rixnobis/ps1-av-capture/hat/renders/crop-buck-ldo.png

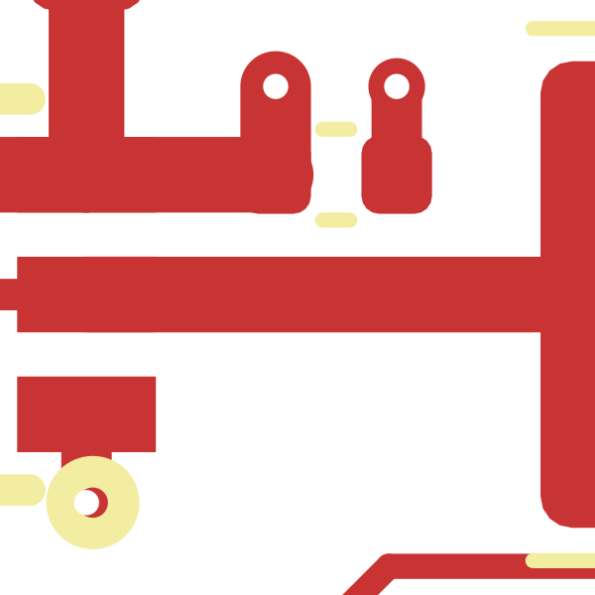
hat/renders/crop-buck-ldo.png
