rixnobis/ps1-av-capture/hat/renders/crop-j3-pcm-usb.png

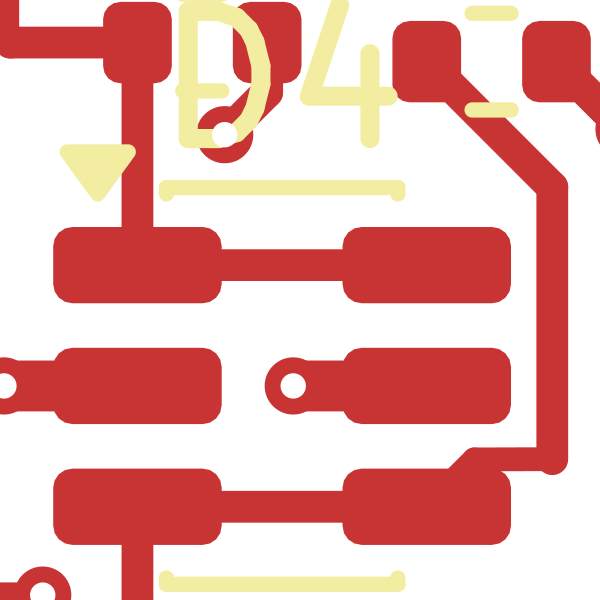
hat/renders/crop-j3-pcm-usb.png
