rixnobis/ps1-av-capture/hat/renders/crop-j4-ctrl.png

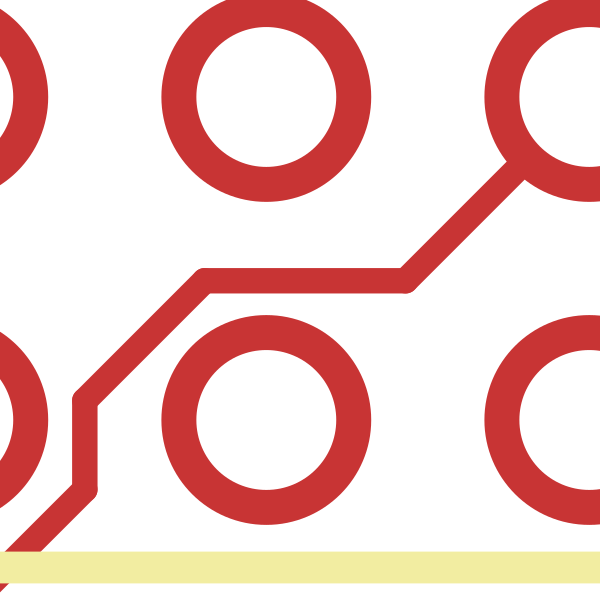
hat/renders/crop-j4-ctrl.png
