rixnobis/ps1-av-capture/hat/renders/crop-j5-data.png

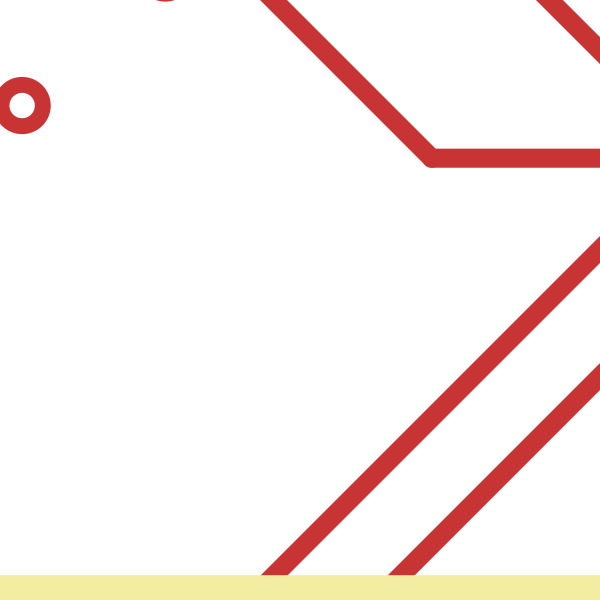
hat/renders/crop-j5-data.png
