rixnobis/ps1-av-capture/hat/renders/crop-tvp-22r.png

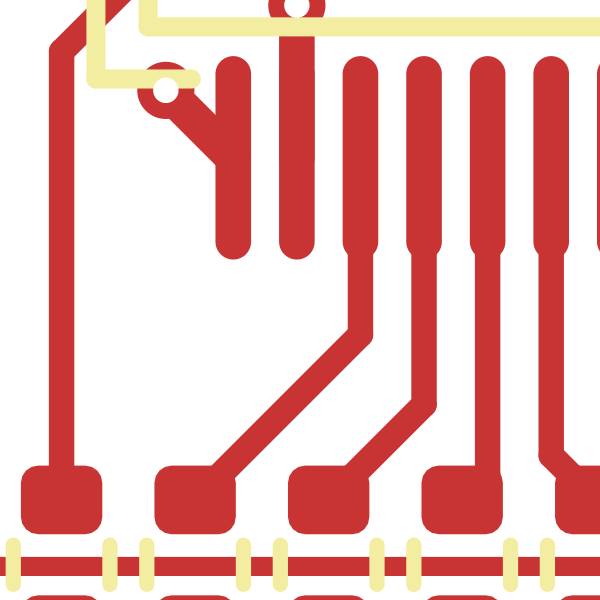
hat/renders/crop-tvp-22r.png
