rixnobis/ps1-av-capture/hat/renders/placement.png

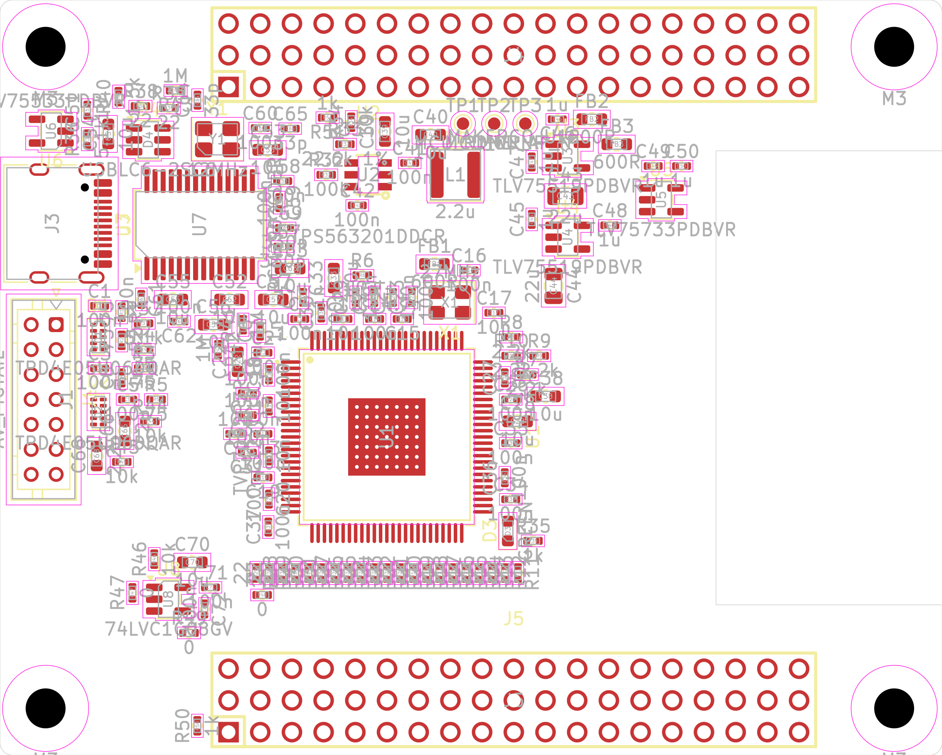
hat/renders/placement.png
