rixnobis/ps1-av-capture/hat/renders/route-bottom.png

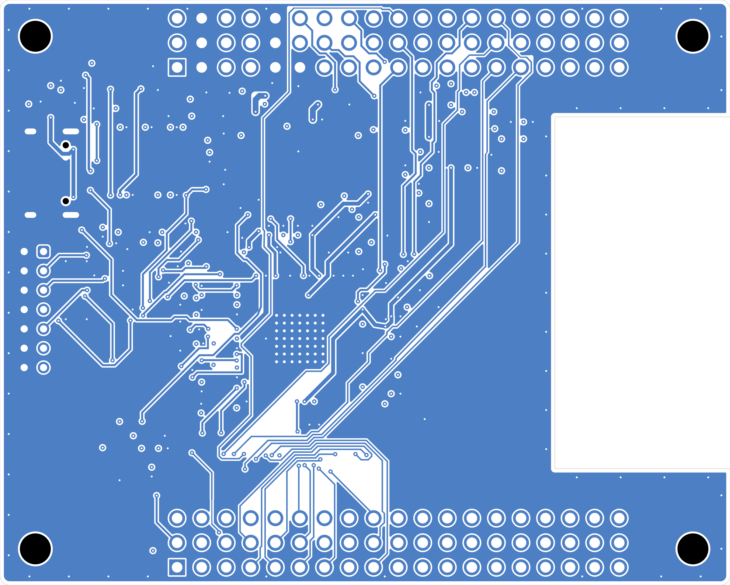
hat/renders/route-bottom.png
