rixnobis/ps1-av-capture/hat/renders/route-in2.png

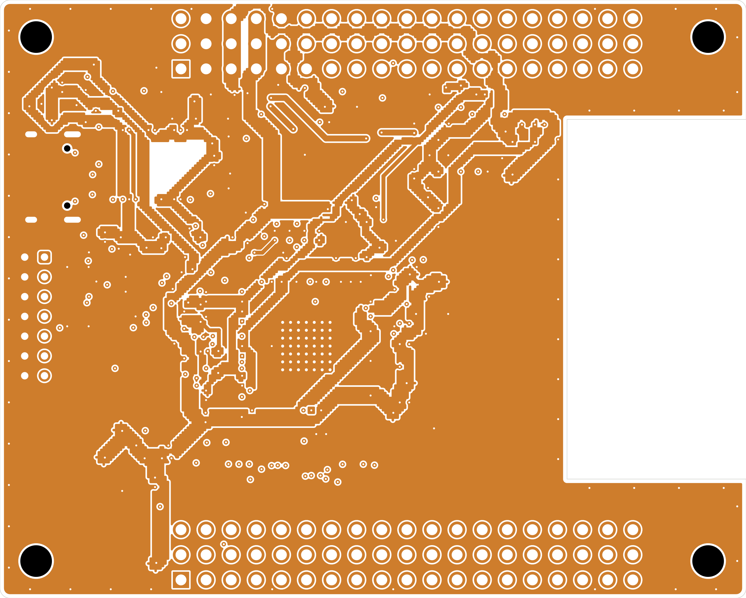
hat/renders/route-in2.png
