rixnobis/ps1-av-capture/hat/renders/route-top.png

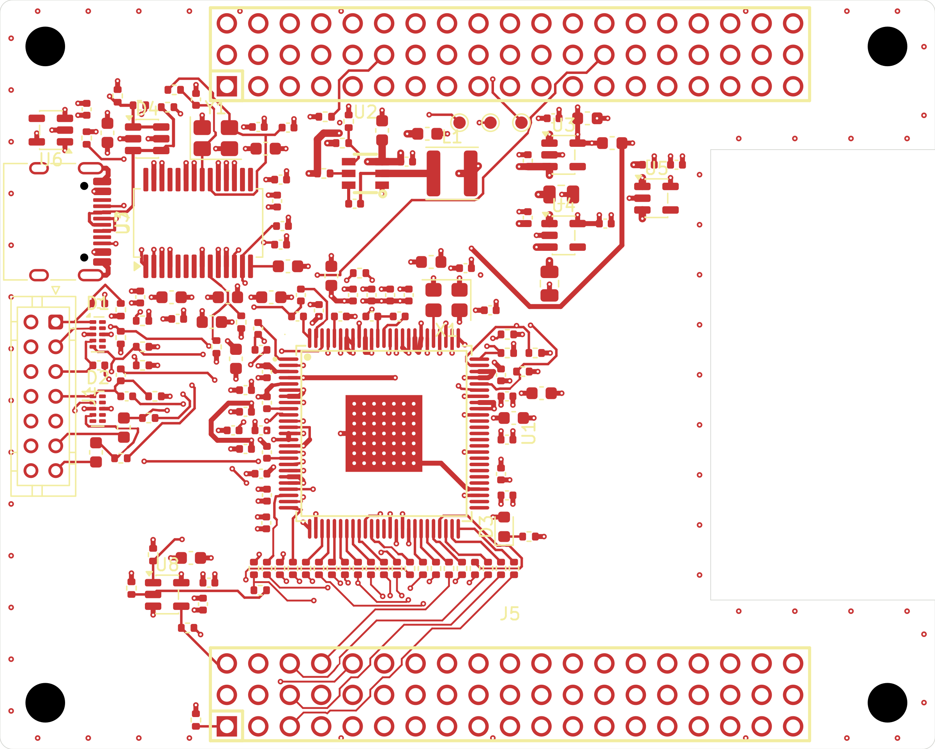
hat/renders/route-top.png
