rixnobis/ps1-av-capture/hat/renders/tidy-a-tvp-north.png

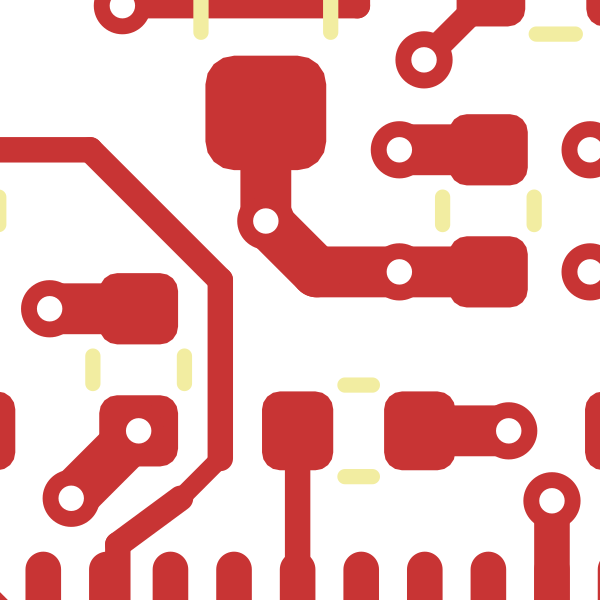
hat/renders/tidy-a-tvp-north.png
