rixnobis/ps1-av-capture/hat/renders/tidy-b-input-west.png

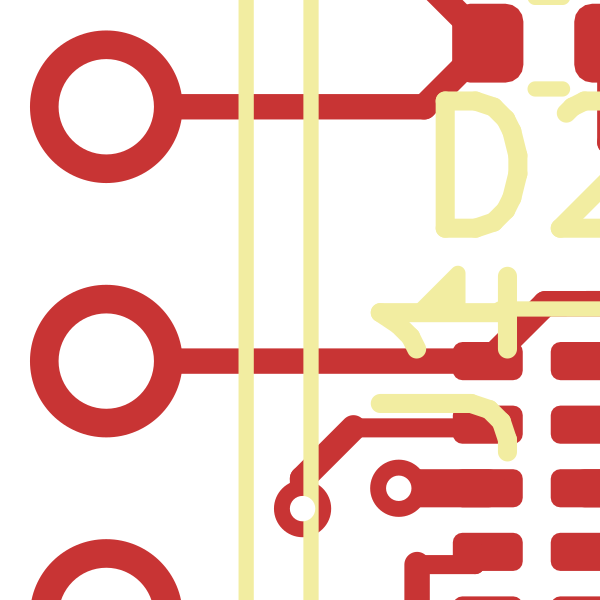
hat/renders/tidy-b-input-west.png
