rixnobis/ps1-av-capture/hat/renders/tidy-c-east.png

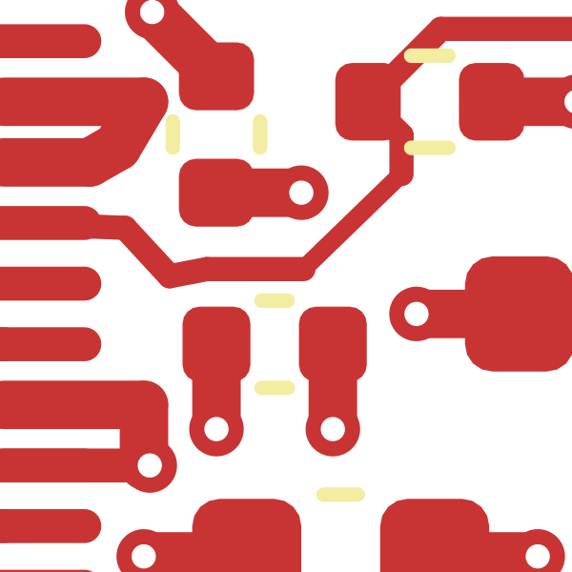
hat/renders/tidy-c-east.png
