rixnobis/ps1-av-capture/renders/placement.png

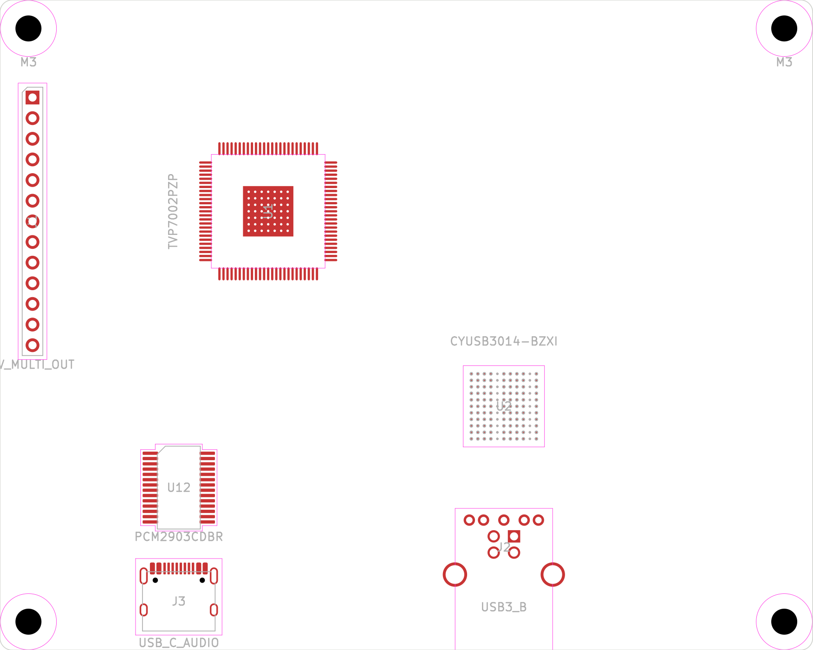
renders/placement.png
