rixnobis/ps1-av-capture/tools/pins/fx3.csv

ball | name
A1 | U3VSSQ
A2 | U3RXVDDQ
A3 | SSRXM
A4 | SSRXP
A5 | SSTXP
A6 | SSTXM
A7 | AVDD
A8 | VSS
A9 | DP
A10 | DM
A11 | NC
B1 | VIO4
B2 | FSLC[0]
B3 | R_USB3
B4 | FSLC[1]
B5 | U3TXVDDQ
B6 | CVDDQ
B7 | AVSS
B8 | VSS
B9 | VSS
B10 | VDD
B11 | TRST#
C1 | GPIO[54]
C2 | GPIO[55]
C3 | VDD
C4 | GPIO[57]
C5 | RESET#
C6 | XTALIN
C7 | XTALOUT
C8 | R_USB2
C9 | OTG_ID
C10 | TDO
C11 | VIO5
D1 | GPIO[50]
D2 | GPIO[51]
D3 | GPIO[52]
D4 | GPIO[53]
D5 | GPIO[56]
D6 | CLKIN_32
D7 | CLKIN
D8 | VSS
D9 | I2C_GPIO[58]
D10 | I2C_GPIO[59]
D11 | NC
E1 | GPIO[47]
E2 | VSS
E3 | VIO3
E4 | GPIO[49]
E5 | GPIO[48]
E6 | FSLC[2]
E7 | TDI
E8 | TMS
E9 | VDD
E10 | VBATT
E11 | VBUS
F1 | VIO2
F2 | GPIO[45]
F3 | GPIO[44]
F4 | GPIO[41]
F5 | GPIO[46]
F6 | TCK
F7 | GPIO[2]
F8 | GPIO[5]
F9 | GPIO[1]
F10 | GPIO[0]
F11 | VDD
G1 | VSS
G2 | GPIO[42]
G3 | GPIO[43]
G4 | GPIO[30]
G5 | GPIO[25]
G6 | GPIO[22]
G7 | GPIO[21]
G8 | GPIO[15]
G9 | GPIO[4]
G10 | GPIO[3]
G11 | VSS
H1 | VDD
H2 | GPIO[39]
H3 | GPIO[40]
H4 | GPIO[31]
H5 | GPIO[29]
H6 | GPIO[26]
H7 | GPIO[20]
H8 | GPIO[24]
H9 | GPIO[7]
H10 | GPIO[6]
H11 | VIO1
J1 | GPIO[38]
J2 | GPIO[36]
J3 | GPIO[37]
J4 | GPIO[34]
J5 | GPIO[28]
J6 | GPIO[16]
J7 | GPIO[19]
J8 | GPIO[14]
J9 | GPIO[9]
J10 | GPIO[8]
J11 | VDD
K1 | GPIO[35]
K2 | GPIO[33]
K3 | VSS
K4 | VSS
K5 | GPIO[27]
K6 | GPIO[23]
K7 | GPIO[18]
K8 | GPIO[17]
K9 | GPIO[13]
K10 | GPIO[12]
K11 | GPIO[10]
L1 | VSS
L2 | VSS
L3 | VSS
L4 | GPIO[32]
L5 | VDD
L6 | VSS
L7 | VDD
L8 | INT#
L9 | VIO1
L10 | GPIO[11]
L11 | VSS
