rixnobis/ps1-av-capture/schematic.pdf

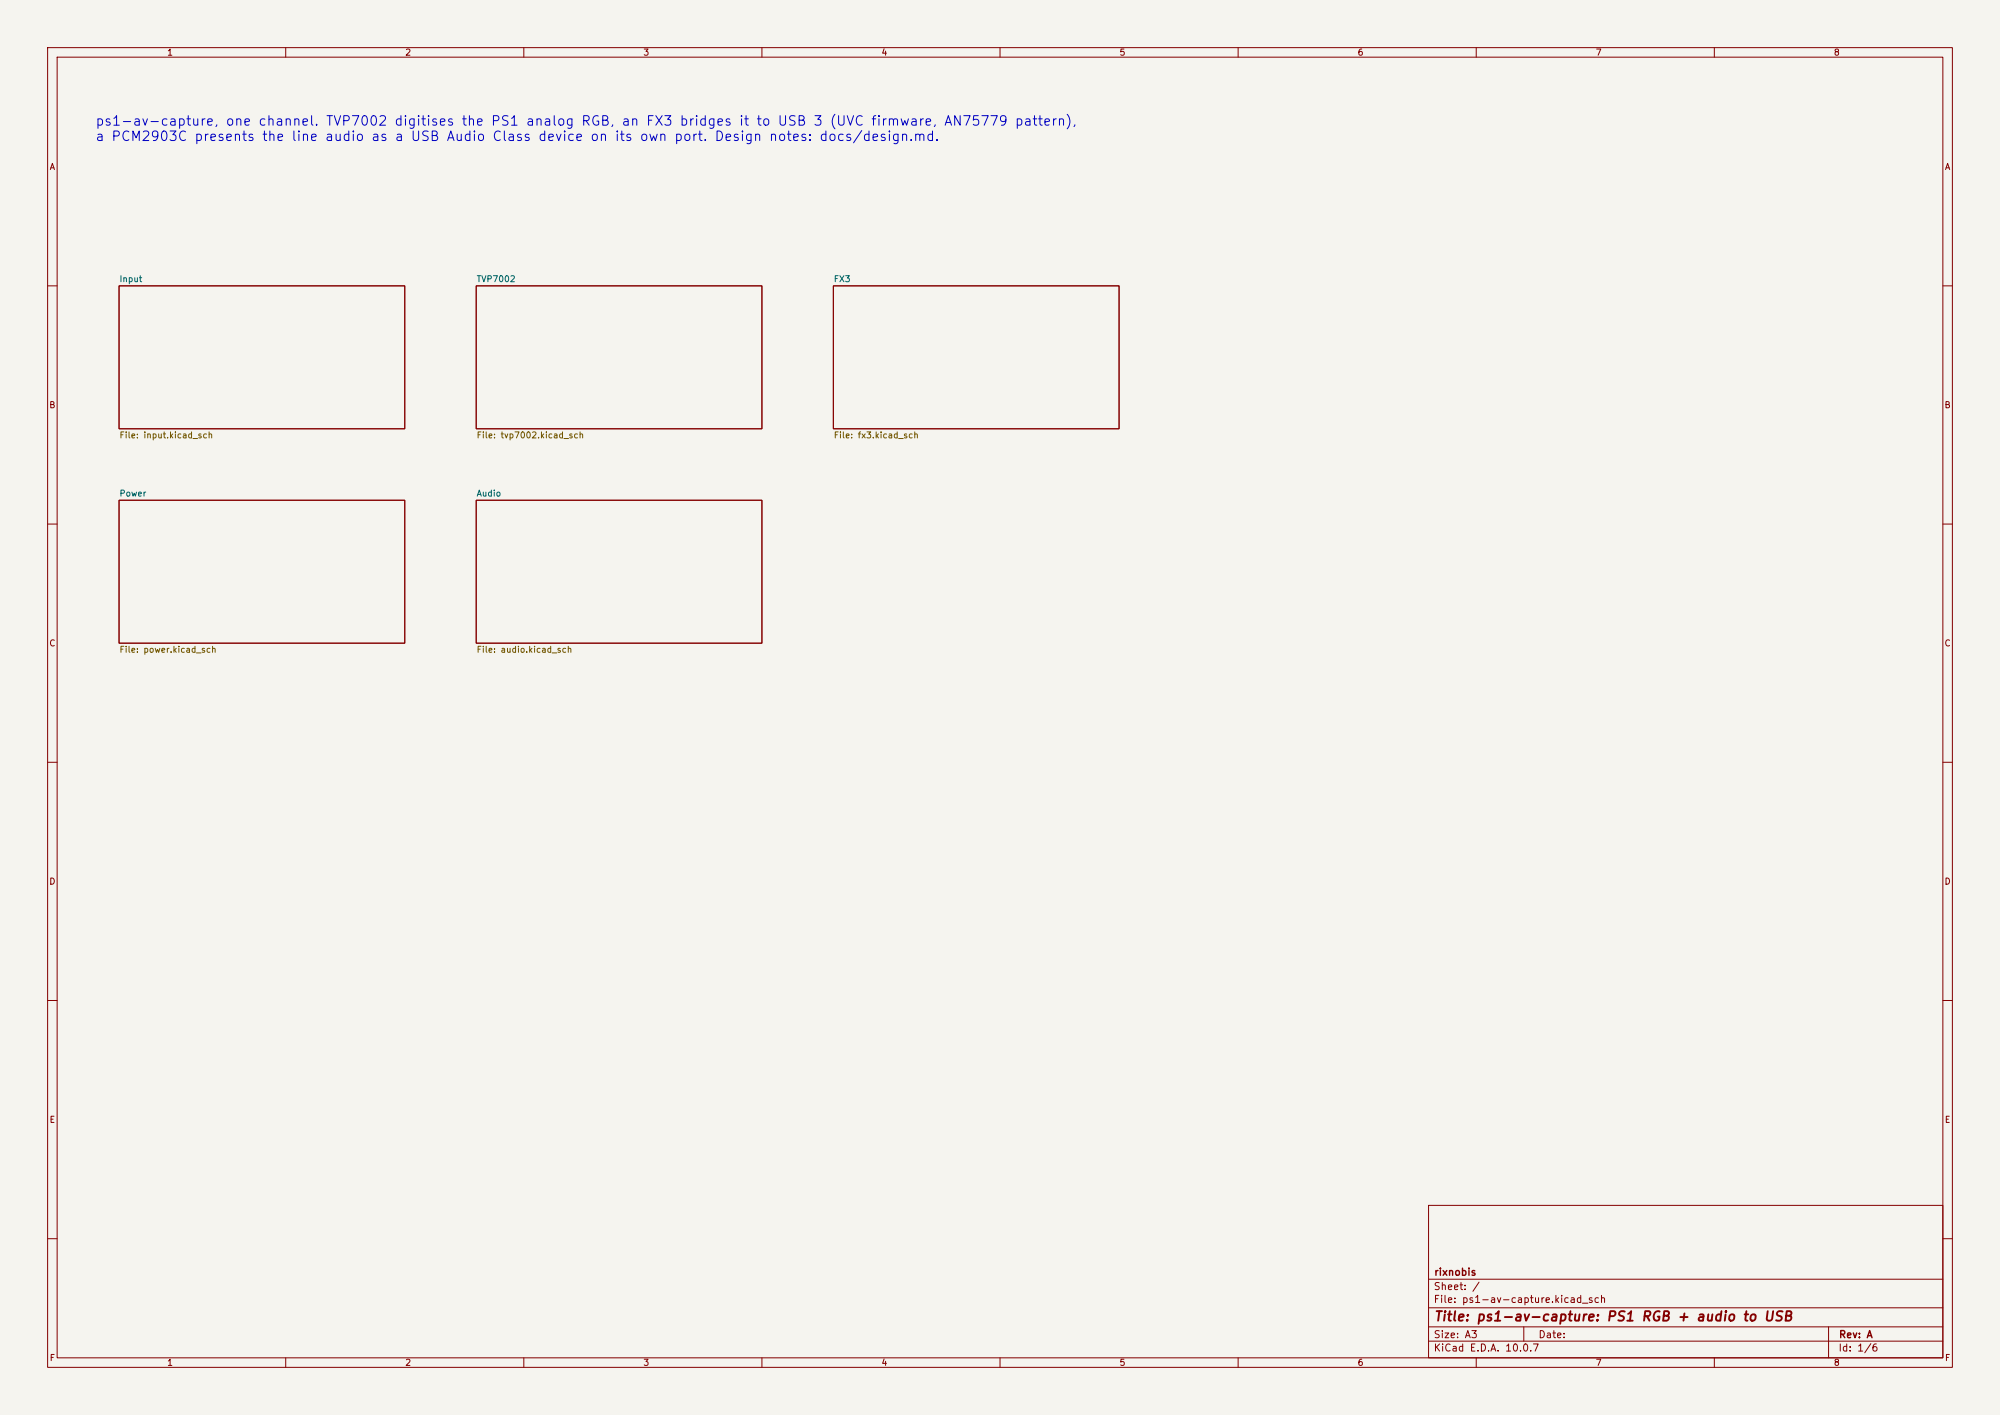
[picture p14: page 1]

File: audio.kicad_sch ps1-av-capture, one channel. TVP7002 digitises the PS1 analog RGB, an FX3 bridges it to USB 3 (UVC firmware, AN75779 pattern), a PCM2903C presents the line audio as a USB Audio Class device on its own port. Design notes: docs/design.md.

File: fx3.kicad_sch Power File: power.kicad_sch

rixnobis
Sheet: /
File: ps1-av-capture.kicad_sch
Title: ps1-av-capture: PS1 RGB + audio to USB

Size: A3 | Rev: A | F Date:
KiCad E.D.A. 10.0.7 | Id: 1/6

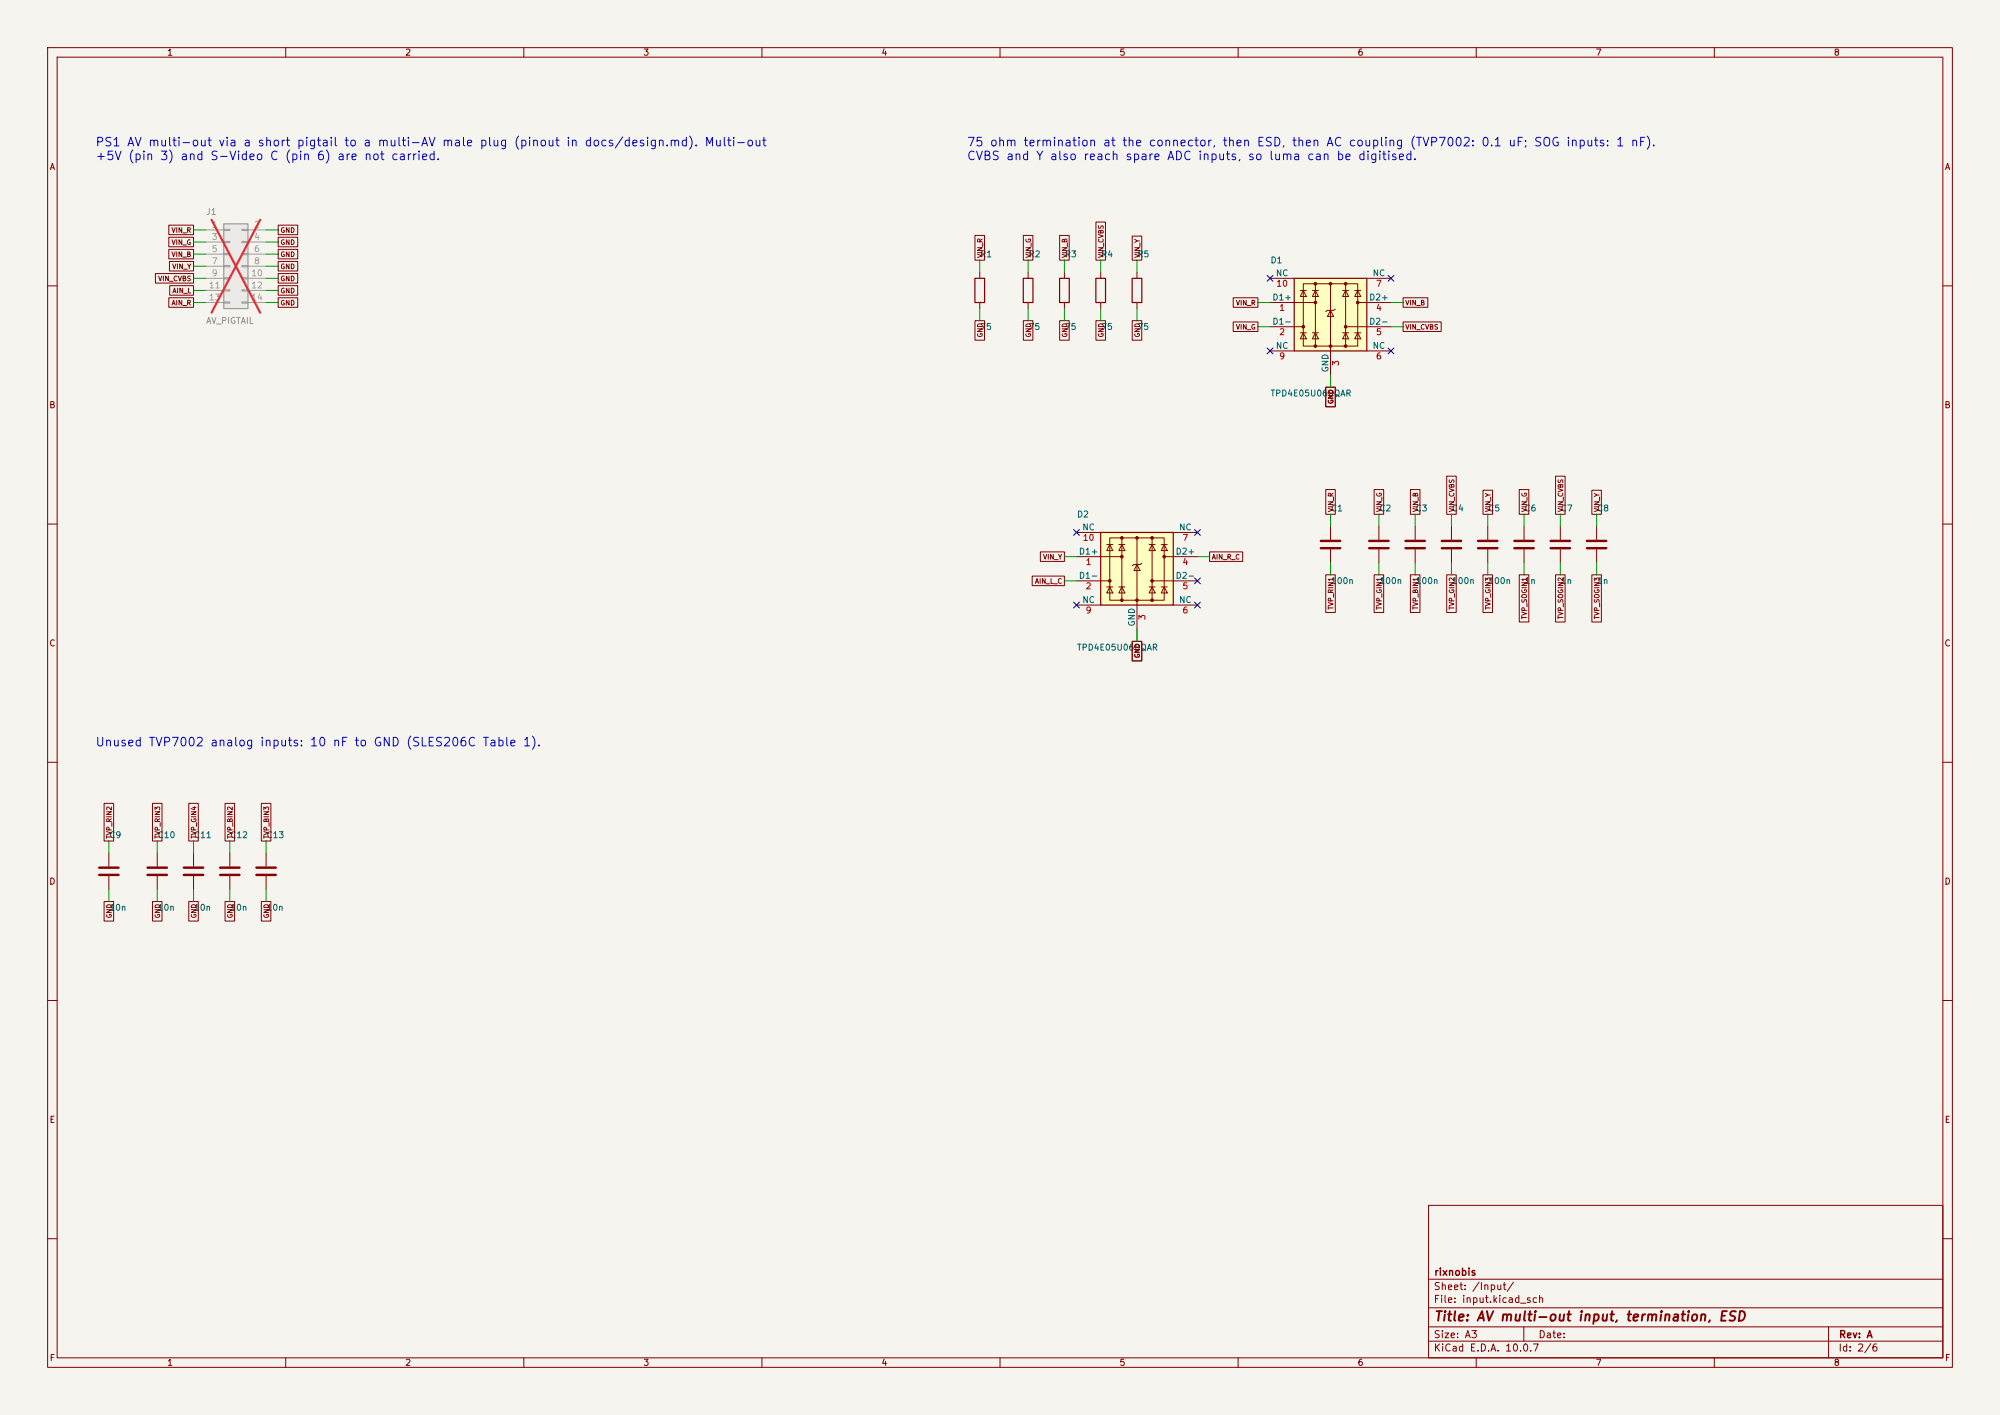
[picture p15: page 2]

PS1 AV multi-out via a short pigtail to a multi-AV male plug (pinout in docs/design.md). Multi-out
+5V (pin 3) and S-Video C (pin 6) are not carried.

75 ohm termination at the connector, then ESD, then AC coupling (TVP7002: 0.1 uF; SOG inputs: 1 nF).
CVBS and Y also reach spare ADC inputs, so luma can be digitised.

Unused TVP7002 analog inputs: 10 nF to GND (SLES206C Table 1).

rixnobis
Sheet: /Input/
File: input.kicad_sch
Title: AV multi-out input, termination, ESD

1 | 2 | 3 | 4 | 5 | 6 | 7 | 8 | 9 | 10 | 11

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
### FGH Date:

Size: A2 | Rev: A

## Title: TVP7002 RGB digitiser

### File: tvp7002.kicad_sch

### Sheet: /TVP7002/

rixnobis

R34

22R13

22

C15

4.7n

C26

100n C27

100n

C14

100n

C24

100n R9

22 | C25

1u R10

22 | R35

22 R11

22 R12

22R33

22 | R14
22 | R15

22 R32

22 R31

22 | C31
100n | C32
100n | C33

10u R16

22 R17

22

SOGIN_1 1 | GIN_1 2 | RIN_3 9 | RIN_2 10 | RIN_1 11 | BIN_3 16 | BIN_2 17 | BIN_1 18
FIDOUT | 22
VSOUT | 23 HSOUT | 24
SOGOUT | 25 PWDN | 70 RESETB | 71
TMS | 72
I2CA | 73
SCL | 74
SDA | 75 CLAMP 76 | COAST 77

VSYNC_A 78
VSYNC_B 79
EXT_CLK 80 | HSYNC_A 81 | HSYNC_B 82

FILT1 87
FILT2 88 | PLL_F 89 | GIN_4 96
SOGIN_3 97 | GIN_3 98
SOGIN_2 99 | GIN_2 100 U1A

TVP7002PZP

C19

100n

AGND 3

AVDD 4
AGND 5

AVDD 6
AVDD 7
AGND | 8
A33GND | 12 A33VDD 13
A33VDD 14 | A33GND | 15
AVDD 19 | AGND | 20 NSUB | 21 IOVDD 26
IOGND | 27 DVDD 39 | GND | 40 IOVDD 41
IOGND | 42 IOVDD 53
IOGND | 54
IOGND | 60 IOVDD 66
IOGND | 67 GND | 68 DVDD 69 | PLL_AGND | 83 PLL_AVDD 84 | PLL_AVDD 85 | PLL_AGND | 86 PLL_AGND | 90 NSUB | 91
A33GND | 92

A33VDD 93
A33VDD 94

A33GND 95

# EP 101 U1C

TVP7002PZP

C18

100n

FB3

600R

C20

100n C38

10u C37

100n | C21
100n | C22

10u

DATACLK | 28 B_9 | 29 B_8 | 30 B_7 | 31 B_6 | 32 B_5 | 33 B_4 | 34 B_3 | 35 B_2 | 36 B_1 | 37 B_0 | 38 G_9 43 | G_8 44 | G_7 45 | G_6 46 | G_5 47 | G_4 48 | G_3 | 49 G_2 | 50 G_1 | 51 G_0 | 52 R_9 55 | R_8 56 | R_7 57 | R_6 58 | R_5 59 | R_4 61 | R_3 62 | R_2 63 | R_1 64 | R_0 65U1B

TVP7002PZP

FB2

600R

R6

1.5k

EN 1 GND

2 OUT 3 Vdd 4

X1
27MHz | R29
22 | C28

10u R28

22

FB1

600R

R8

2.2k R7
2.2k C23

100n C16

100n | C17
10n | C30

100n R24

22 R23

22 R37

22 | C36

100n C35

100n R25

22 R22

22 R21

22 R36

22 | R20
22 | R26
22 | R27

22 R18

22 | C29
100n | C34

100n R19

22 R30

22

GND | VD_SOG | VD_R3 | TVP_PLLVDD

GND

GND | VD_R4
GND | TVP_AVDD TVP_R2 | TVP_AVDD

GND

GND | +1V9A

GND

GND | TVP_AVDD GND | TVP_R6
OSC_VDD | TVP_SOGOUT | TVP_G9
TVP_EXTCLK | GND
GND | GND
GND | GND | GND TVP_AVDD | TVP_AVDD
GND | +1V9A TVP_R3

GND

GND | TVP_R4

GND

GND

GND | VD_R2
GND | GND
GND | +3V3

GND

GND | +3V3 | TVP_AVDD
GND | TVP_B7 VD_B2 | VD_G7 TVP_R9 VD_B3 | TVP_G5 TVP_DATACLK VD_B4 | VD_B5 | TVP_G6 VD_VS TVP_B5 | TVP_B6 | VD_FID TVP_R8 | TVP_B8 VD_B8 | VD_G5 VD_R7 | VD_B9 | VD_G4 TVP_G3 VD_G2 | VD_G3 VD_R9 | TVP_B9 | TVP_G2 VD_R8 | VD_B7 | TVP_R5 OSC_VDD | GND | TVP_G4 | VD_G8 | VD_G9 | VD_R6 +3V3 | OSC_VDD | OSC_VDD | VD_HS VD_PCLK GND OSC_VDD | TVP_G8 TVP_FIDOUT VD_B6 TVP_R7 | TVP_VSOUT | TVP_G7 VD_G6 | VD_R5 TVP_B2 | TVP_B3 | TVP_B4 | TVP_HSOUT
GND | GND TVP_FILT1 | TVP_FILT1R
TVP_B3 | TVP_FILT2 | GND
+3V3A | GND GND
TVP_DATACLK | GND TVP_PLLF | TVP_PLLF | GND +1V9D | GND +1V9D TVP_RESETn | GND TVP_PWDN
TVP_EXTCLK | GND

# TVP_SOGIN1 GND

TVP_GIN1

TVP_RIN3

TVP_RIN2

TVP_FIDOUT GND

TVP_VSOUT | +3V3A | GND | GND

TVP_B9

TVP_G3

TVP_G2 | TVP_FILT1R TVP_B4
TVP_G6 | GND

TVP_B5

TVP_G5 | +3V3A
TVP_G4 | +3V3 GND
TVP_RIN1 | +3V3A

TVP_B6

TVP_B7 | +3V3A

TVP_R9

TVP_B8

TVP_R8

TVP_R7

TVP_R6

TVP_R5

TVP_R4

TVP_R3

TVP_R2

TVP_B2

TVP_AVDD

TVP_PLLF

I2C_SCL | +3V3

TVP_GIN4

TVP_SOGIN3

TVP_GIN3

TVP_SOGIN2 | GND | GND | GND
TVP_GIN2 | GND

TVP_AVDD

TVP_AVDD

TVP_SOGOUT +3V3A +3V3A

TVP_AVDD +3V3 | GND
+1V9D +3V3 +3V3 | GND

+3V3 +1V9D

TVP_PLLVDD

TVP_PLLVDD +3V3A

TVP_G8 | +3V3
GND | +1V9D

GND

TVP_RESETn

TVP_BIN1

TVP_G9 | GND | +3V3A
TVP_BIN2 | TVP_PLLVDD
TVP_G7 | TVP_PLLVDD

TVP_PWDN

TVP_BIN3 | TVP_PLLVDD

I2C_SDA

TVP_HSOUT

TVP_FILT2 GND
TVP_FILT1 | Supply decoupling. SLES206C gives no values; this follows the OSSC: ferrites on AVDD and PLL_AVDD,

100n per pin, bulk per rail.

TVP7002. Sync comes from SOGIN (composite or luma; the PS1 has no sync pin), so the digital HSYNC/VSYNC inputs are grounded as unused. I2C address B8h (I2CA low).

Control. RESETB is held low by 2.2k until the FX3 firmware releases it, so the TVP7002 stays in

## reset while the FX3 boots from the shared I2C bus (SLES206C: no I2C activity before reset

completes). PWDN 2.2k to GND (Figure 8).

27 MHz reference on EXT_CLK for mode detection (SLES206C recommends 27 MHz; the internal reference is about 6.5 MHz and imprecise).

H-PLL loop filter (SLES206C Figure 4): 1.5k + 100n FILT1-PLL_F, 4.7n FILT2-PLL_F.

Output bus: 22R series at the source (FX3 AN70707 checklist item 9). Top 8 bits of each channel. 4:4:4 uses DQ[23:0]; 20-bit 4:2:2 uses DQ[15:0] (Y on G, CbCr on B).

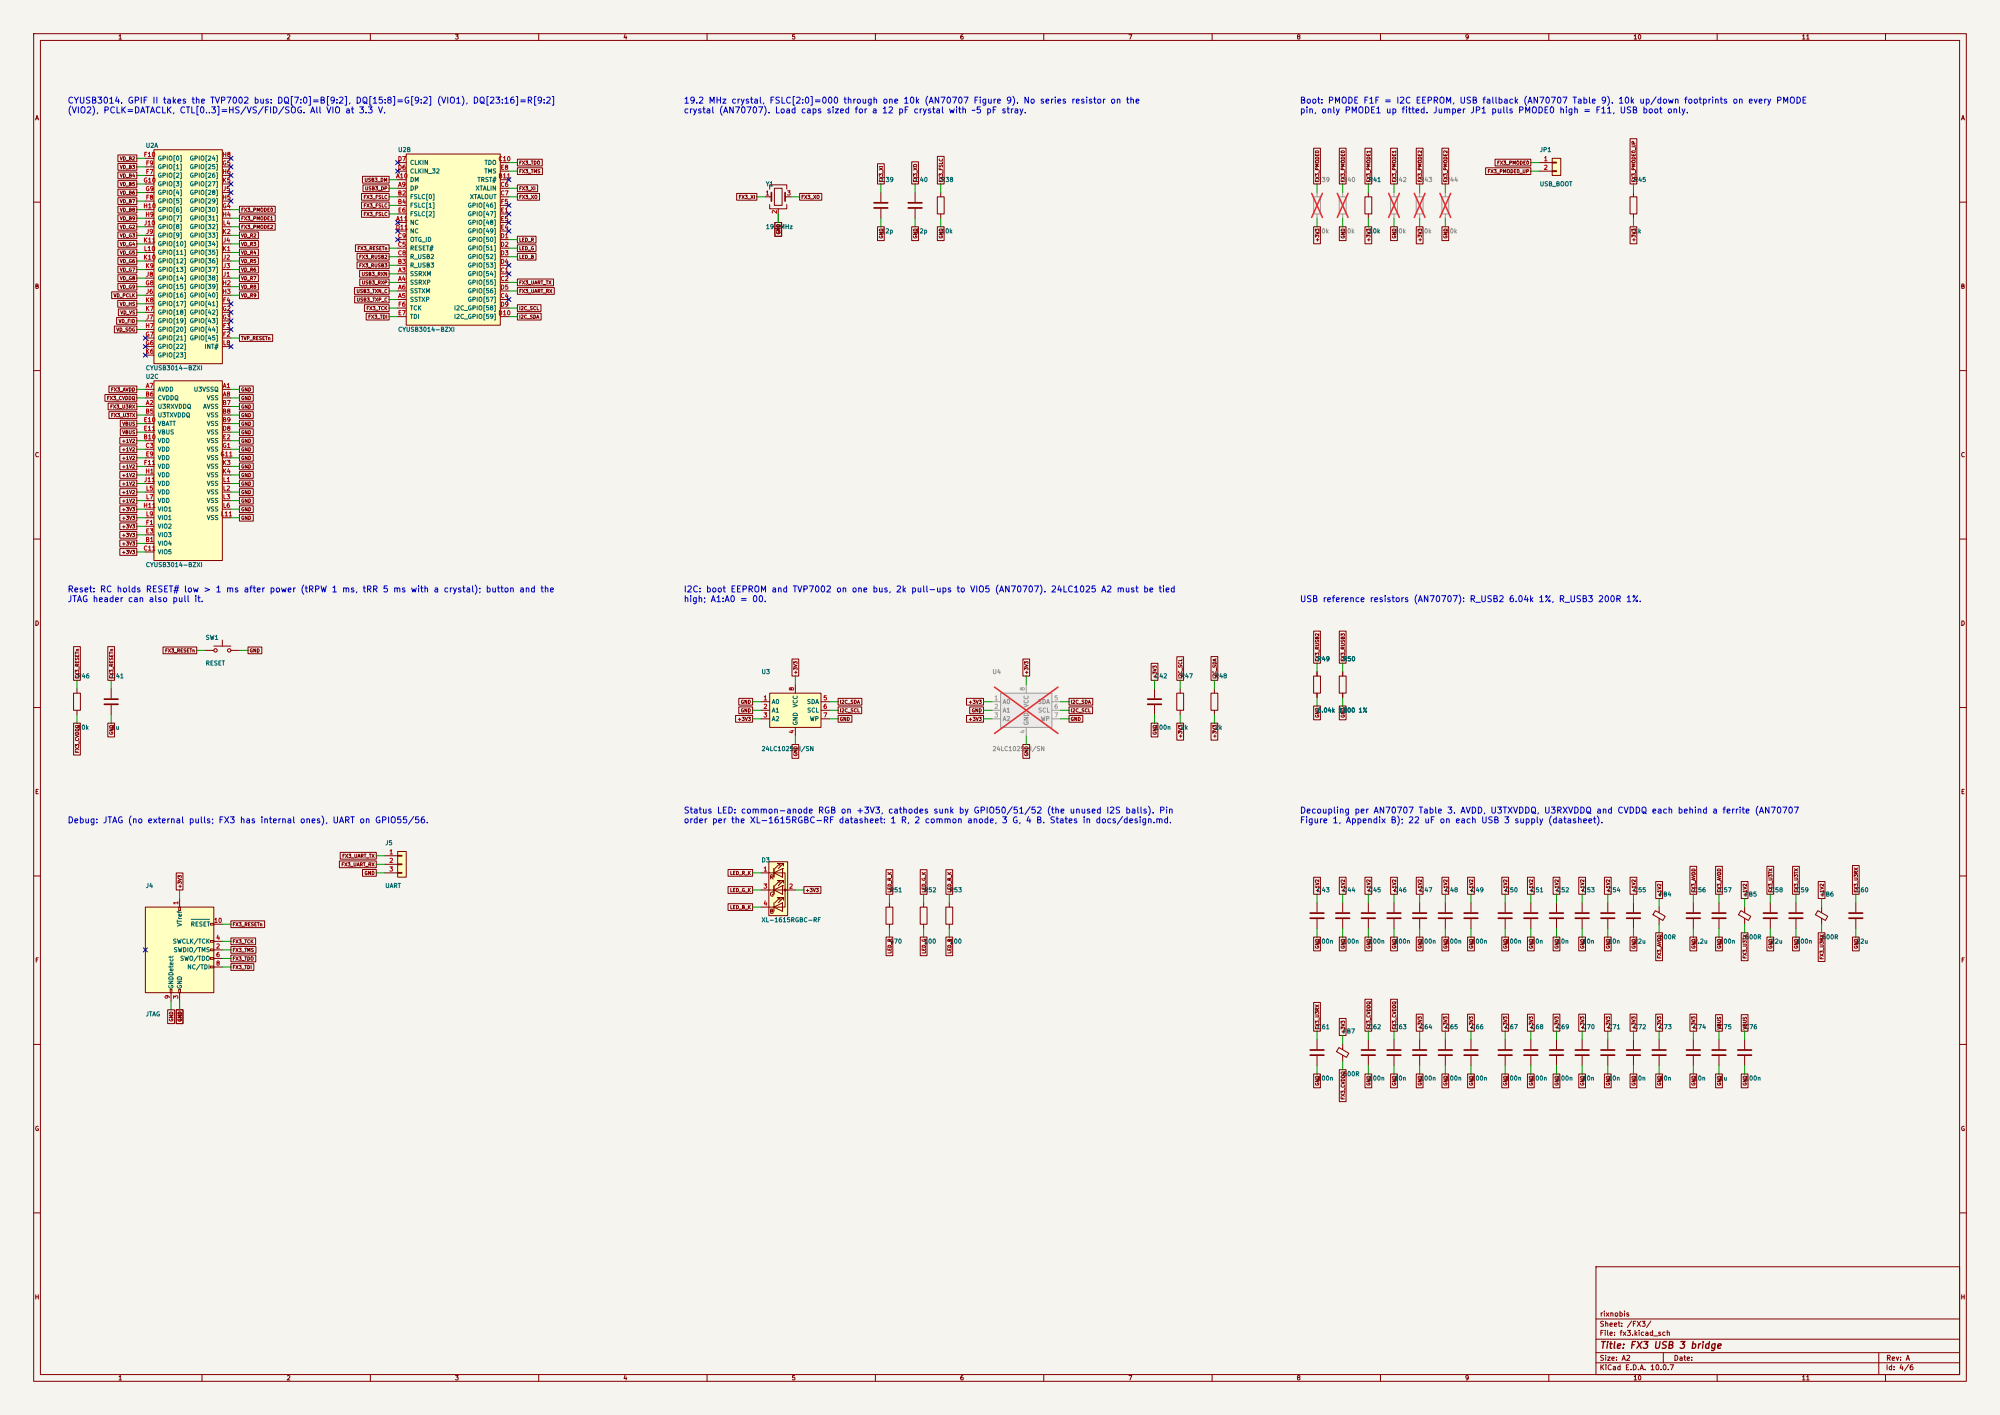
[picture p16: page 4]

CYUSB3014. GPIF II takes the TVP7002 bus: DQ[7:0]=B[9:2], DQ[15:8]=G[9:2] (VIO1), DQ[23:16]=R[9:2]
(VIO2), PCLK=DATACLK, CTL[0..3]=HS/VS/FID/SOG. All VIO at 3.3 V.
VD_B4 FX3_CVDDQ

19.2 MHz crystal, FSLC[2:0]=000 through one 10k (AN70707 Figure 9). No series resistor on the
crystal (AN70707). Load caps sized for a 12 pF crystal with ~5 pF stray.

Boot: PMODE F1F = I2C EEPROM, USB fallback (AN70707 Table 9). 10k up/down footprints on every PMODE
pin, only PMODE1 up fitted. Jumper JP1 pulls PMODE0 high = F11, USB boot only.
FX3_PMODE0_UP

Reset: RC holds RESET# low > 1 ms after power (tRPW 1 ms, tRR 5 ms with a crystal); button and the

I2C: boot EEPROM and TVP7002 on one bus, 2k pull-ups to VIO5 (AN70707). 24LC1025 A2 must be tied
high; A1:A0 = 00.

Status LED: common-anode RGB on +3V3, cathodes sunk by GPIO50/51/52 (the unused I2S balls). Pin

Figure 1, Appendix B); 22 uF on each USB 3 supply (datasheet).

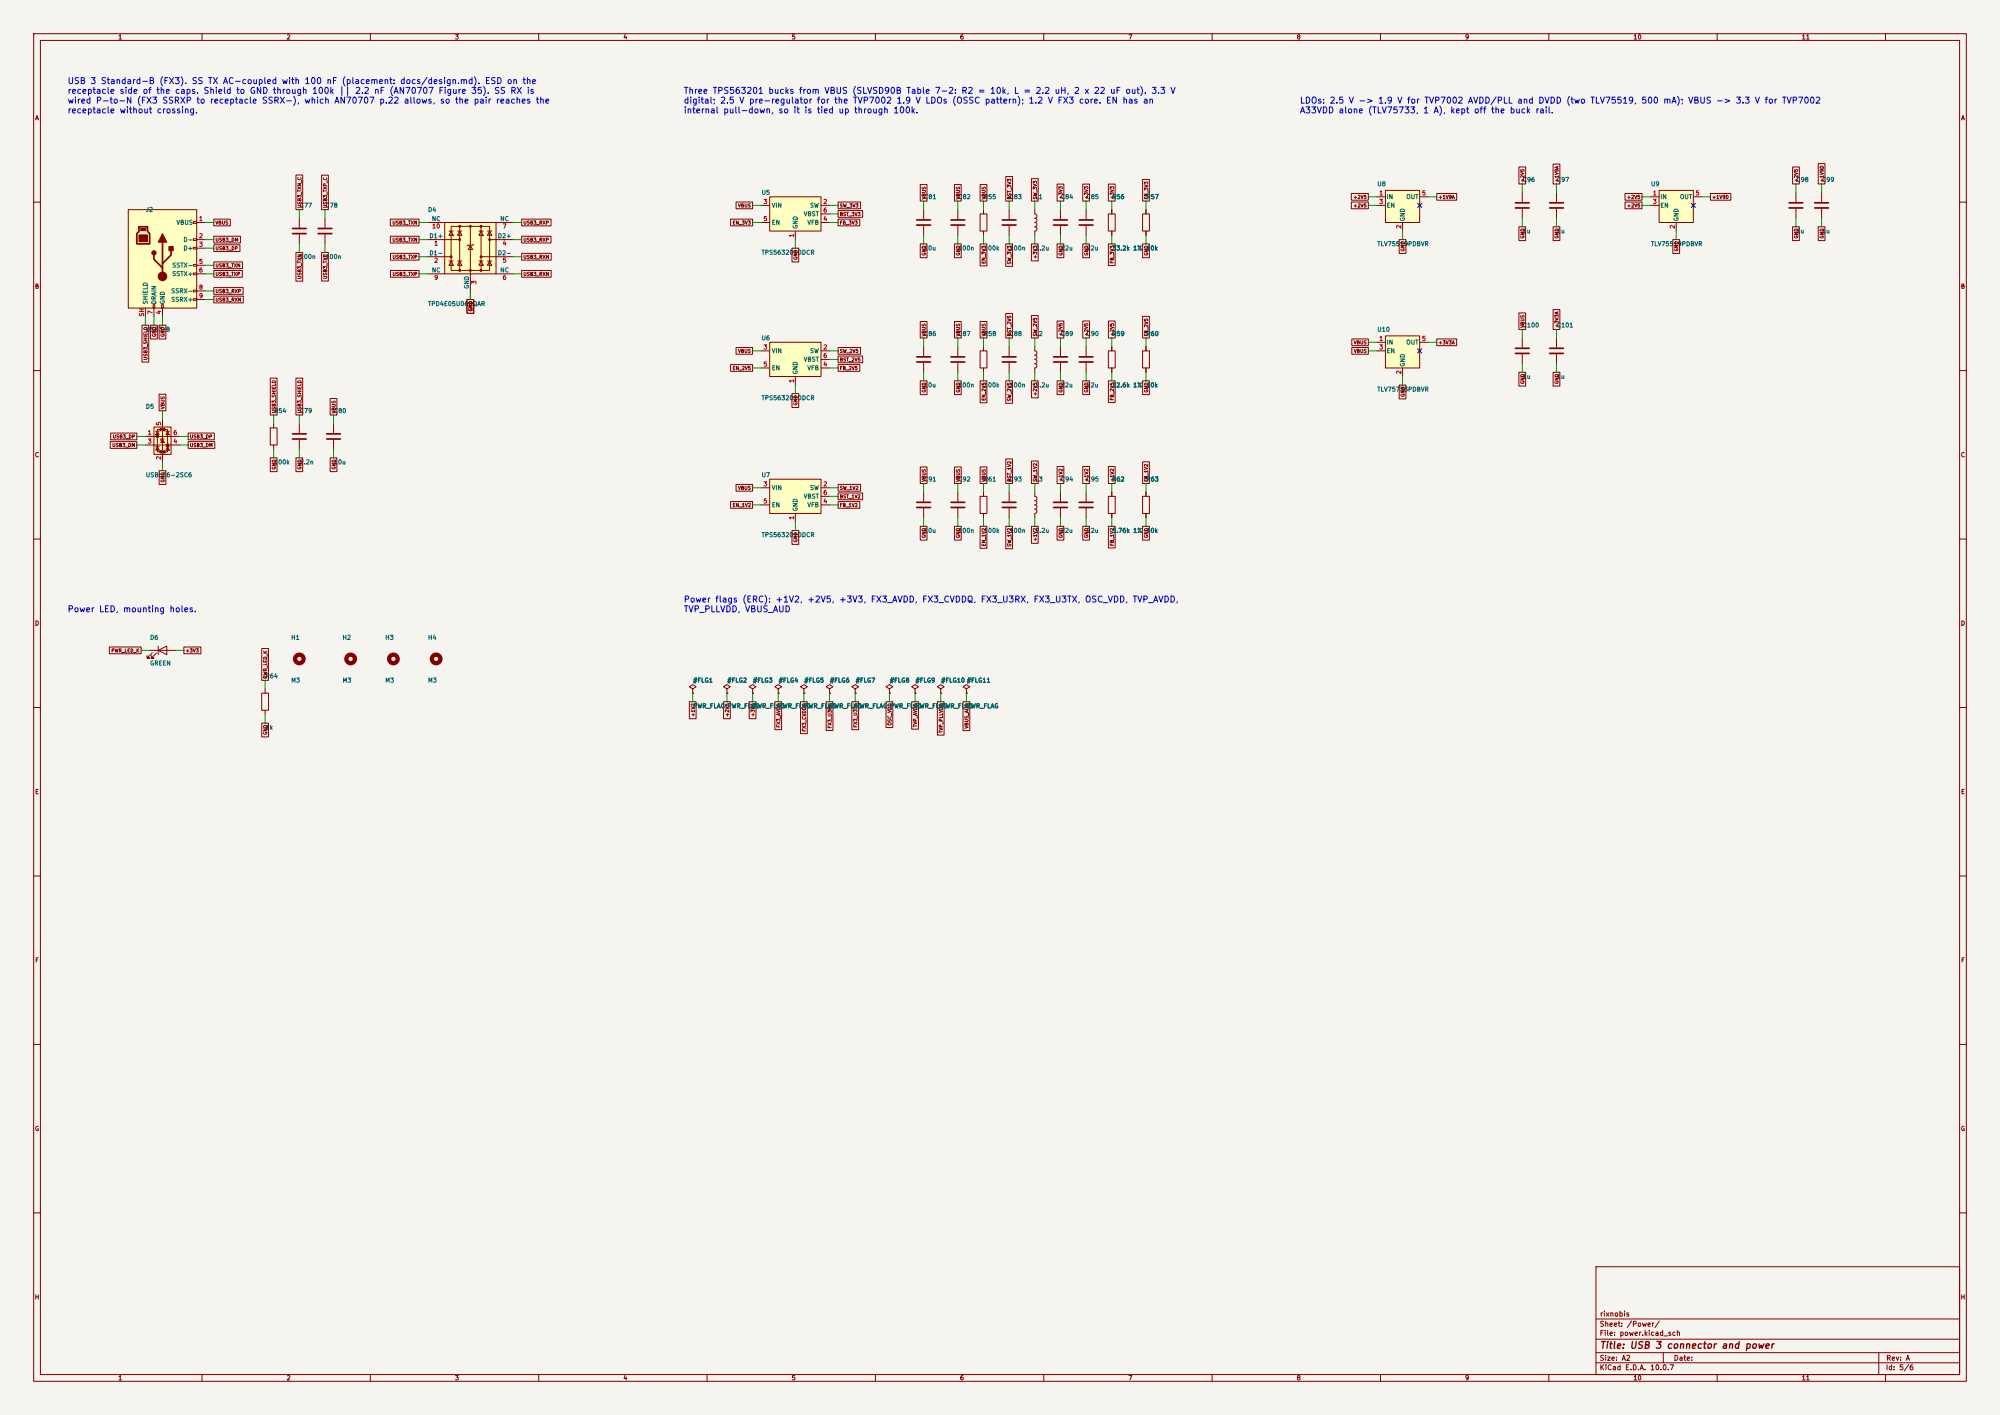
[picture p17: page 5]

USB 3 Standard-B (FX3). SS TX AC-coupled with 100 nF (placement: docs/design.md). ESD on the
receptacle side of the caps. Shield to GND through 100k || 2.2 nF (AN70707 Figure 35). SS RX is
wired P-to-N (FX3 SSRXP to receptacle SSRX-), which AN70707 p.22 allows, so the pair reaches the
receptacle without crossing.

Three TPS563201 bucks from VBUS (SLVSD90B Table 7-2: R2 = 10k, L = 2.2 uH, 2 x 22 uF out). 3.3 V
digital; 2.5 V pre-regulator for the TVP7002 1.9 V LDOs (OSSC pattern); 1.2 V FX3 core. EN has an
internal pull-down, so it is tied up through 100k.

LDOs: 2.5 V -> 1.9 V for TVP7002 AVDD/PLL and DVDD (two TLV75519, 500 mA); VBUS -> 3.3 V for TVP7002
A33VDD alone (TLV75733, 1 A), kept off the buck rail.

Power LED, mounting holes.

Sheet: /Power/
File: power.kicad_sch
Title: USB 3 connector and power

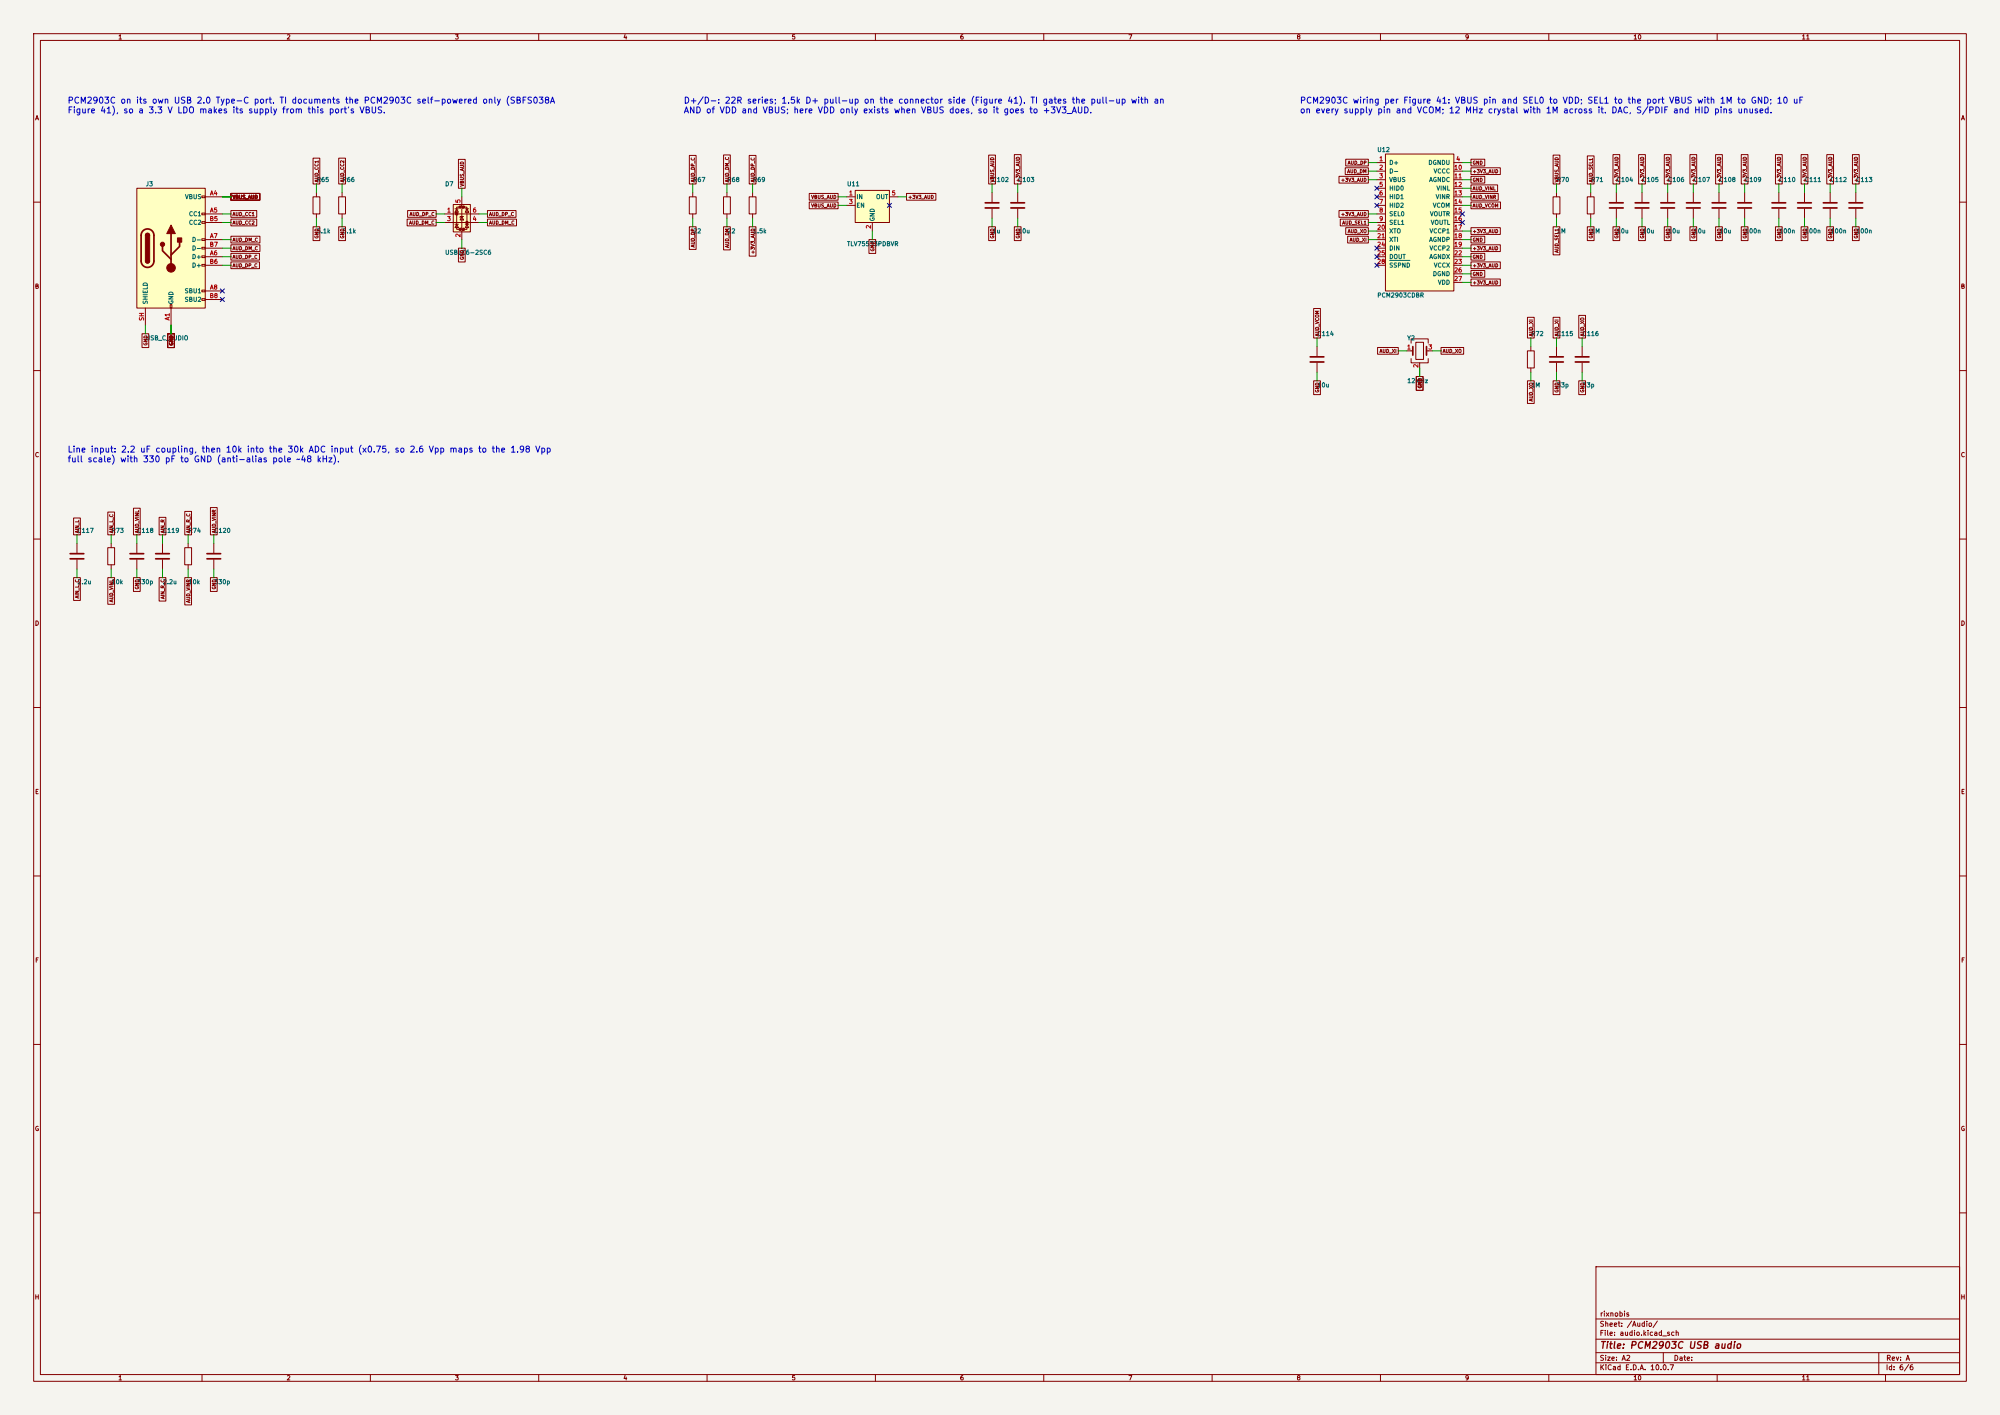
[picture p18: page 6]

PCM2903C on its own USB 2.0 Type-C port. TI documents the PCM2903C self-powered only (SBFS038A
Figure 41), so a 3.3 V LDO makes its supply from this port's VBUS.

D+/D-: 22R series; 1.5k D+ pull-up on the connector side (Figure 41). TI gates the pull-up with an
AND of VDD and VBUS; here VDD only exists when VBUS does, so it goes to +3V3_AUD.

PCM2903C wiring per Figure 41: VBUS pin and SEL0 to VDD; SEL1 to the port VBUS with 1M to GND; 10 uF on every supply pin and VCOM; 12 MHz crystal with 1M across it. DAC, S/PDIF and HID pins unused.
AUD_DP AUD_VCOM GND

AUD_DP_C Line input: 2.2 uF coupling, then 10k into the 30k ADC input (x0.75, so 2.6 Vpp maps to the 1.98 Vpp

full scale) with 330 pF to GND (anti-alias pole ~48 kHz).
