rixnobis/ps1-av-capture/hat/schematic.pdf

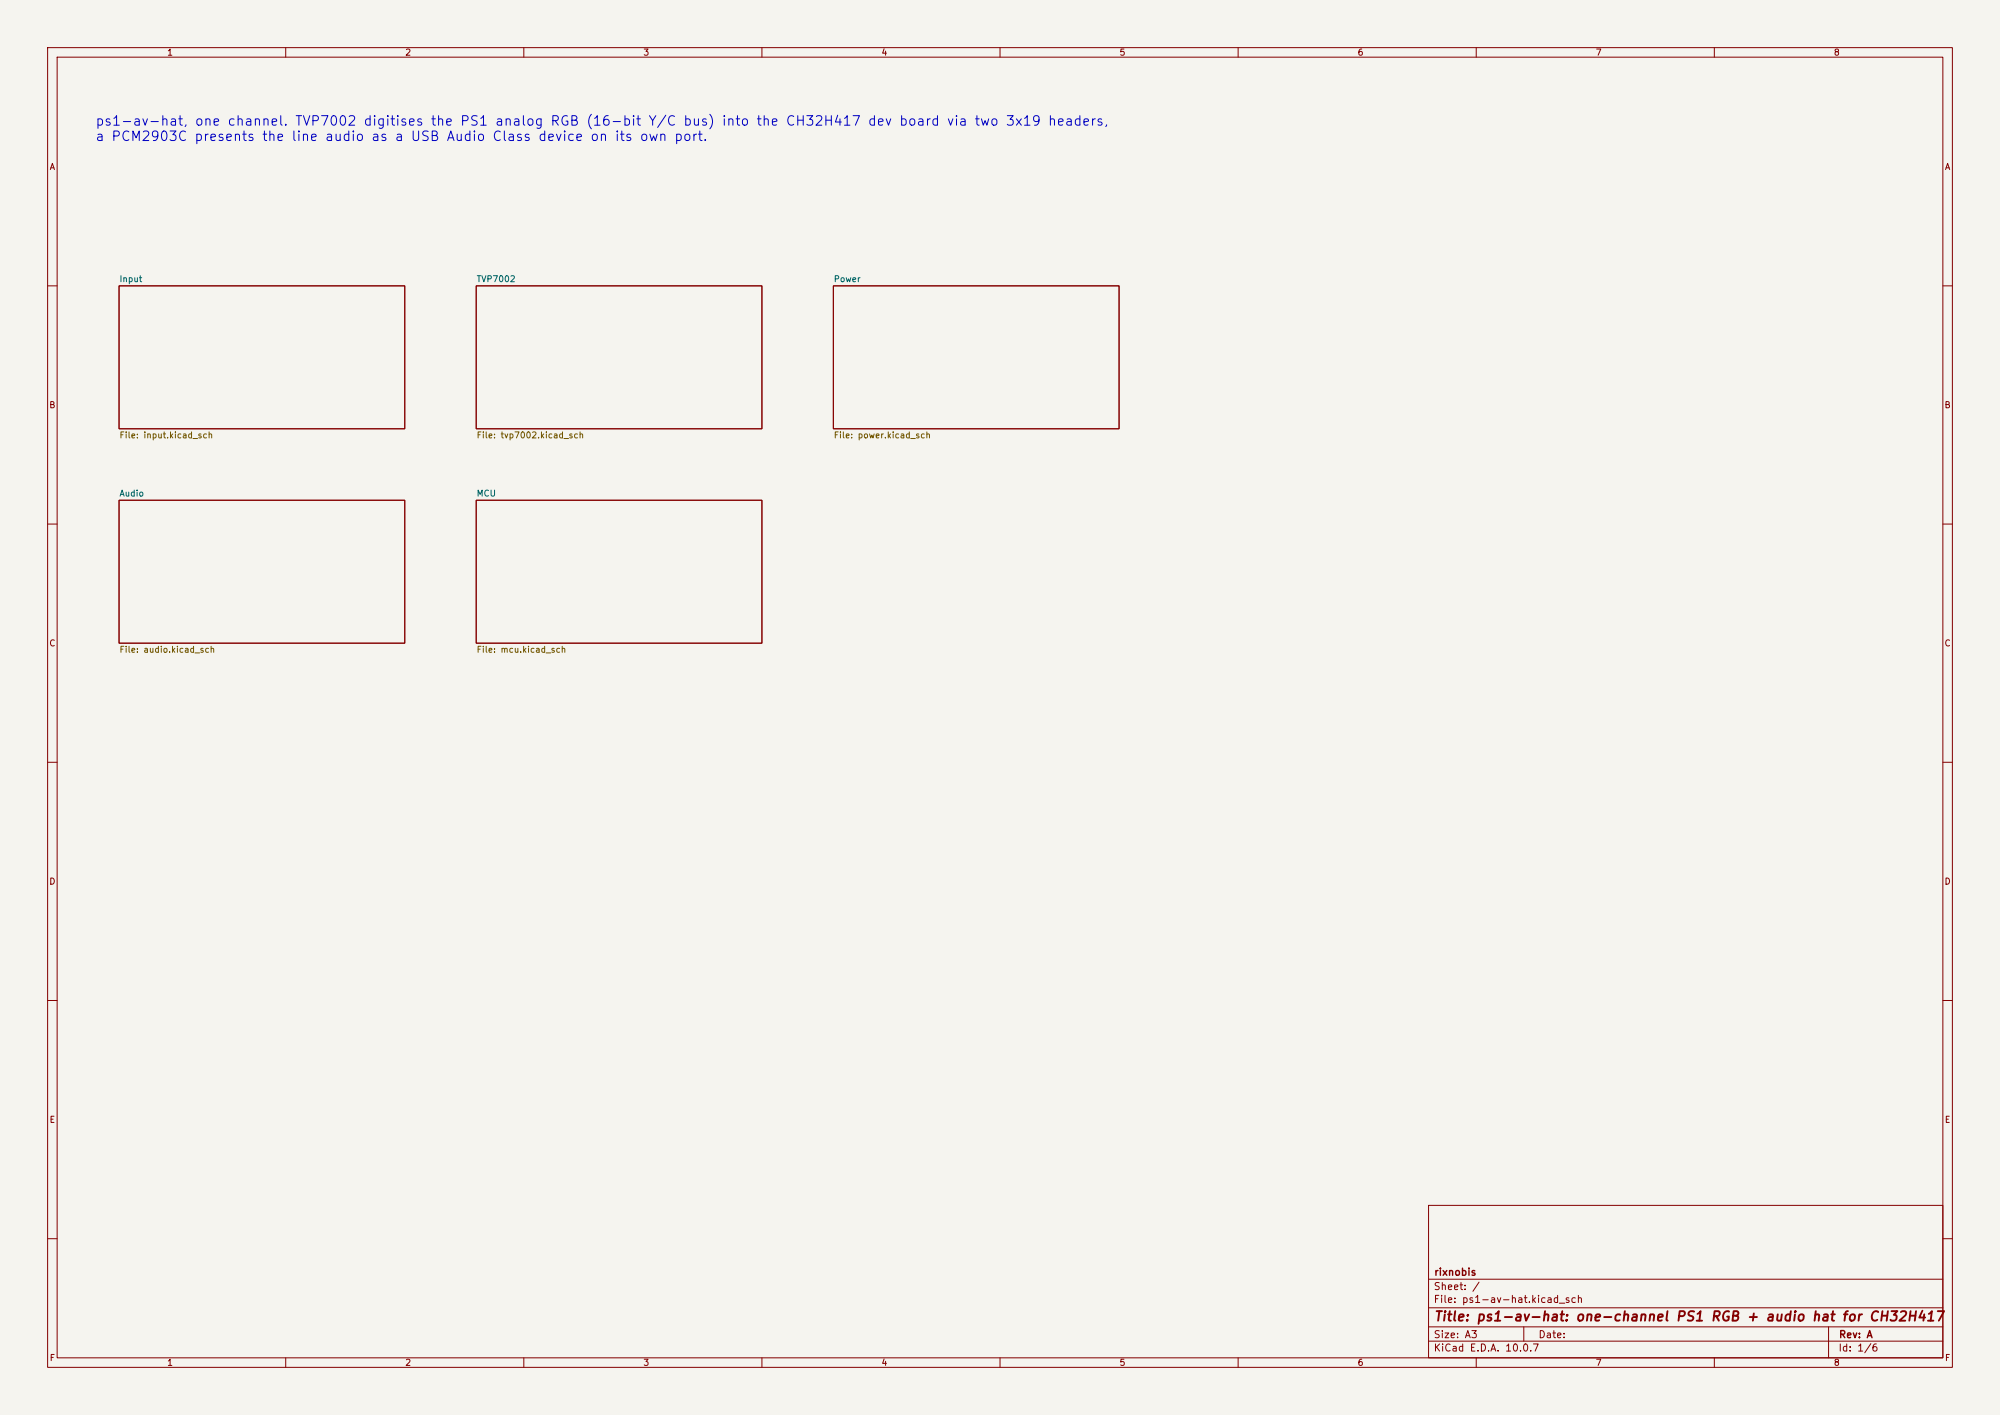
[picture p19: page 1]

File: mcu.kicad_sch ps1-av-hat, one channel. TVP7002 digitises the PS1 analog RGB (16-bit Y/C bus) into the CH32H417 dev board via two 3x19 headers, a PCM2903C presents the line audio as a USB Audio Class device on its own port.

rixnobis
Sheet: /
File: ps1-av-hat.kicad_sch
Title: ps1-av-hat: one-channel PS1 RGB + audio hat for CH32H417

Size: A3 | Rev: A | F Date:
KiCad E.D.A. 10.0.7 | Id: 1/6

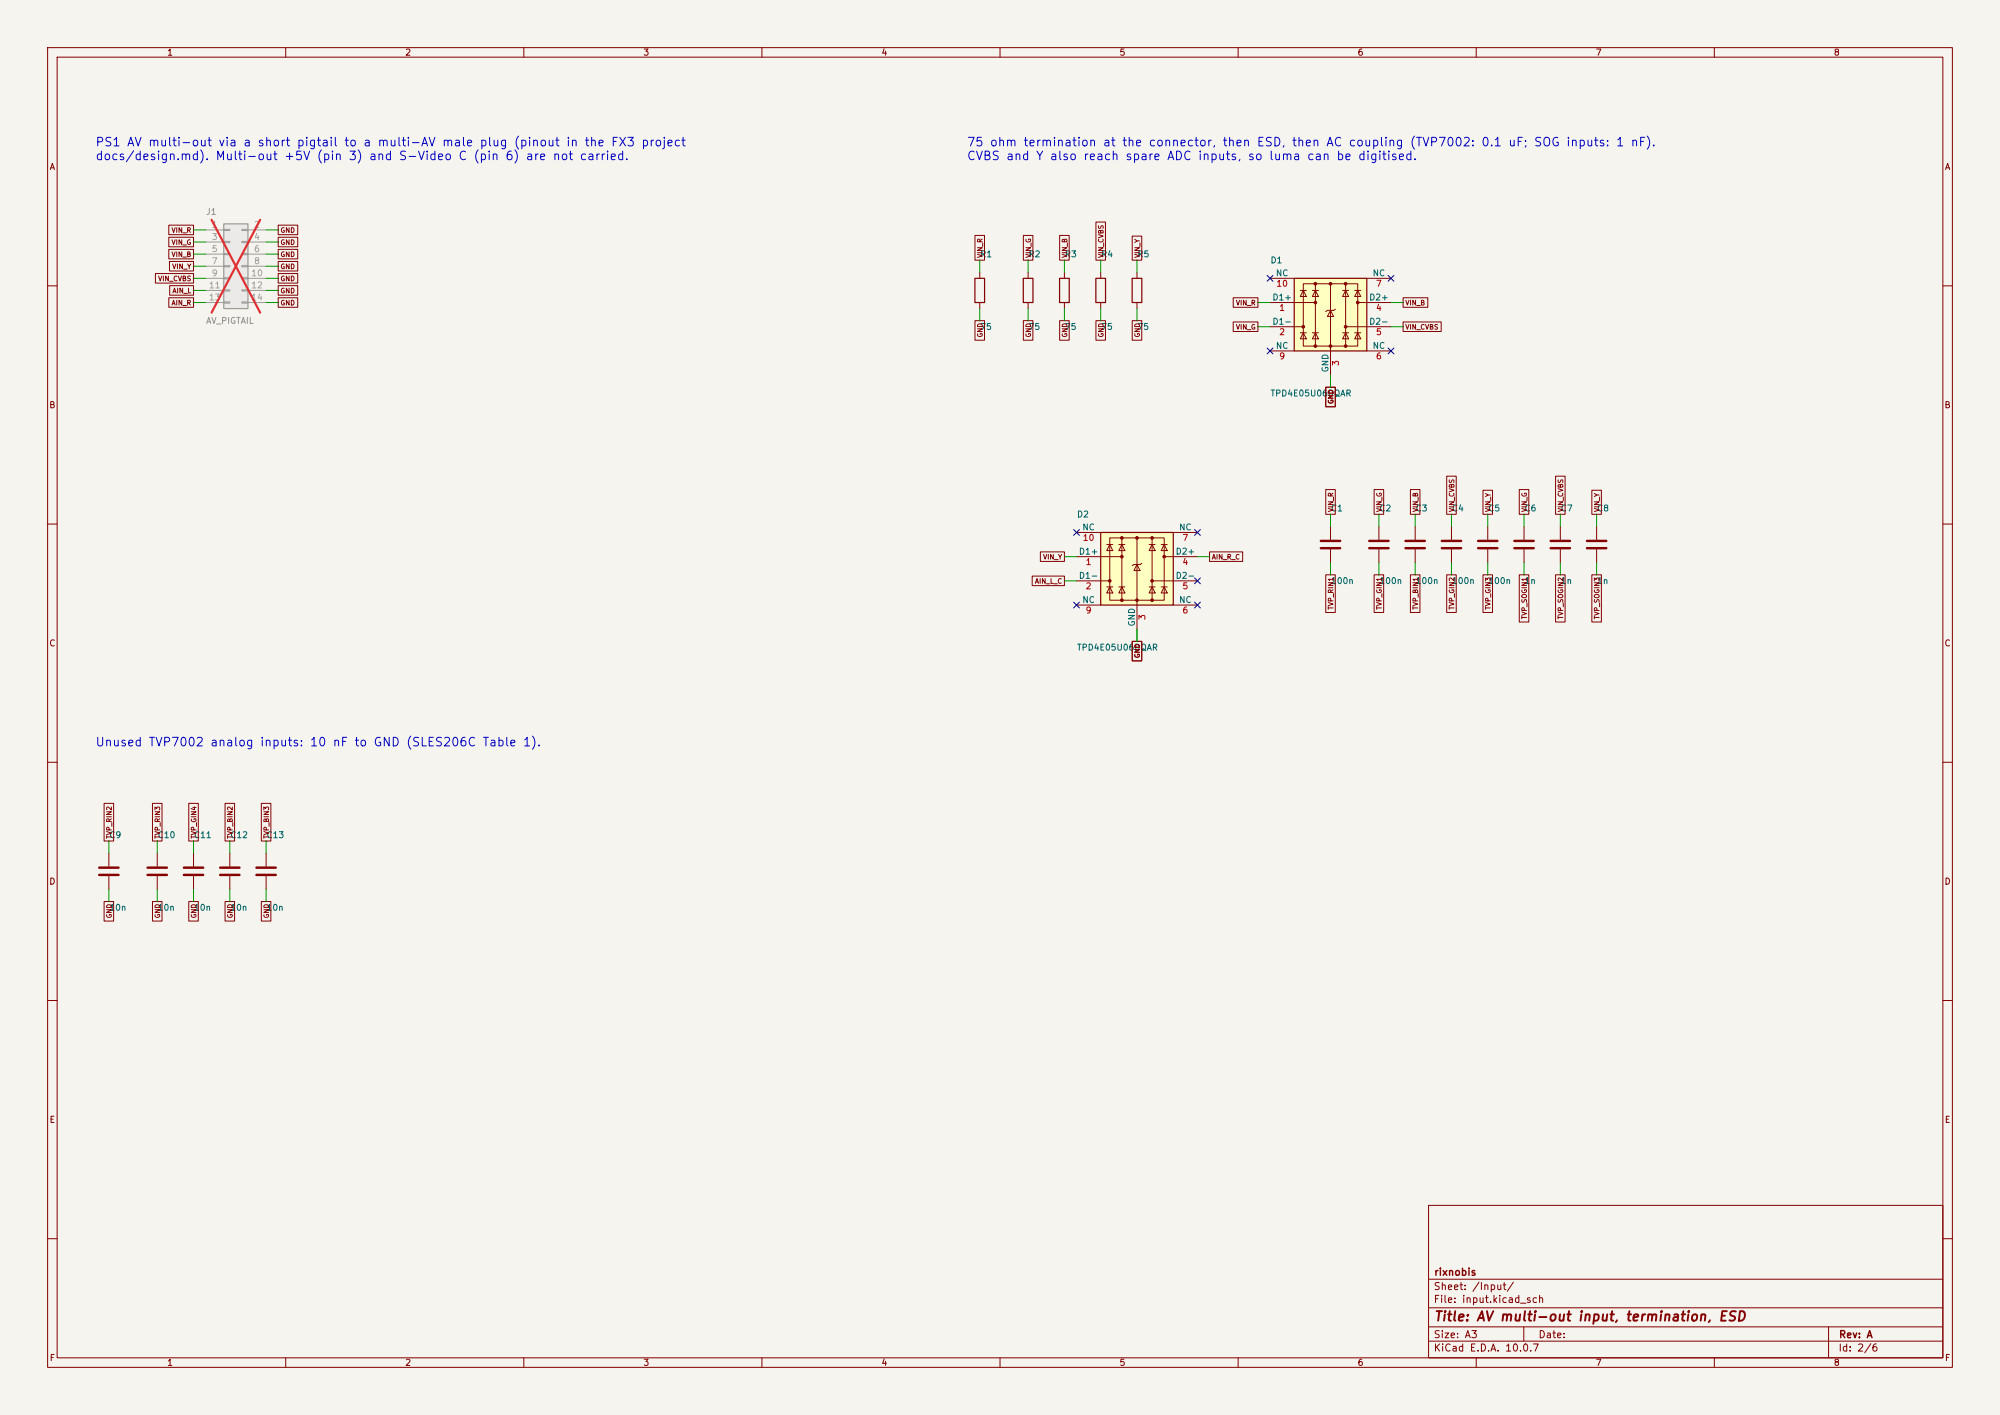
[picture p20: page 2]

PS1 AV multi-out via a short pigtail to a multi-AV male plug (pinout in the FX3 project
docs/design.md). Multi-out +5V (pin 3) and S-Video C (pin 6) are not carried.

75 ohm termination at the connector, then ESD, then AC coupling (TVP7002: 0.1 uF; SOG inputs: 1 nF).
CVBS and Y also reach spare ADC inputs, so luma can be digitised.

Unused TVP7002 analog inputs: 10 nF to GND (SLES206C Table 1).

rixnobis
Sheet: /Input/
File: input.kicad_sch
Title: AV multi-out input, termination, ESD

1 | 2 | 3 | 4 | 5 | 6 | 7 | 8 | 9 | 10 | 11

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
FGH Date:

Size: A2 | Rev: A

### Title: TVP7002 RGB digitiser

File: tvp7002.kicad_sch

Sheet: /TVP7002/

rixnobis

C35

100n C27

100n | C30
100n | R18
22 | R19
22 | R29

22 R11

22 R12

22 C36

100n C26

100n C23

100n | R13
22 | R14
22 R8
2.2k | FB1

600R

C16
100n R10

2.2k R9

2.2k | R17

22 R15

22 R16

22 C31

100n | R31

22 C32

100n

EN 1 GND

2 OUT 3 Vdd 4

X1

27MHz C22

10u | C33
10u | R30

22 C34

100n C28

10u | R27
22 | R28

22 C29

100n C18

100n

FB3

600R

R25

22 R26

22

FB2

600R

C24

100n | R24

22 R23

22 R22

22 R21

22 R20

22 C25

1u C38

10u

AGND 3

AVDD 4
AGND 5

AVDD 6
AVDD 7
AGND | 8
A33GND | 12 A33VDD 13
A33VDD 14 | A33GND | 15
AVDD 19 | AGND | 20 NSUB | 21 IOVDD 26
IOGND | 27 DVDD 39 | GND | 40 IOVDD 41
IOGND | 42 IOVDD 53
IOGND | 54
IOGND | 60 IOVDD 66
IOGND | 67 GND | 68 DVDD 69 | PLL_AGND | 83 PLL_AVDD 84 | PLL_AVDD 85 | PLL_AGND | 86 PLL_AGND | 90 NSUB | 91
A33GND | 92

A33VDD 93
A33VDD 94

A33GND 95

# EP 101 U1C

TVP7002PZP

C37

100n | C20

100n

DATACLK | 28 B_9 | 29 B_8 | 30 B_7 | 31 B_6 | 32 B_5 | 33 B_4 | 34 B_3 | 35 B_2 | 36 B_1 | 37 B_0 | 38 G_9 43 | G_8 44 | G_7 45 | G_6 46 | G_5 47 | G_4 48 | G_3 | 49 G_2 | 50 G_1 | 51 G_0 | 52 R_9 55 | R_8 56 | R_7 57 | R_6 58 | R_5 59 | R_4 61 | R_3 62 | R_2 63 | R_1 64 | R_0 65U1B

TVP7002PZP

SOGIN_1 1 | GIN_1 2 | RIN_3 9 | RIN_2 10 | RIN_1 11 | BIN_3 16 | BIN_2 17 | BIN_1 18
FIDOUT | 22
VSOUT | 23 HSOUT | 24
SOGOUT | 25 PWDN | 70 RESETB | 71
TMS | 72
I2CA | 73
SCL | 74
SDA | 75 CLAMP 76 | COAST 77

VSYNC_A 78
VSYNC_B 79
EXT_CLK 80 | HSYNC_A 81 | HSYNC_B 82

FILT1 87
FILT2 88 | PLL_F 89 | GIN_4 96
SOGIN_3 97 | GIN_3 98
SOGIN_2 99 | GIN_2 100 U1A

TVP7002PZP

C21

100n | C17

10n

C15

4.7n

R7

2.2k

C14

100n R6

1.5k

C19

100n

TVP_HSOUT

TVP_EXTCLK

# TVP_SOGOUT +3V3

TVP_PWDN

# TVP_AVDD GND

TVP_VSOUT

TVP_FIDOUT | OSC_VDD | OSC_VDD GND | GND
GND | OSC_VDD +3V3 | GND

GND +3V3A +3V3A

TVP_PLLVDD

TVP_PLLVDD +1V9D +3V3 +3V3 | GND +1V9D +3V3

TVP_AVDD +3V3A +3V3A

TVP_AVDD

TVP_AVDD

# TVP_SOGIN1 GND

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
# GND OSC_VDD

GND

GND

GND

GND

GND

GND

GND

GND | VD_Y2 TVP_G2 | TVP_G3 | TVP_G4 TVP_PLLF | TVP_PLLF TVP_FILT1 | TVP_FILT1R | TVP_FILT2 | TVP_G5 VD_Y0 | VD_Y1 | VD_Y3 | VD_Y4 | VD_Y5 | VD_Y6 | VD_Y7 | VD_C0 | VD_C3 | VD_C4 | VD_C5 | VD_C6 TVP_B6 | TVP_B7 | TVP_B8 | TVP_B9 VD_C7 TVP_G9 | VD_C1 | VD_C2 TVP_B2 | TVP_B3 | TVP_B4 | TVP_B5 | TVP_DATACLK

TVP_G5

TVP_B5

TVP_B6

TVP_B7

TVP_B8

TVP_B2

TVP_B3

TVP_DATACLK

TVP_G4

TVP_B4

TVP_G6

TVP_G7

TVP_G8

TVP_G9

TVP_RESETn

I2C_SDA

I2C_SCL | VD_HS TVP_G6 | TVP_G7 | TVP_G8 | TVP_HSOUT | TVP_VSOUT | TVP_FIDOUT | TVP_SOGOUT VD_VS
GND | VD_PCLK | VD_SOG VD_FID TVP_FILT1R

TVP_G2

TVP_G3

TVP_B9 GND +1V9D | +1V9D +3V3 | +1V9D GND +1V9A | GND | +3V3 +1V9A | GND TVP_AVDD +3V3 | +3V3 GND GND GND TVP_AVDD TVP_RESETn | TVP_PWDN | I2C_SCL | I2C_SDA | +3V3A GND | GND | GND | GND | GND | GND TVP_PLLVDD | TVP_PLLVDD | TVP_PLLVDD | +3V3A | +3V3 GND | GND +3V3A GND TVP_AVDD | GND +3V3A | GND +3V3A | GND

# TVP_SOGIN2 GND

GND

TVP_EXTCLK

GND

GND +3V3 | TVP_AVDD

TVP_GIN2

TVP_FILT1 TVP_AVDD GND

TVP_RIN2 GND

GND

TVP_GIN3

TVP_SOGIN3

TVP_GIN4

TVP_PLLF

TVP_FILT2 GND

TVP_RIN3

TVP_GIN1

TVP_BIN1

TVP_BIN2 TVP_PLLVDD GND

TVP_BIN3

TVP_RIN1 TVP_AVDD

OSC_VDD +3V3

GND Control. RESETB is held low by 2.2k until the CH32H417 releases it (TVP_RESETn is an MCU GPIO, PA4), so the TVP7002 stays in reset until firmware is up (SLES206C: no I2C activity before reset

completes). PWDN 2.2k to GND (Figure 8). I2C bus: 2.2k pull-ups to +3V3.

Supply decoupling. SLES206C gives no values; this follows the OSSC: ferrites on AVDD and PLL_AVDD, 100n per pin, bulk per rail.

Output bus: 22R series at the source, only the 16 bits used plus clock and syncs. G[9:2] -> VD_Y0..7 (luma), B[9:2] -> VD_C0..7 (chroma); R[9:2] are unconnected.

27 MHz reference on EXT_CLK for mode detection (SLES206C recommends 27 MHz; the internal reference is about 6.5 MHz and imprecise).

H-PLL loop filter (SLES206C Figure 4): 1.5k + 100n FILT1-PLL_F, 4.7n FILT2-PLL_F.

Sync comes from SOGIN (composite or luma; the PS1 has no sync pin), so the digital HSYNC/VSYNC inputs are grounded as unused. I2C address B8h (I2CA low).

TVP7002 on 3.3 V IOVDD. The H417 VIO18 rail MUST be 3.3 V (Maker go R39 fitted 0R, or firmware PWR_CTLR VIO18=3.3V) before RESETB is released: TVP IOVDD is 3.3 V and the VIO18 pins are not 5V/over-voltage tolerant.

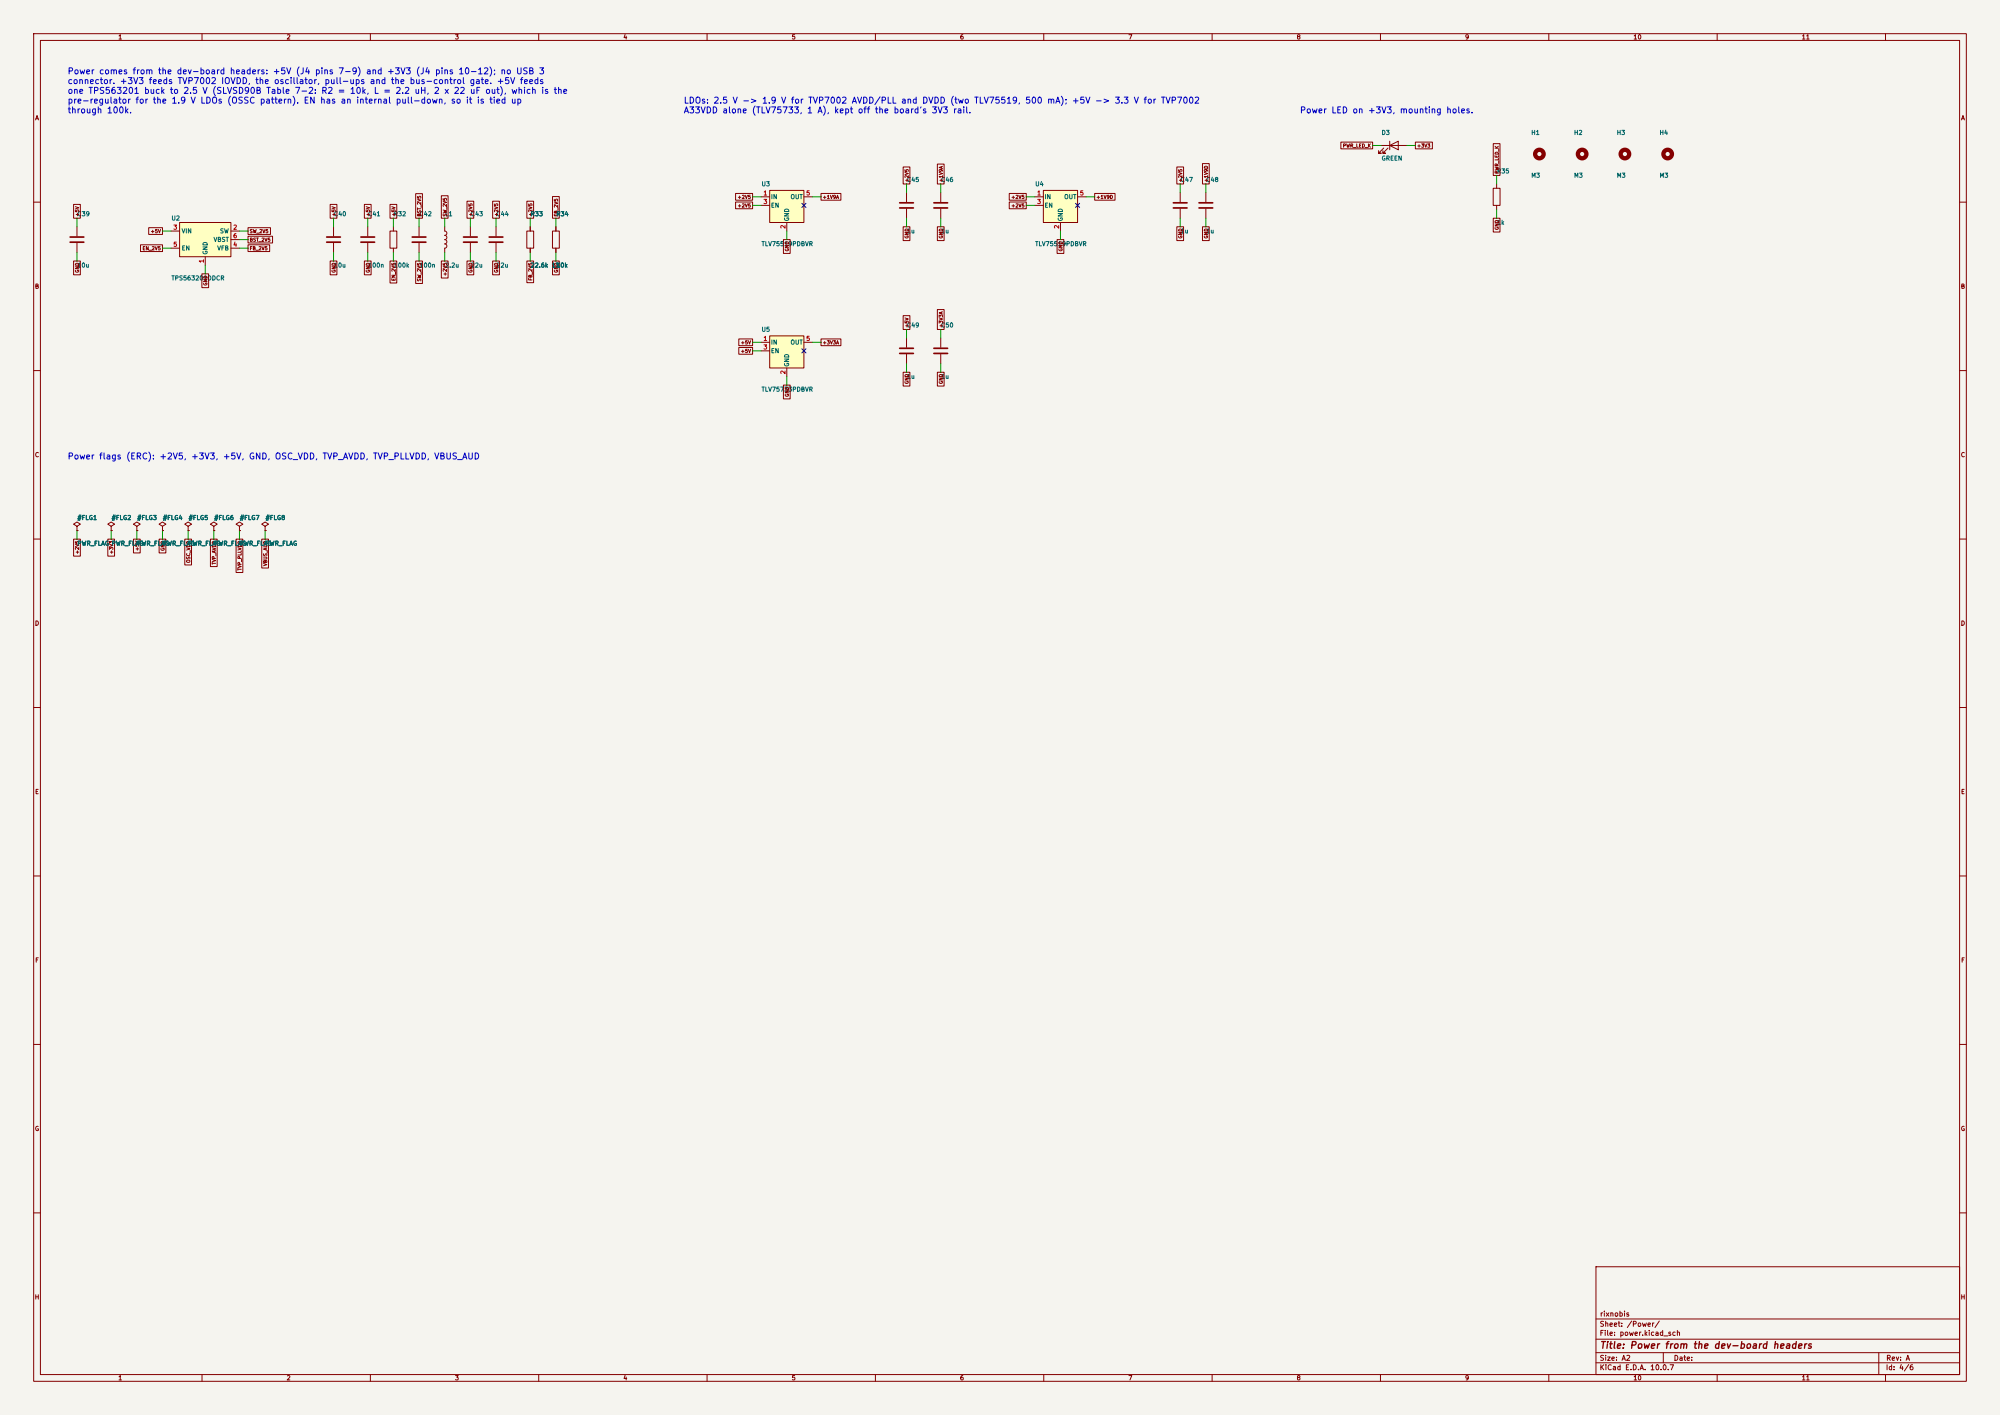
[picture p21: page 4]

Power comes from the dev-board headers: +5V (J4 pins 7-9) and +3V3 (J4 pins 10-12); no USB 3
connector. +3V3 feeds TVP7002 IOVDD, the oscillator, pull-ups and the bus-control gate. +5V feeds one TPS563201 buck to 2.5 V (SLVSD90B Table 7-2: R2 = 10k, L = 2.2 uH, 2 x 22 uF out), which is the

pre-regulator for the 1.9 V LDOs (OSSC pattern). EN has an internal pull-down, so it is tied up
through 100k.

LDOs: 2.5 V -> 1.9 V for TVP7002 AVDD/PLL and DVDD (two TLV75519, 500 mA); +5V -> 3.3 V for TVP7002
A33VDD alone (TLV75733, 1 A), kept off the board's 3V3 rail.

Power LED on +3V3, mounting holes.

Power flags (ERC): +2V5, +3V3, +5V, GND, OSC_VDD, TVP_AVDD, TVP_PLLVDD, VBUS_AUD

Sheet: /Power/
File: power.kicad_sch
Title: Power from the dev-board headers

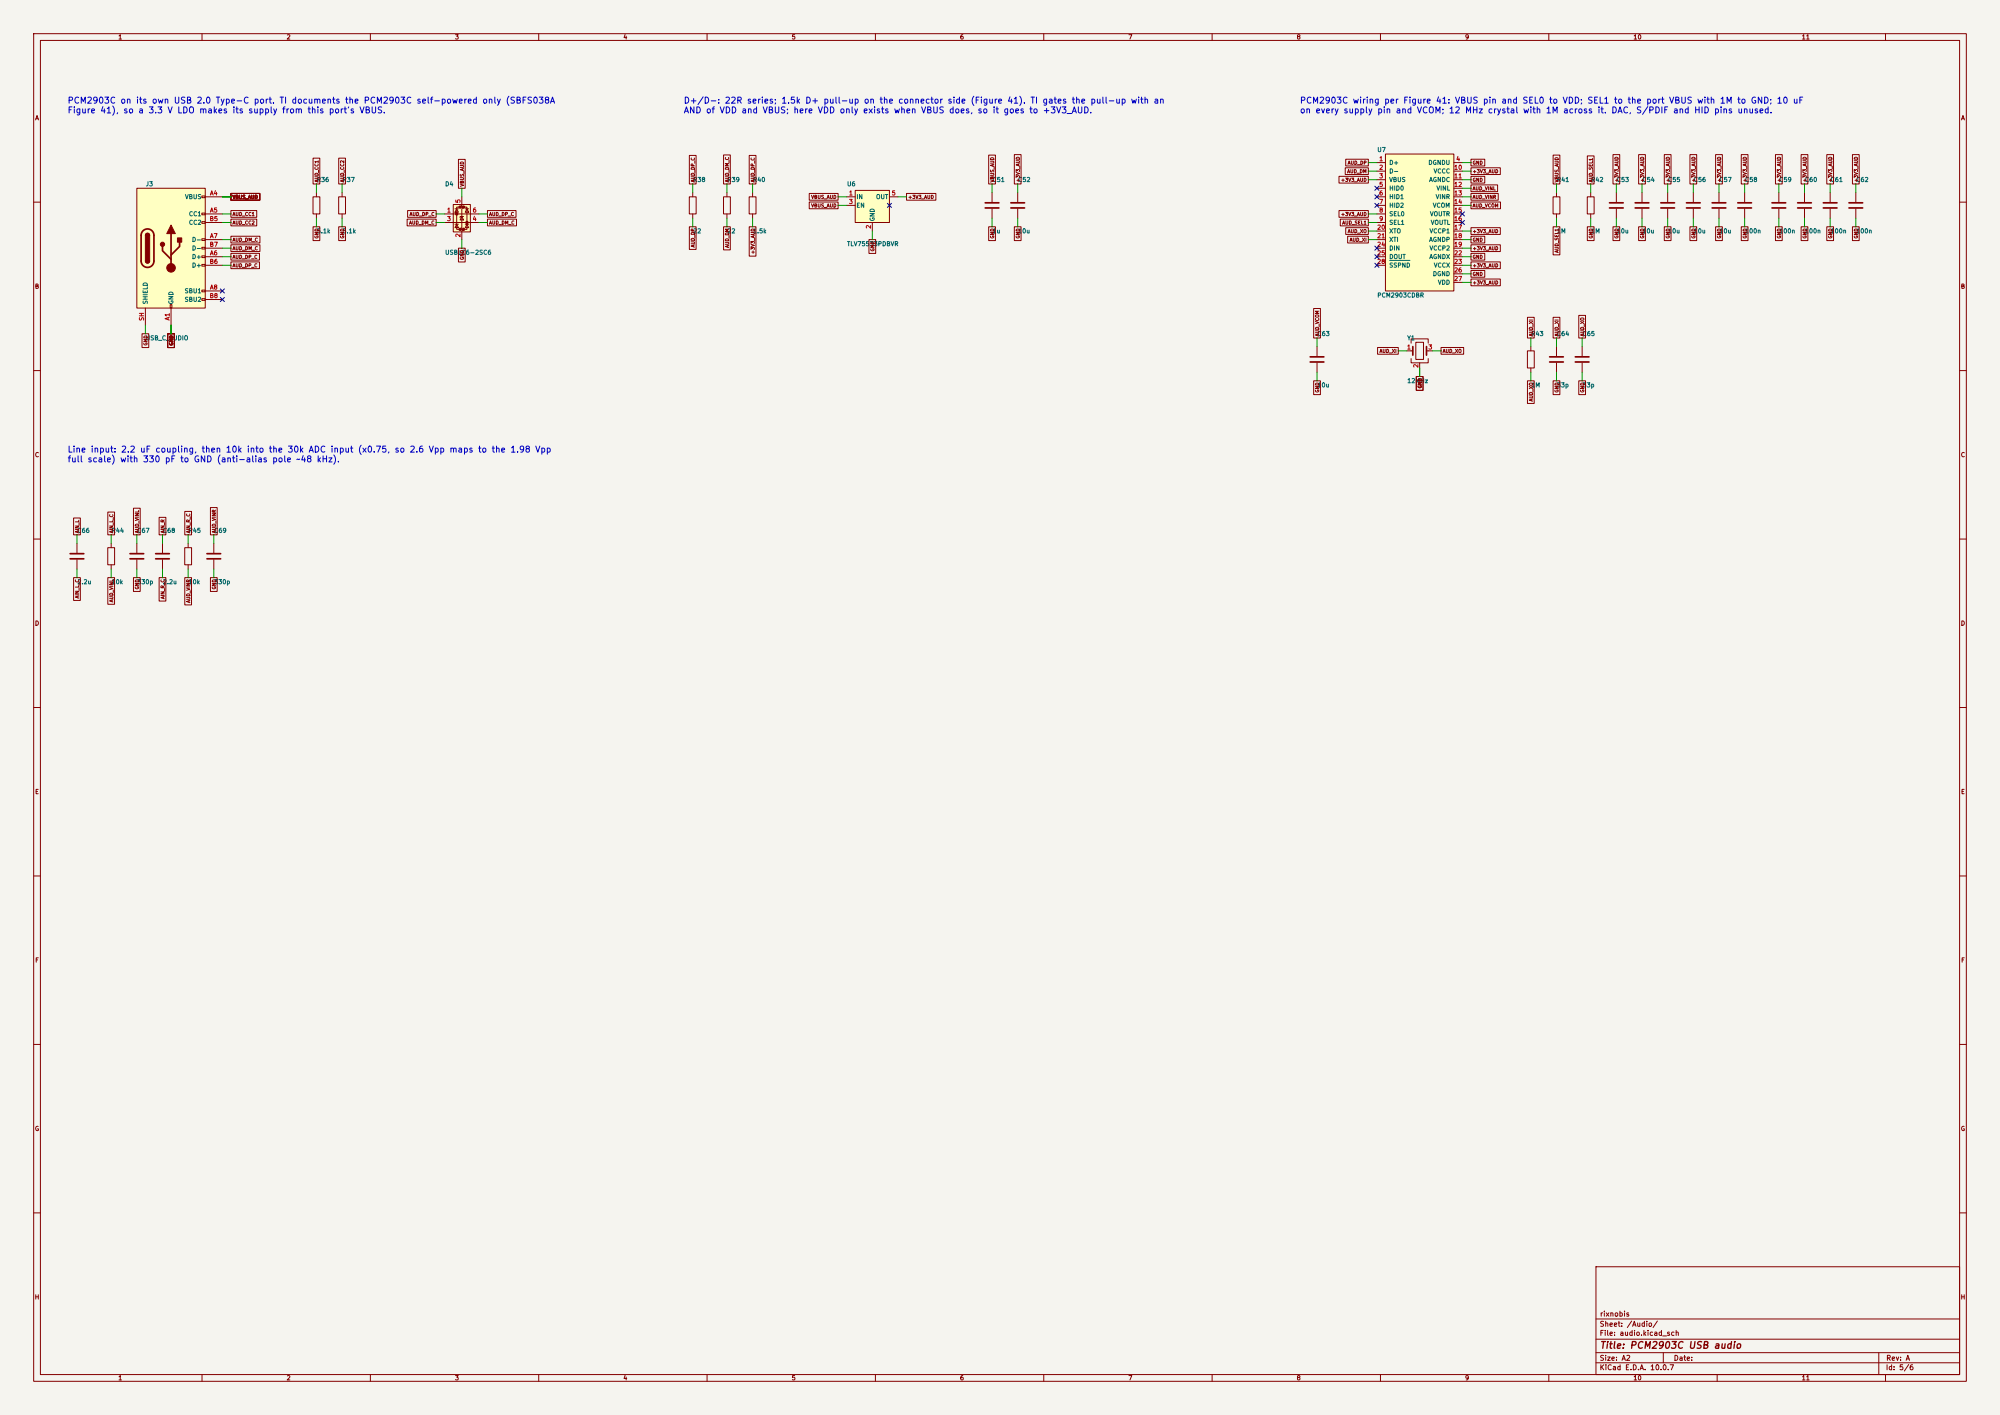
[picture p22: page 5]

PCM2903C on its own USB 2.0 Type-C port. TI documents the PCM2903C self-powered only (SBFS038A
Figure 41), so a 3.3 V LDO makes its supply from this port's VBUS.

D+/D-: 22R series; 1.5k D+ pull-up on the connector side (Figure 41). TI gates the pull-up with an
AND of VDD and VBUS; here VDD only exists when VBUS does, so it goes to +3V3_AUD.

PCM2903C wiring per Figure 41: VBUS pin and SEL0 to VDD; SEL1 to the port VBUS with 1M to GND; 10 uF on every supply pin and VCOM; 12 MHz crystal with 1M across it. DAC, S/PDIF and HID pins unused.
28U7PCM2903CDBR
VBUS

Line input: 2.2 uF coupling, then 10k into the 30k ADC input (x0.75, so 2.6 Vpp maps to the 1.98 Vpp
full scale) with 330 pF to GND (anti-alias pole ~48 kHz).

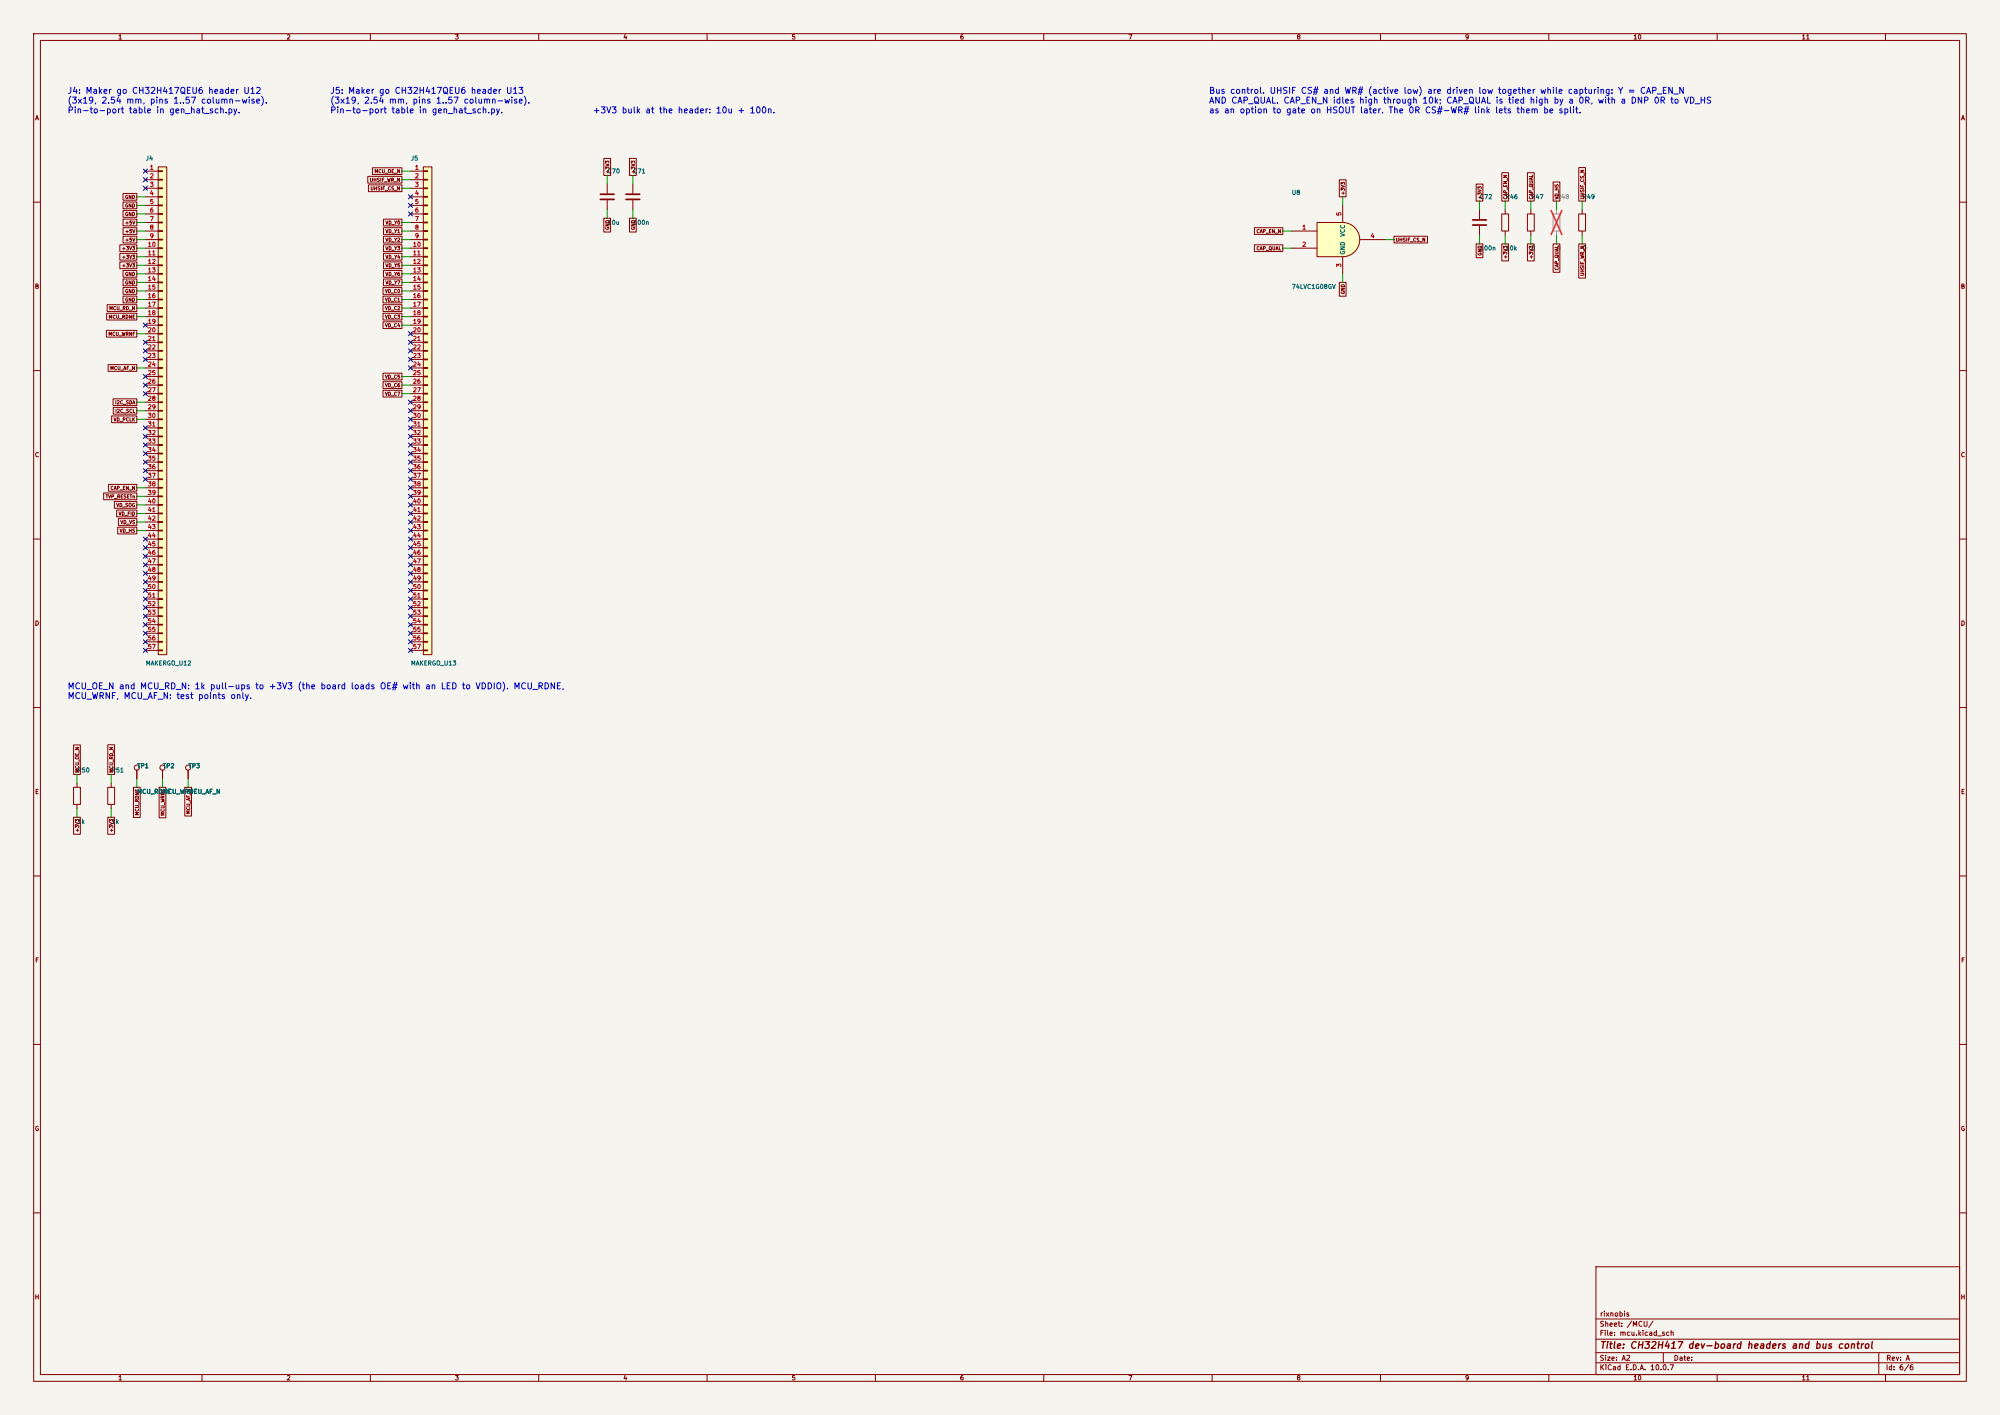
[picture p23: page 6]

Bus control. UHSIF CS# and WR# (active low) are driven low together while capturing: Y = CAP_EN_N
AND CAP_QUAL. CAP_EN_N idles high through 10k; CAP_QUAL is tied high by a 0R, with a DNP 0R to VD_HS
as an option to gate on HSOUT later. The 0R CS#-WR# link lets them be split.

MCU_OE_N and MCU_RD_N: 1k pull-ups to +3V3 (the board loads OE# with an LED to VDDIO). MCU_RDNE,
MCU_WRNF, MCU_AF_N: test points only.

Sheet: /MCU/
File: mcu.kicad_sch
Title: CH32H417 dev-board headers and bus control
