rixnobis/ps1-av-capture/hat/ps1-av-hat.kicad_pcb

## KiCad design hat/ps1-av-hat.kicad_pcb (2026-11-13)

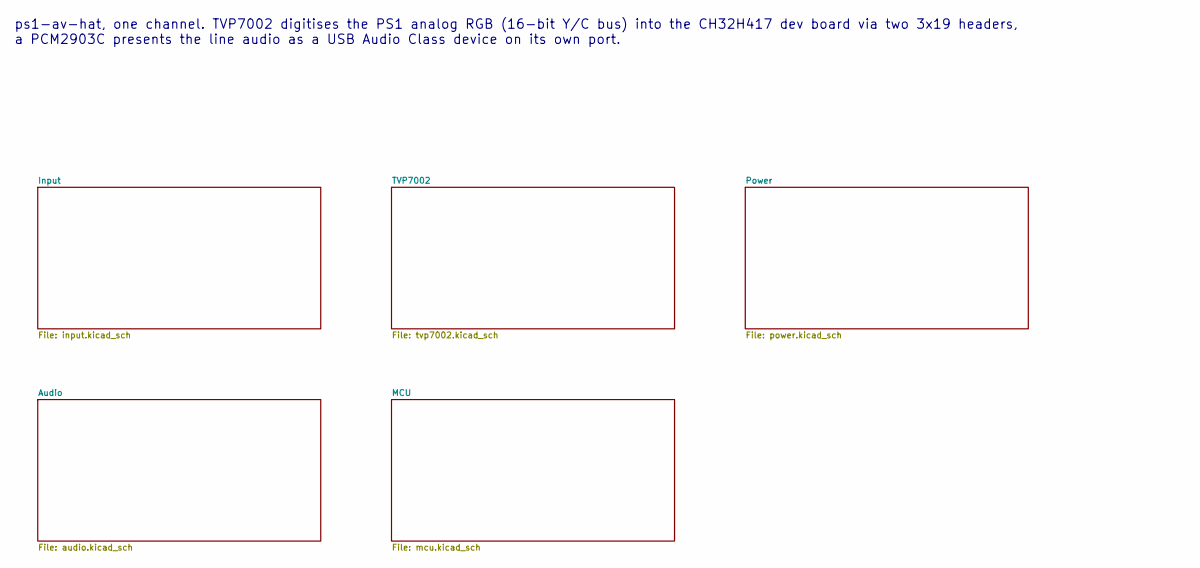
[picture p24: schematic ps1-av-hat.kicad_sch, ps1-av-hat: one-channel PS1 RGB + audio hat for CH32H417]

Notes on the sheet:
ps1-av-hat, one channel. TVP7002 digitises the PS1 analog RGB (16-bit Y/C bus) into the CH32H417 dev board via two 3x19 headers, a PCM2903C presents the line audio as a USB Audio Class device on its own port.

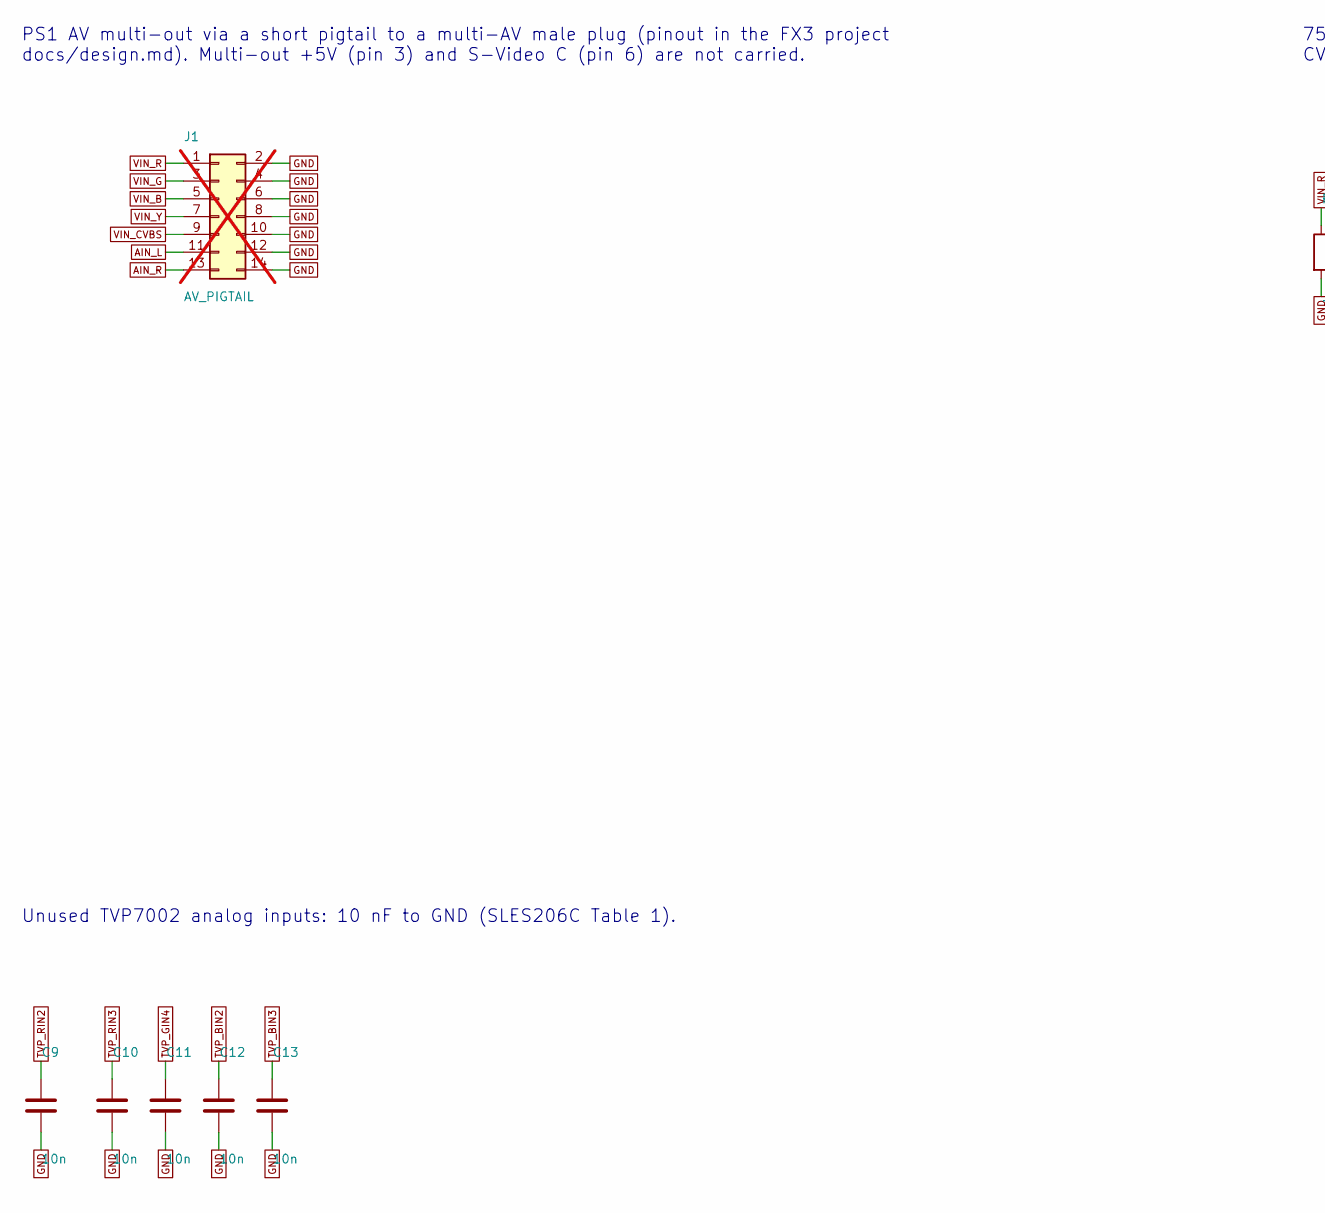
[picture p25: schematic input.kicad_sch, AV multi-out input, termination, ESD, part in row 1, column 1]

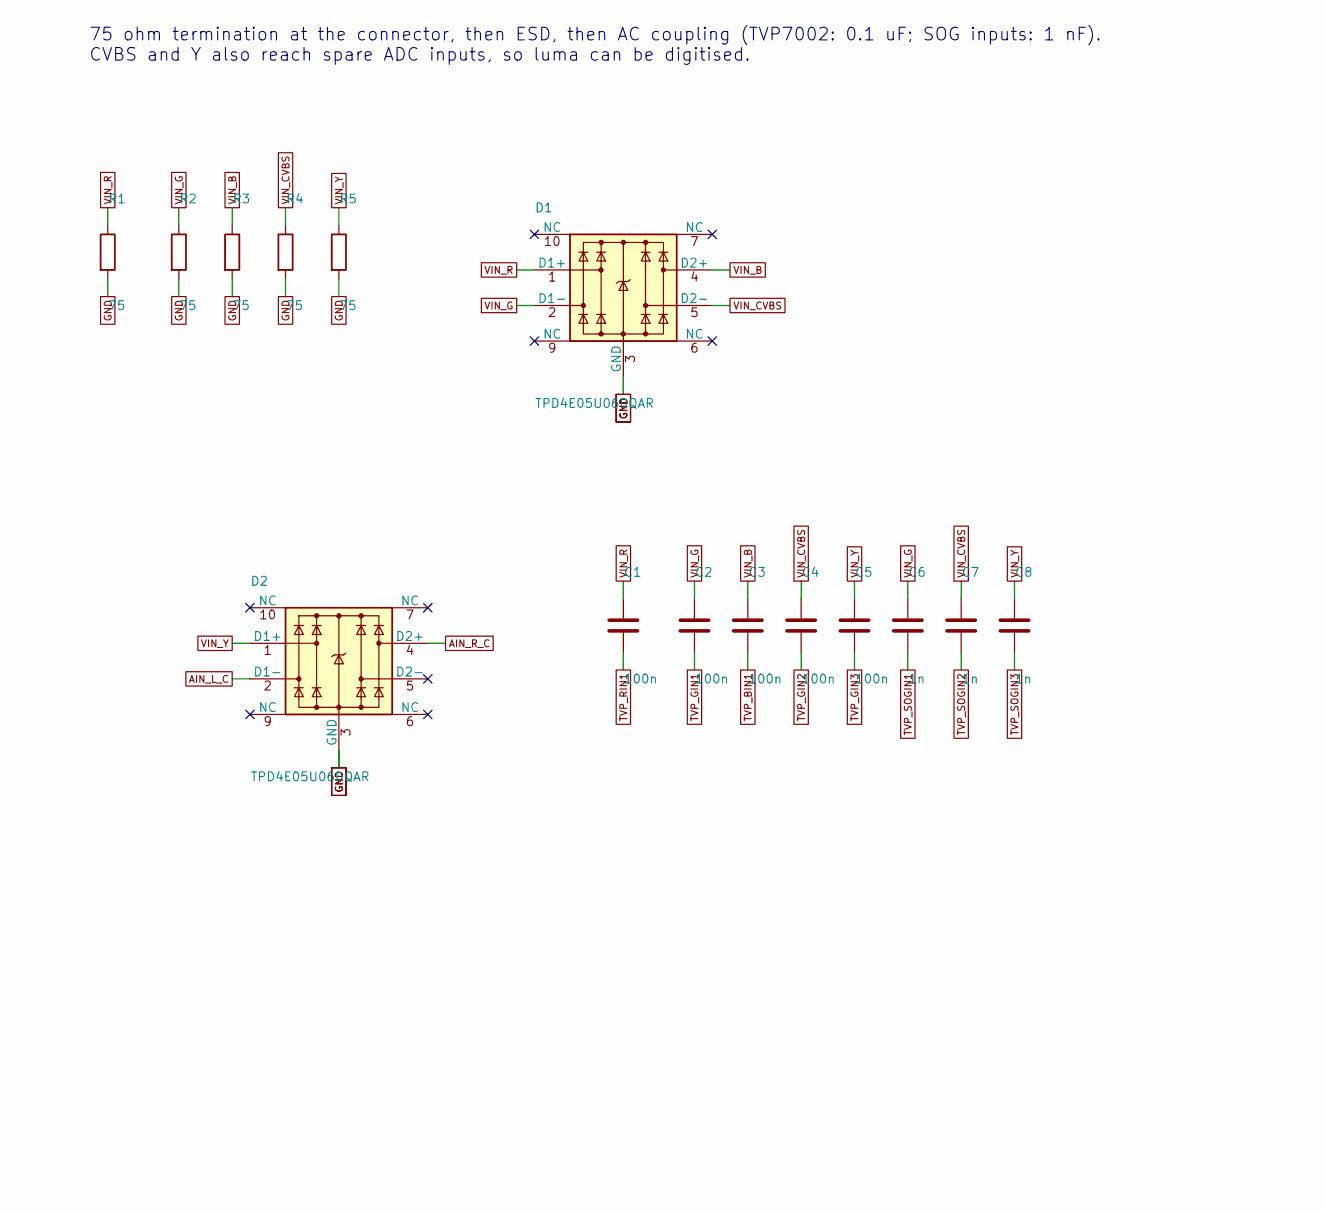
[picture p26: schematic input.kicad_sch, AV multi-out input, termination, ESD, part in row 1, column 2]

Parts:
C1, C2, C3, C4, C5: 100n; C_0402_1005Metric; LCSC C1525
C6, C7, C8: 1n; C_0402_1005Metric; LCSC C1523
C9, C10, C11, C12, C13: 10n; C_0402_1005Metric; LCSC C15195
D1, D2: TPD4E05U06DQAR; USON-10_2.5x1.0mm_P0.5mm; LCSC C138714
J1: AV_PIGTAIL; JST_PHD_B14B-PHDSS_2x07_P2.00mm_Vertical; LCSC C471471; not fitted
R1, R2, R3, R4, R5: 75; R_0402_1005Metric; LCSC C25133

Connections:
AIN_L: J1.11; also elsewhere on the board
AIN_L_C: D2.2 (D1-); also elsewhere on the board
AIN_R: J1.13; also elsewhere on the board
AIN_R_C: D2.4 (D2+); also elsewhere on the board
GND: C9.2, C10.2, C11.2, C12.2, C13.2, D1.3 (GND), D1.8 (GND), D2.3 (GND), D2.8 (GND), J1.2, J1.4, J1.6, J1.8, J1.10, J1.12, J1.14, R1.2, R2.2, R3.2, R4.2, R5.2; also elsewhere on the board
TVP_BIN1: C3.2; also elsewhere on the board
TVP_BIN2: C12.1; also elsewhere on the board
TVP_BIN3: C13.1; also elsewhere on the board
TVP_GIN1: C2.2; also elsewhere on the board
TVP_GIN2: C4.2; also elsewhere on the board
TVP_GIN3: C5.2; also elsewhere on the board
TVP_GIN4: C11.1; also elsewhere on the board
TVP_RIN1: C1.2; also elsewhere on the board
TVP_RIN2: C9.1; also elsewhere on the board
TVP_RIN3: C10.1; also elsewhere on the board
TVP_SOGIN1: C6.2; also elsewhere on the board
TVP_SOGIN2: C7.2; also elsewhere on the board
TVP_SOGIN3: C8.2; also elsewhere on the board
VIN_B: C3.1, D1.4 (D2+), J1.5, R3.1
VIN_CVBS: C4.1, C7.1, D1.5 (D2-), J1.9, R4.1
VIN_G: C2.1, C6.1, D1.2 (D1-), J1.3, R2.1
VIN_R: C1.1, D1.1 (D1+), J1.1, R1.1
VIN_Y: C5.1, C8.1, D2.1 (D1+), J1.7, R5.1

Notes on the sheet:
PS1 AV multi-out via a short pigtail to a multi-AV male plug (pinout in the FX3 project docs/design.md). Multi-out +5V (pin 3) and S-Video C (pin 6) are not carried.
75 ohm termination at the connector, then ESD, then AC coupling (TVP7002: 0.1 uF; SOG inputs: 1 nF). CVBS and Y also reach spare ADC inputs, so luma can be digitised.
Unused TVP7002 analog inputs: 10 nF to GND (SLES206C Table 1).

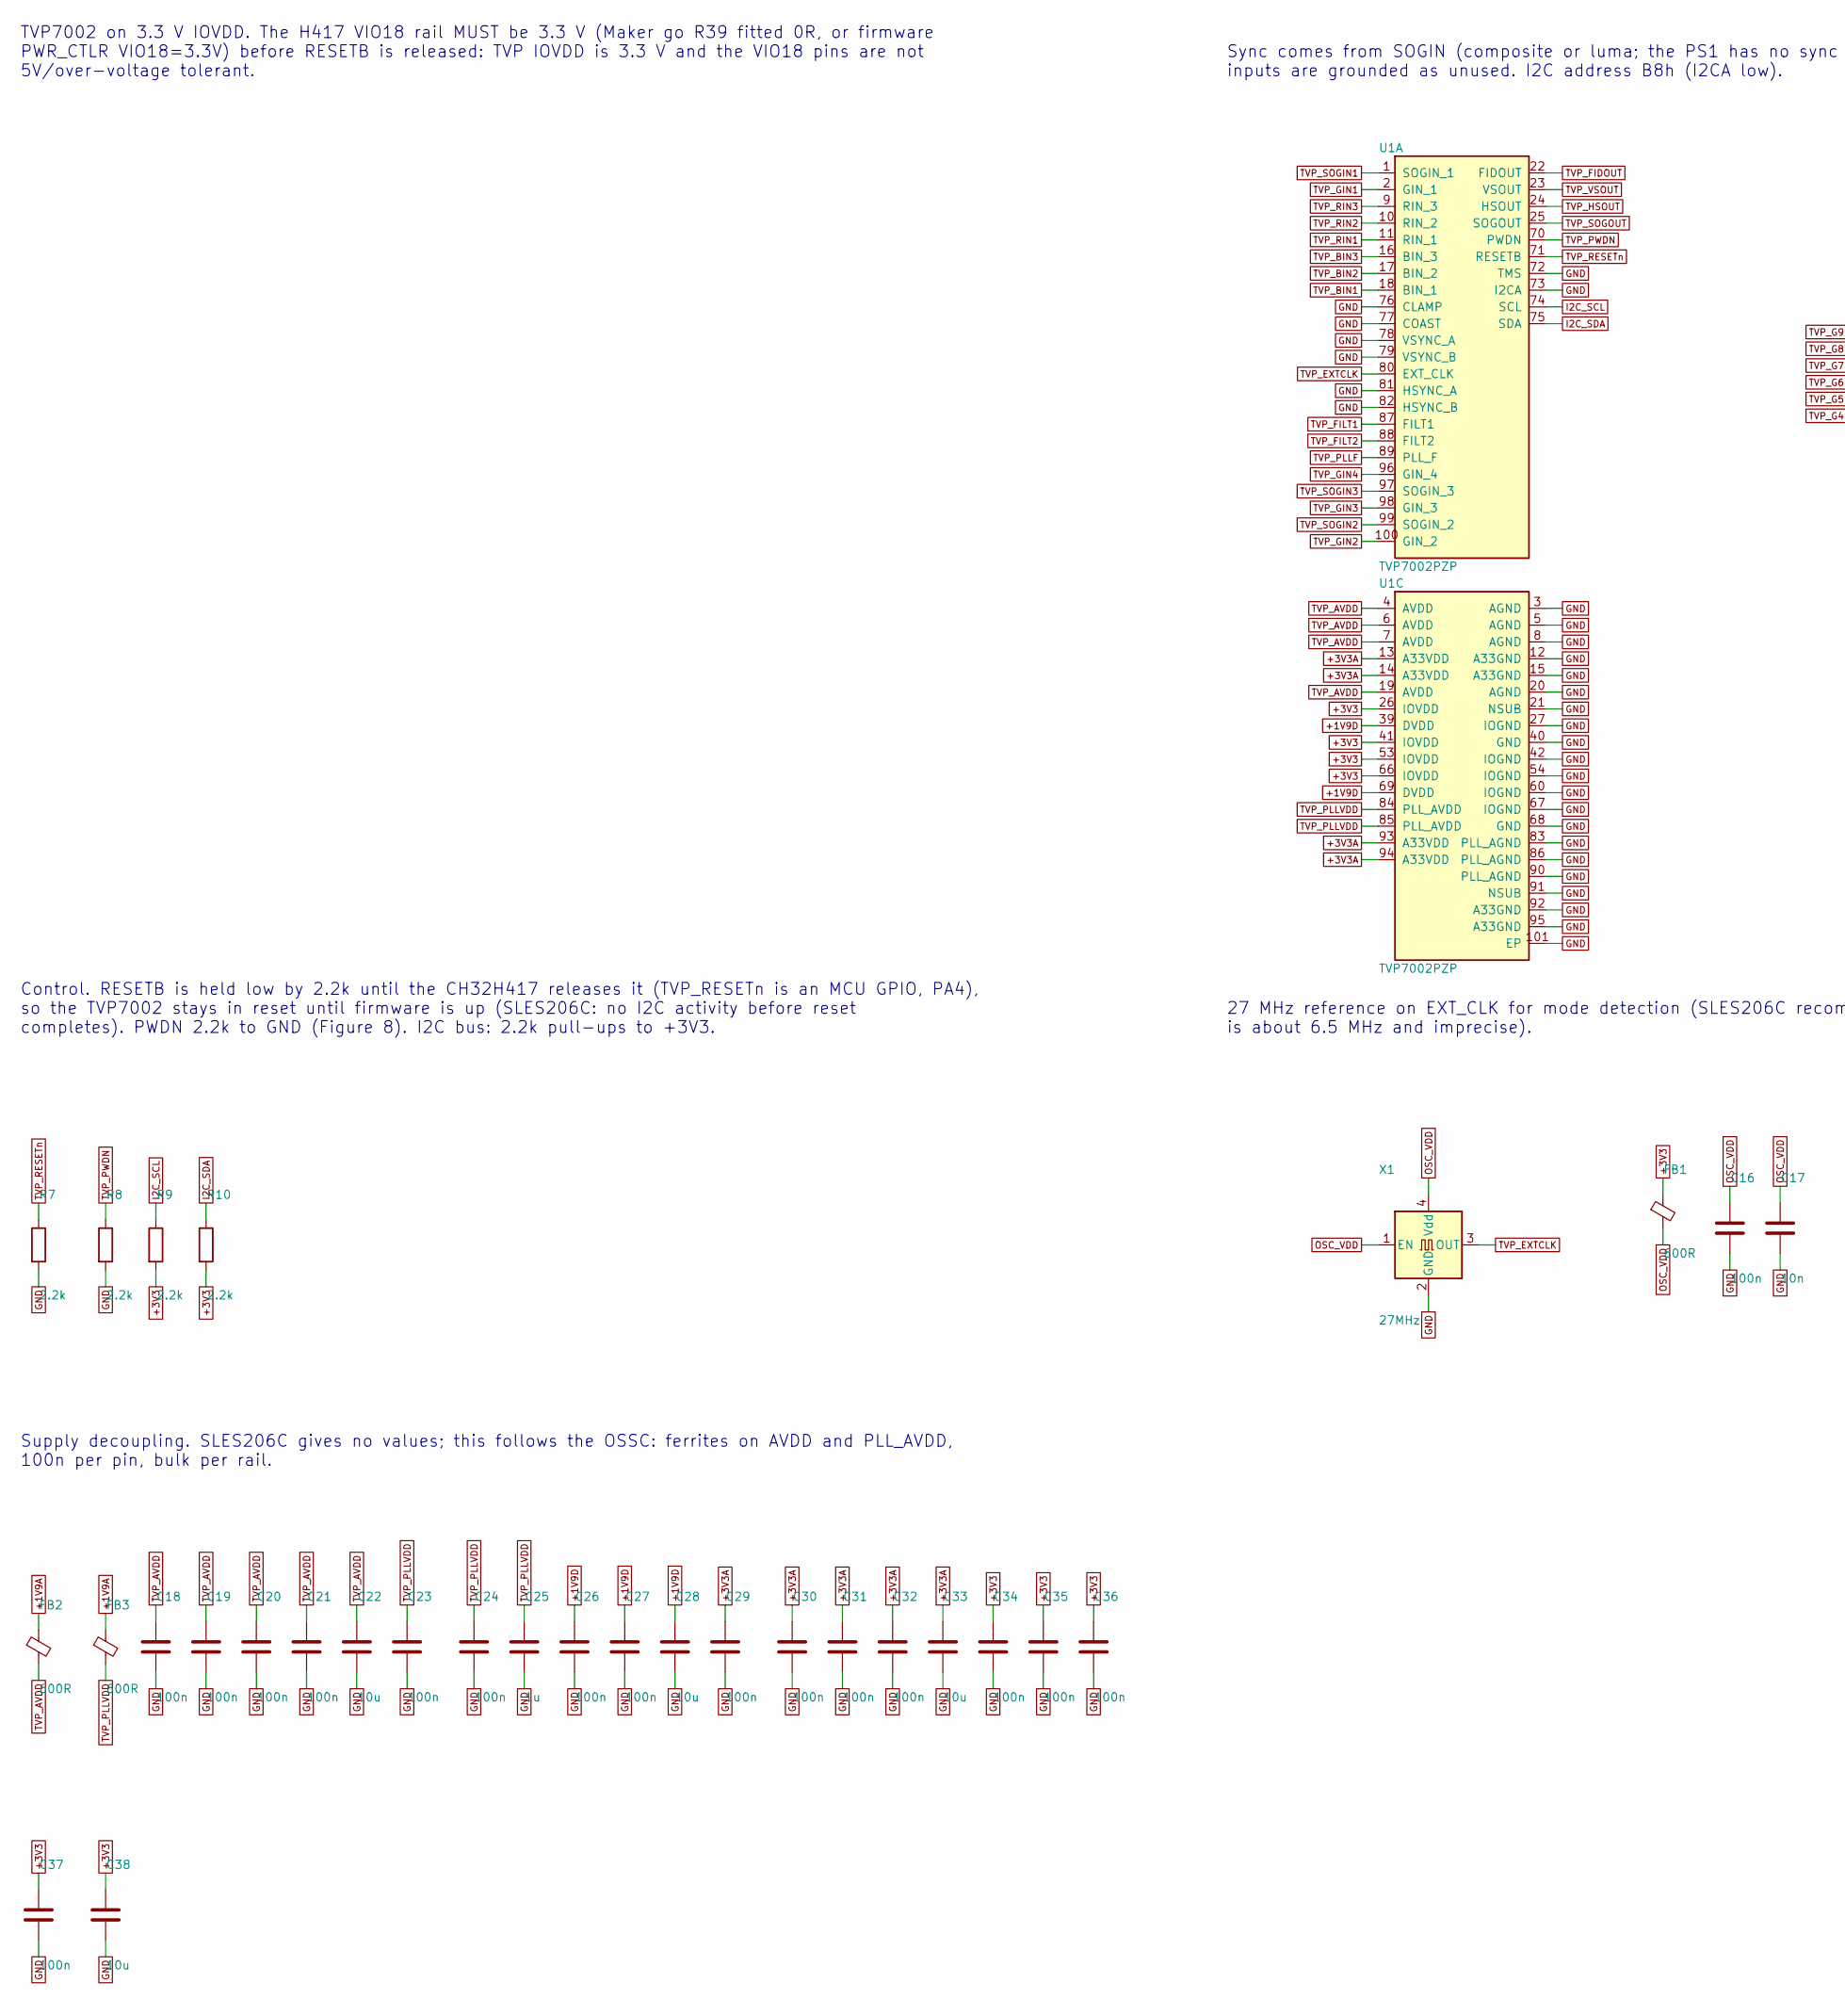
[picture p27: schematic tvp7002.kicad_sch, TVP7002 RGB digitiser, part in row 1, column 1]

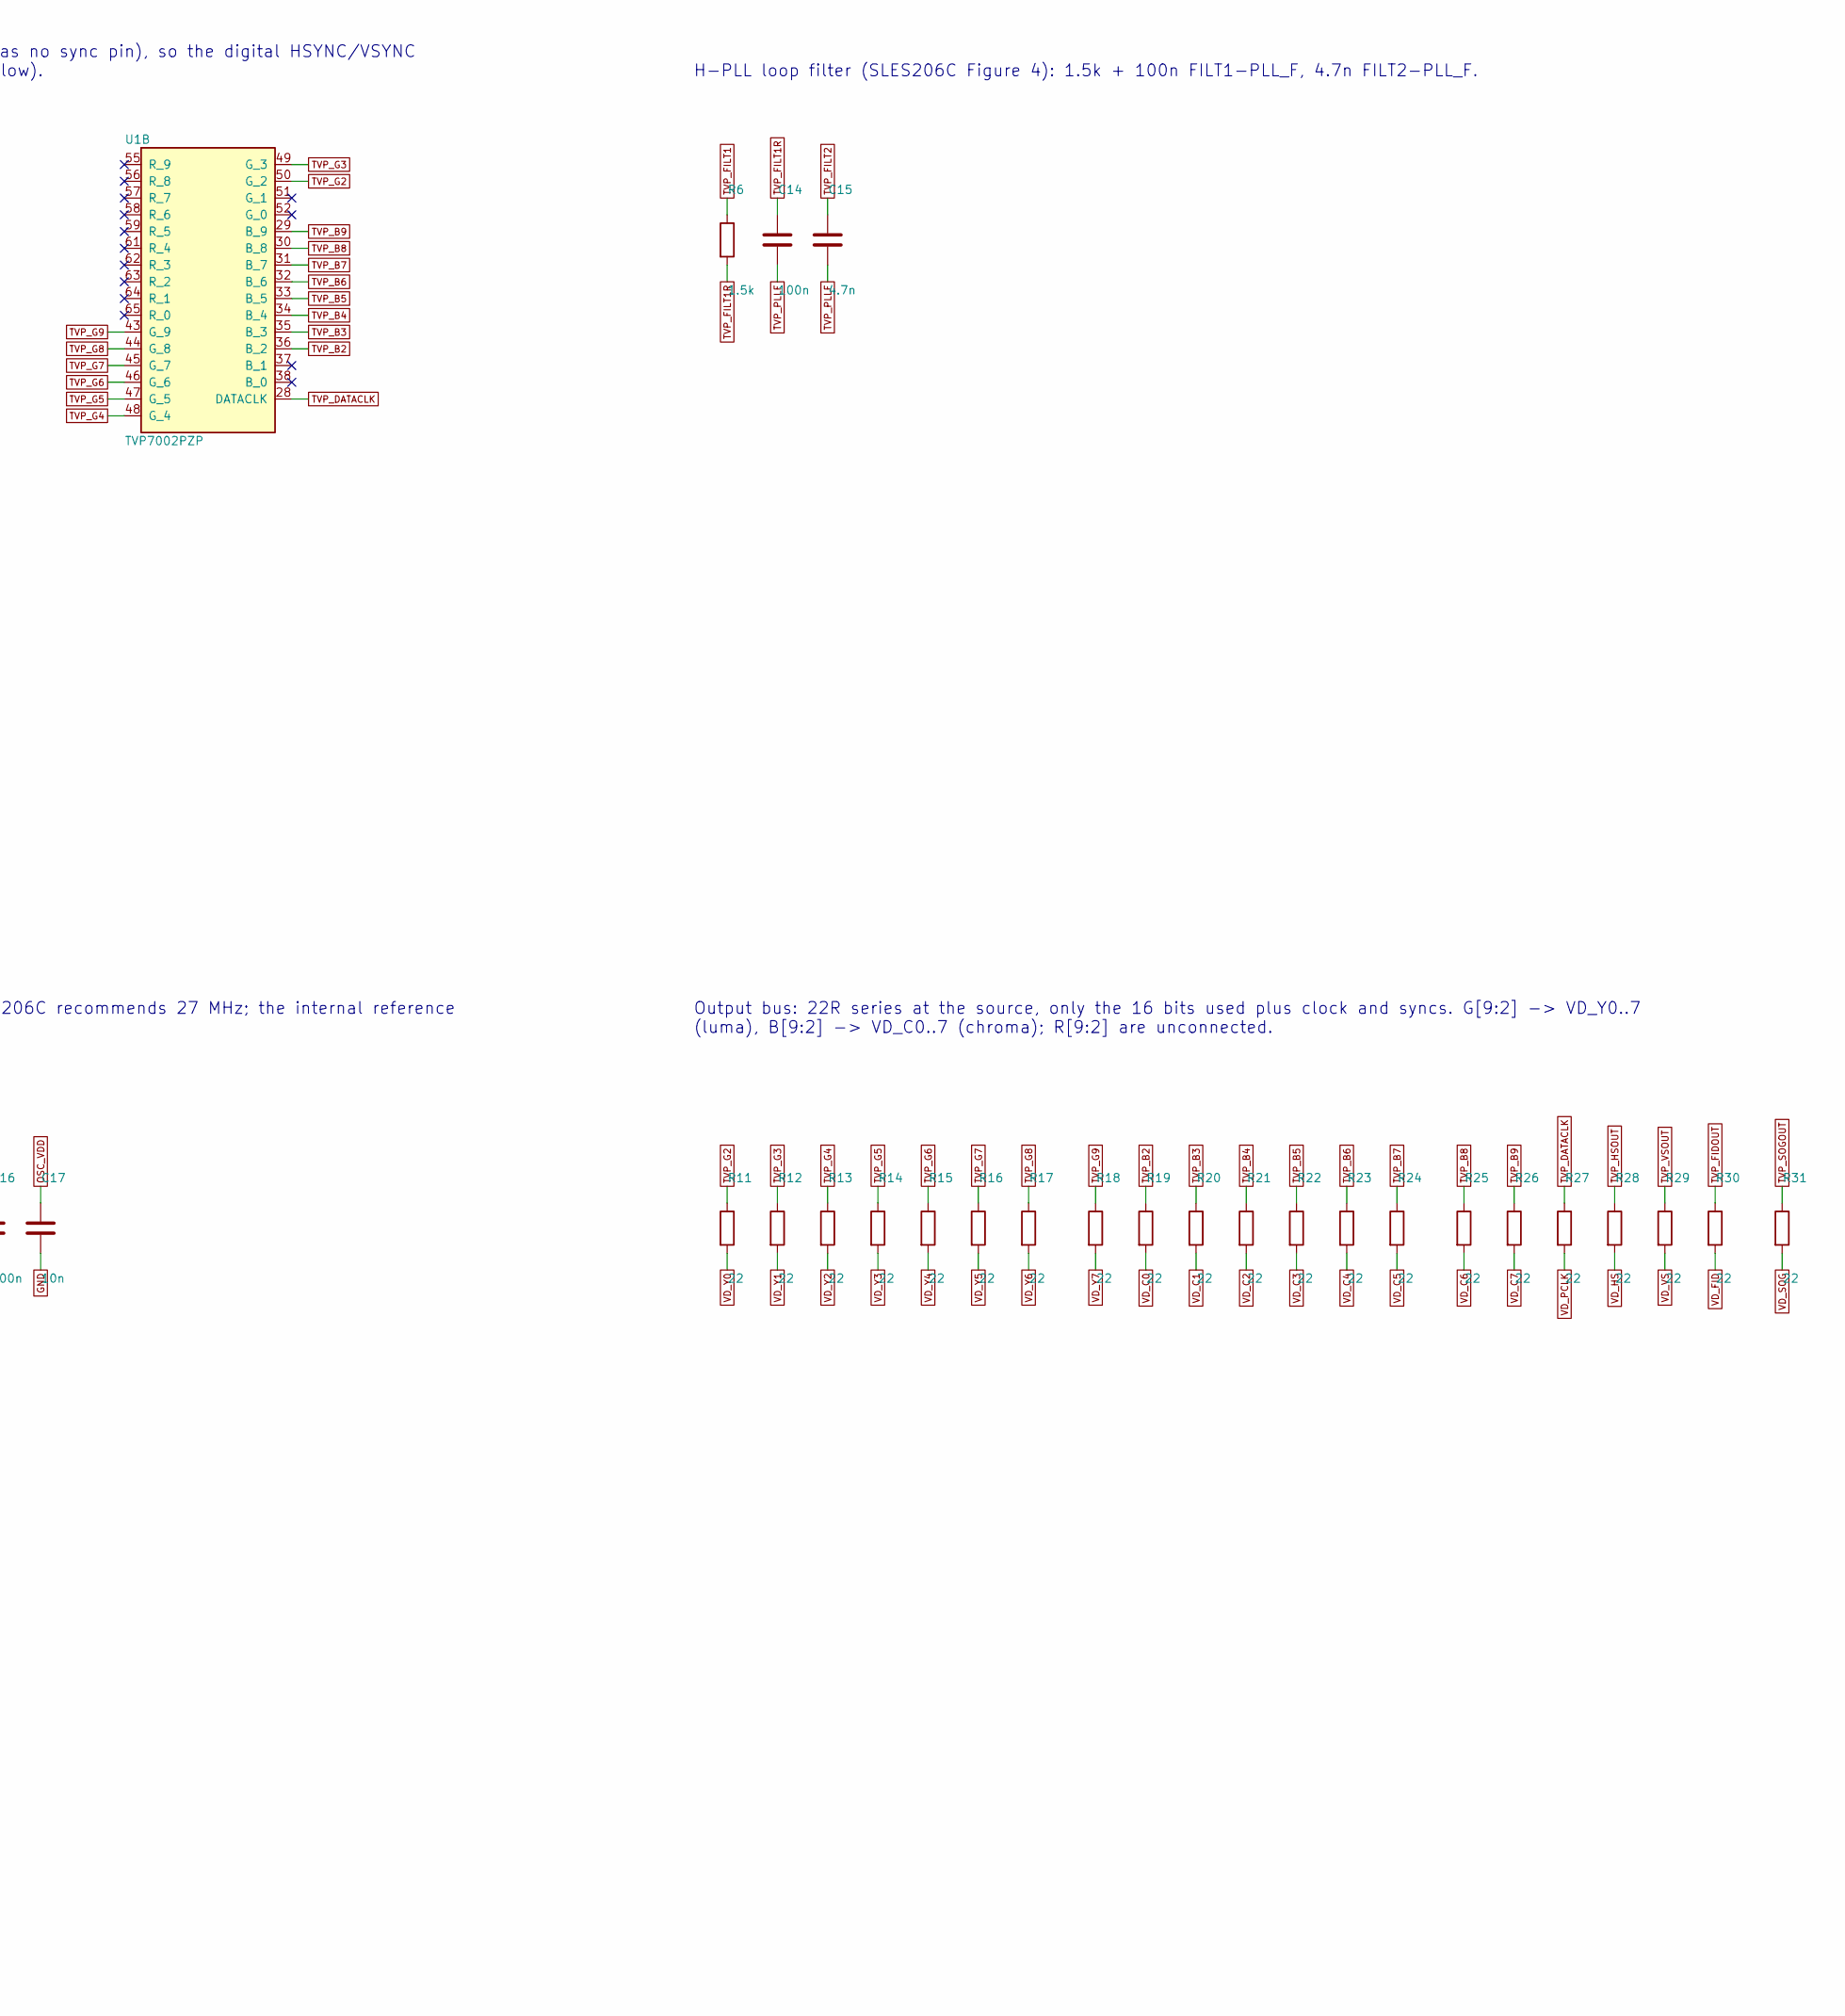
[picture p28: schematic tvp7002.kicad_sch, TVP7002 RGB digitiser, part in row 1, column 2]

Parts:
C14, C16, C18, C19, C20, C21, C23, C24, C26, C27, C29, C30, C31, C32, C34, C35, C36, C37: 100n; C_0402_1005Metric; LCSC C1525
C15: 4.7n; C_0402_1005Metric; LCSC C1538
C17: 10n; C_0402_1005Metric; LCSC C15195
C22, C28, C33, C38: 10u; C_0603_1608Metric; LCSC C19702
C25: 1u; C_0402_1005Metric; LCSC C52923
FB1, FB2, FB3: 600R; L_0603_1608Metric; LCSC C108301
R6: 1.5k; R_0402_1005Metric; LCSC C25867
R7, R8, R9, R10: 2.2k; R_0402_1005Metric; LCSC C25879
R11, R12, R13, R14, R15, R16, R17, R18, R19, R20, R21, R22, R23, R24, R25, R26, R27, R28, R29, R30, R31: 22; R_0402_1005Metric; LCSC C25092
U1: TVP7002PZP; HTQFP-100_L14.0-W14.0-P0.50-LS16.0-BL-EP6.2; LCSC C3824085
X1: 27MHz; Oscillator_SMD_Abracon_ASE-4Pin_3.2x2.5mm; LCSC C725995

Connections:
+1V9A: FB2.1, FB3.1; also elsewhere on the board
+1V9D: C26.1, C27.1, C28.1, U1.39 (DVDD), U1.69 (DVDD); also elsewhere on the board
+3V3: C34.1, C35.1, C36.1, C37.1, C38.1, FB1.1, R9.2, R10.2, U1.26 (IOVDD), U1.41 (IOVDD), U1.53 (IOVDD), U1.66 (IOVDD); also elsewhere on the board
+3V3A: C29.1, C30.1, C31.1, C32.1, C33.1, U1.13 (A33VDD), U1.14 (A33VDD), U1.93 (A33VDD), U1.94 (A33VDD); also elsewhere on the board
GND: C16.2, C17.2, C18.2, C19.2, C20.2, C21.2, C22.2, C23.2, C24.2, C25.2, C26.2, C27.2, C28.2, C29.2, C30.2, C31.2, C32.2, C33.2, C34.2, C35.2, C36.2, C37.2, C38.2, R7.2, R8.2, U1.3 (AGND), U1.5 (AGND), U1.8 (AGND), U1.12 (A33GND), U1.15 (A33GND), U1.20 (AGND), U1.21 (NSUB), U1.27 (IOGND), U1.40 (GND), U1.42 (IOGND), U1.54 (IOGND), U1.60 (IOGND), U1.67 (IOGND), U1.68 (GND), U1.72 (TMS), U1.73 (I2CA), U1.76 (CLAMP), U1.77 (COAST), U1.78 (VSYNC_A), U1.79 (VSYNC_B), U1.81 (HSYNC_A), U1.82 (HSYNC_B), U1.83 (PLL_AGND), U1.86 (PLL_AGND), U1.90 (PLL_AGND), U1.91 (NSUB), U1.92 (A33GND), U1.95 (A33GND), U1.101 (EP), X1.2 (GND); also elsewhere on the board
I2C_SCL: R9.1, U1.74 (SCL); also elsewhere on the board
I2C_SDA: R10.1, U1.75 (SDA); also elsewhere on the board
OSC_VDD: C16.1, C17.1, FB1.2, X1.1 (EN), X1.4 (Vdd)
TVP_AVDD: C18.1, C19.1, C20.1, C21.1, C22.1, FB2.2, U1.4 (AVDD), U1.6 (AVDD), U1.7 (AVDD), U1.19 (AVDD)
TVP_B2: R19.1, U1.36 (B_2)
TVP_B3: R20.1, U1.35 (B_3)
TVP_B4: R21.1, U1.34 (B_4)
TVP_B5: R22.1, U1.33 (B_5)
TVP_B6: R23.1, U1.32 (B_6)
TVP_B7: R24.1, U1.31 (B_7)
TVP_B8: R25.1, U1.30 (B_8)
TVP_B9: R26.1, U1.29 (B_9)
TVP_BIN1: U1.18 (BIN_1); also elsewhere on the board
TVP_BIN2: U1.17 (BIN_2); also elsewhere on the board
TVP_BIN3: U1.16 (BIN_3); also elsewhere on the board
TVP_DATACLK: R27.1, U1.28 (DATACLK)
TVP_EXTCLK: U1.80 (EXT_CLK), X1.3 (OUT)
TVP_FIDOUT: R30.1, U1.22 (FIDOUT)
TVP_FILT1: R6.1, U1.87 (FILT1)
TVP_FILT1R: C14.1, R6.2
TVP_FILT2: C15.1, U1.88 (FILT2)
TVP_G2: R11.1, U1.50 (G_2)
TVP_G3: R12.1, U1.49 (G_3)
TVP_G4: R13.1, U1.48 (G_4)
TVP_G5: R14.1, U1.47 (G_5)
TVP_G6: R15.1, U1.46 (G_6)
TVP_G7: R16.1, U1.45 (G_7)
TVP_G8: R17.1, U1.44 (G_8)
TVP_G9: R18.1, U1.43 (G_9)
TVP_GIN1: U1.2 (GIN_1); also elsewhere on the board
TVP_GIN2: U1.100 (GIN_2); also elsewhere on the board
TVP_GIN3: U1.98 (GIN_3); also elsewhere on the board
TVP_GIN4: U1.96 (GIN_4); also elsewhere on the board
TVP_HSOUT: R28.1, U1.24 (HSOUT)
TVP_PLLF: C14.2, C15.2, U1.89 (PLL_F)
TVP_PLLVDD: C23.1, C24.1, C25.1, FB3.2, U1.84 (PLL_AVDD), U1.85 (PLL_AVDD)
TVP_PWDN: R8.1, U1.70 (PWDN)
TVP_RESETn: R7.1, U1.71 (RESETB); also elsewhere on the board
TVP_RIN1: U1.11 (RIN_1); also elsewhere on the board
TVP_RIN2: U1.10 (RIN_2); also elsewhere on the board
TVP_RIN3: U1.9 (RIN_3); also elsewhere on the board
TVP_SOGIN1: U1.1 (SOGIN_1); also elsewhere on the board
TVP_SOGIN2: U1.99 (SOGIN_2); also elsewhere on the board
TVP_SOGIN3: U1.97 (SOGIN_3); also elsewhere on the board
TVP_SOGOUT: R31.1, U1.25 (SOGOUT)
TVP_VSOUT: R29.1, U1.23 (VSOUT)
VD_C0: R19.2; also elsewhere on the board
VD_C1: R20.2; also elsewhere on the board
VD_C2: R21.2; also elsewhere on the board
VD_C3: R22.2; also elsewhere on the board
VD_C4: R23.2; also elsewhere on the board
VD_C5: R24.2; also elsewhere on the board
VD_C6: R25.2; also elsewhere on the board
VD_C7: R26.2; also elsewhere on the board
VD_FID: R30.2; also elsewhere on the board
VD_HS: R28.2; also elsewhere on the board
VD_PCLK: R27.2; also elsewhere on the board
VD_SOG: R31.2; also elsewhere on the board
VD_VS: R29.2; also elsewhere on the board
VD_Y0: R11.2; also elsewhere on the board
VD_Y1: R12.2; also elsewhere on the board
VD_Y2: R13.2; also elsewhere on the board
VD_Y3: R14.2; also elsewhere on the board
VD_Y4: R15.2; also elsewhere on the board
VD_Y5: R16.2; also elsewhere on the board
VD_Y6: R17.2; also elsewhere on the board
VD_Y7: R18.2; also elsewhere on the board

Notes on the sheet:
TVP7002 on 3.3 V IOVDD. The H417 VIO18 rail MUST be 3.3 V (Maker go R39 fitted 0R, or firmware PWR_CTLR VIO18=3.3V) before RESETB is released: TVP IOVDD is 3.3 V and the VIO18 pins are not 5V/over-voltage tolerant.
Sync comes from SOGIN (composite or luma; the PS1 has no sync pin), so the digital HSYNC/VSYNC inputs are grounded as unused. I2C address B8h (I2CA low).
H-PLL loop filter (SLES206C Figure 4): 1.5k + 100n FILT1-PLL_F, 4.7n FILT2-PLL_F.
Control. RESETB is held low by 2.2k until the CH32H417 releases it (TVP_RESETn is an MCU GPIO, PA4), so the TVP7002 stays in reset until firmware is up (SLES206C: no I2C activity before reset completes). PWDN 2.2k to GND (Figure 8). I2C bus: 2.2k pull-ups to +3V3.
27 MHz reference on EXT_CLK for mode detection (SLES206C recommends 27 MHz; the internal reference is about 6.5 MHz and imprecise).
Output bus: 22R series at the source, only the 16 bits used plus clock and syncs. G[9:2] -> VD_Y0..7 (luma), B[9:2] -> VD_C0..7 (chroma); R[9:2] are unconnected.
Supply decoupling. SLES206C gives no values; this follows the OSSC: ferrites on AVDD and PLL_AVDD, 100n per pin, bulk per rail.

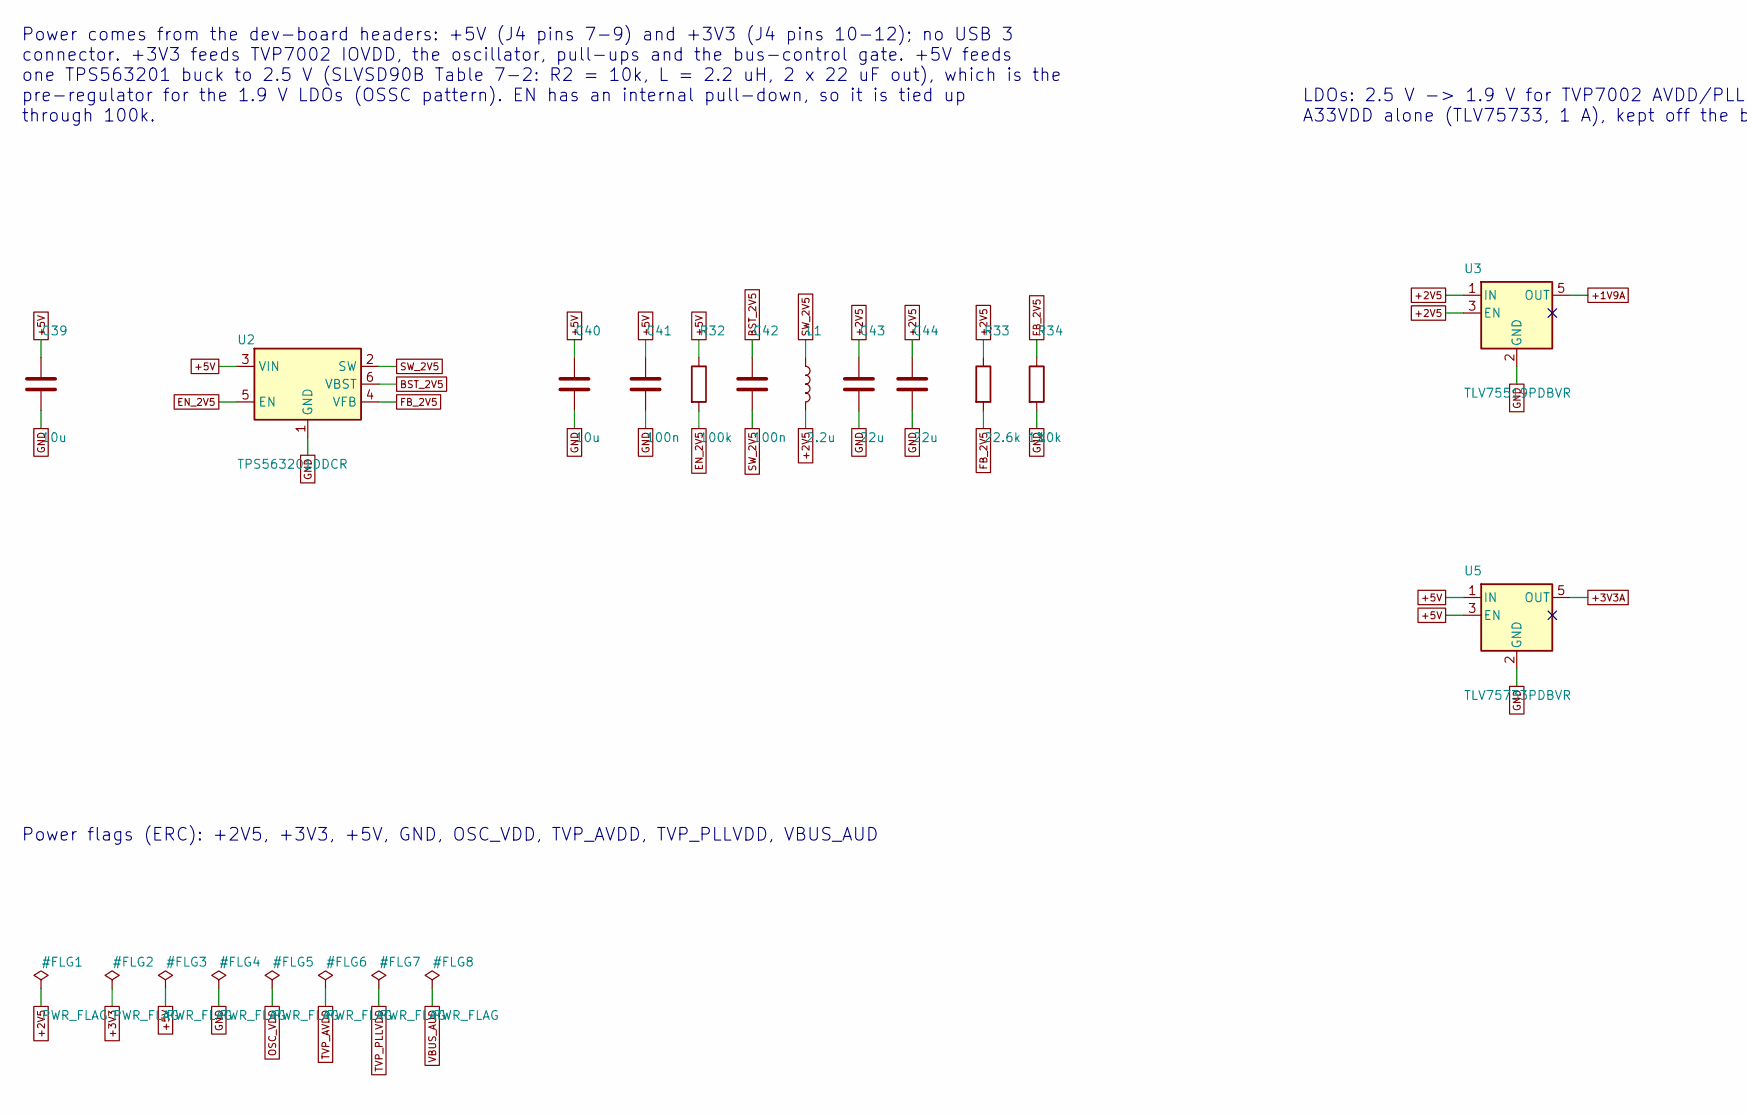
[picture p29: schematic power.kicad_sch, Power from the dev-board headers, part in row 1, column 1]

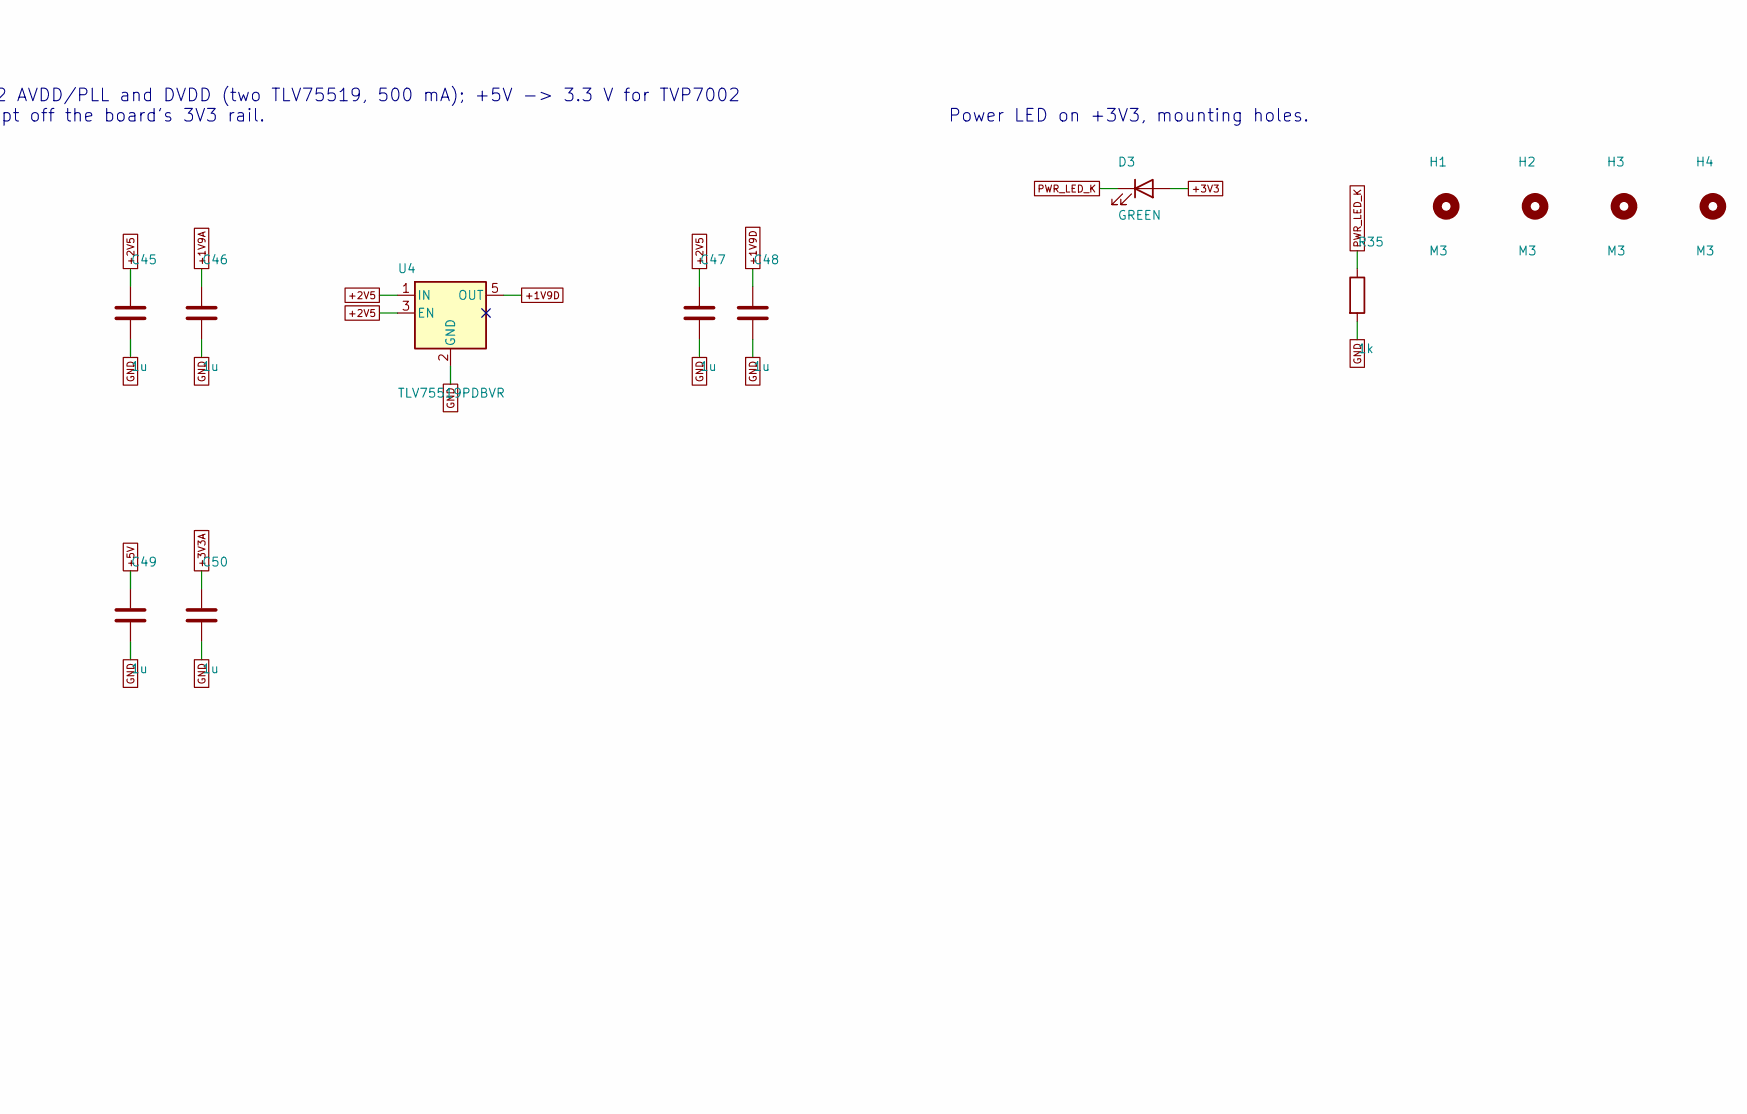
[picture p30: schematic power.kicad_sch, Power from the dev-board headers, part in row 1, column 2]

Parts:
C39, C40: 10u; C_0603_1608Metric; LCSC C19702
C41, C42: 100n; C_0402_1005Metric; LCSC C1525
C43, C44: 22u; C_0805_2012Metric; LCSC C45783
C45, C46, C47, C48, C49, C50: 1u; C_0402_1005Metric; LCSC C52923
D3: GREEN; LED_0603_1608Metric; LCSC C2986059
H1, H2, H3, H4: M3; MountingHole_3.2mm_M3
L1: 2.2u; L_Sunlord_SWPA4030S; LCSC C36409
R32: 100k; R_0402_1005Metric; LCSC C25741
R33: 22.6k 1%; R_0402_1005Metric; LCSC C26960
R34: 10k; R_0402_1005Metric; LCSC C25744
R35: 1k; R_0402_1005Metric; LCSC C11702
U2: TPS563201DDCR; SOT-23-6_L2.9-W1.6-P0.95-LS2.8-BR; LCSC C116592
U3, U4: TLV75519PDBVR; SOT-23-5; LCSC C2865381
U5: TLV75733PDBVR; SOT-23-5; LCSC C485517

Connections:
+1V9A: C46.1, U3.5 (OUT); also elsewhere on the board
+1V9D: C48.1, U4.5 (OUT); also elsewhere on the board
+2V5: C43.1, C44.1, C45.1, C47.1, L1.2, R33.1, U3.1 (IN), U3.3 (EN), U4.1 (IN), U4.3 (EN)
+3V3: D3.2 (A); also elsewhere on the board
+3V3A: C50.1, U5.5 (OUT); also elsewhere on the board
+5V: C39.1, C40.1, C41.1, C49.1, R32.1, U2.3 (VIN), U5.1 (IN), U5.3 (EN); also elsewhere on the board
BST_2V5: C42.1, U2.6 (VBST)
EN_2V5: R32.2, U2.5 (EN)
FB_2V5: R33.2, R34.1, U2.4 (VFB)
GND: C39.2, C40.2, C41.2, C43.2, C44.2, C45.2, C46.2, C47.2, C48.2, C49.2, C50.2, R34.2, R35.2, U2.1 (GND), U3.2 (GND), U4.2 (GND), U5.2 (GND); also elsewhere on the board
PWR_LED_K: D3.1 (K), R35.1
SW_2V5: C42.2, L1.1, U2.2 (SW)

Notes on the sheet:
Power comes from the dev-board headers: +5V (J4 pins 7-9) and +3V3 (J4 pins 10-12); no USB 3 connector. +3V3 feeds TVP7002 IOVDD, the oscillator, pull-ups and the bus-control gate. +5V feeds one TPS563201 buck to 2.5 V (SLVSD90B Table 7-2: R2 = 10k, L = 2.2 uH, 2 x 22 uF out), which is the pre-regu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
LDOs: 2.5 V -> 1.9 V for TVP7002 AVDD/PLL and DVDD (two TLV75519, 500 mA); +5V -> 3.3 V for TVP7002 A33VDD alone (TLV75733, 1 A), kept off the board's 3V3 rail.
Power LED on +3V3, mounting holes.
Power flags (ERC): +2V5, +3V3, +5V, GND, OSC_VDD, TVP_AVDD, TVP_PLLVDD, VBUS_AUD
