rixnobis/ps1-av-capture/hat/ps1-av-hat.kicad_pcb

## KiCad design hat/ps1-av-hat.kicad_pcb (continued)

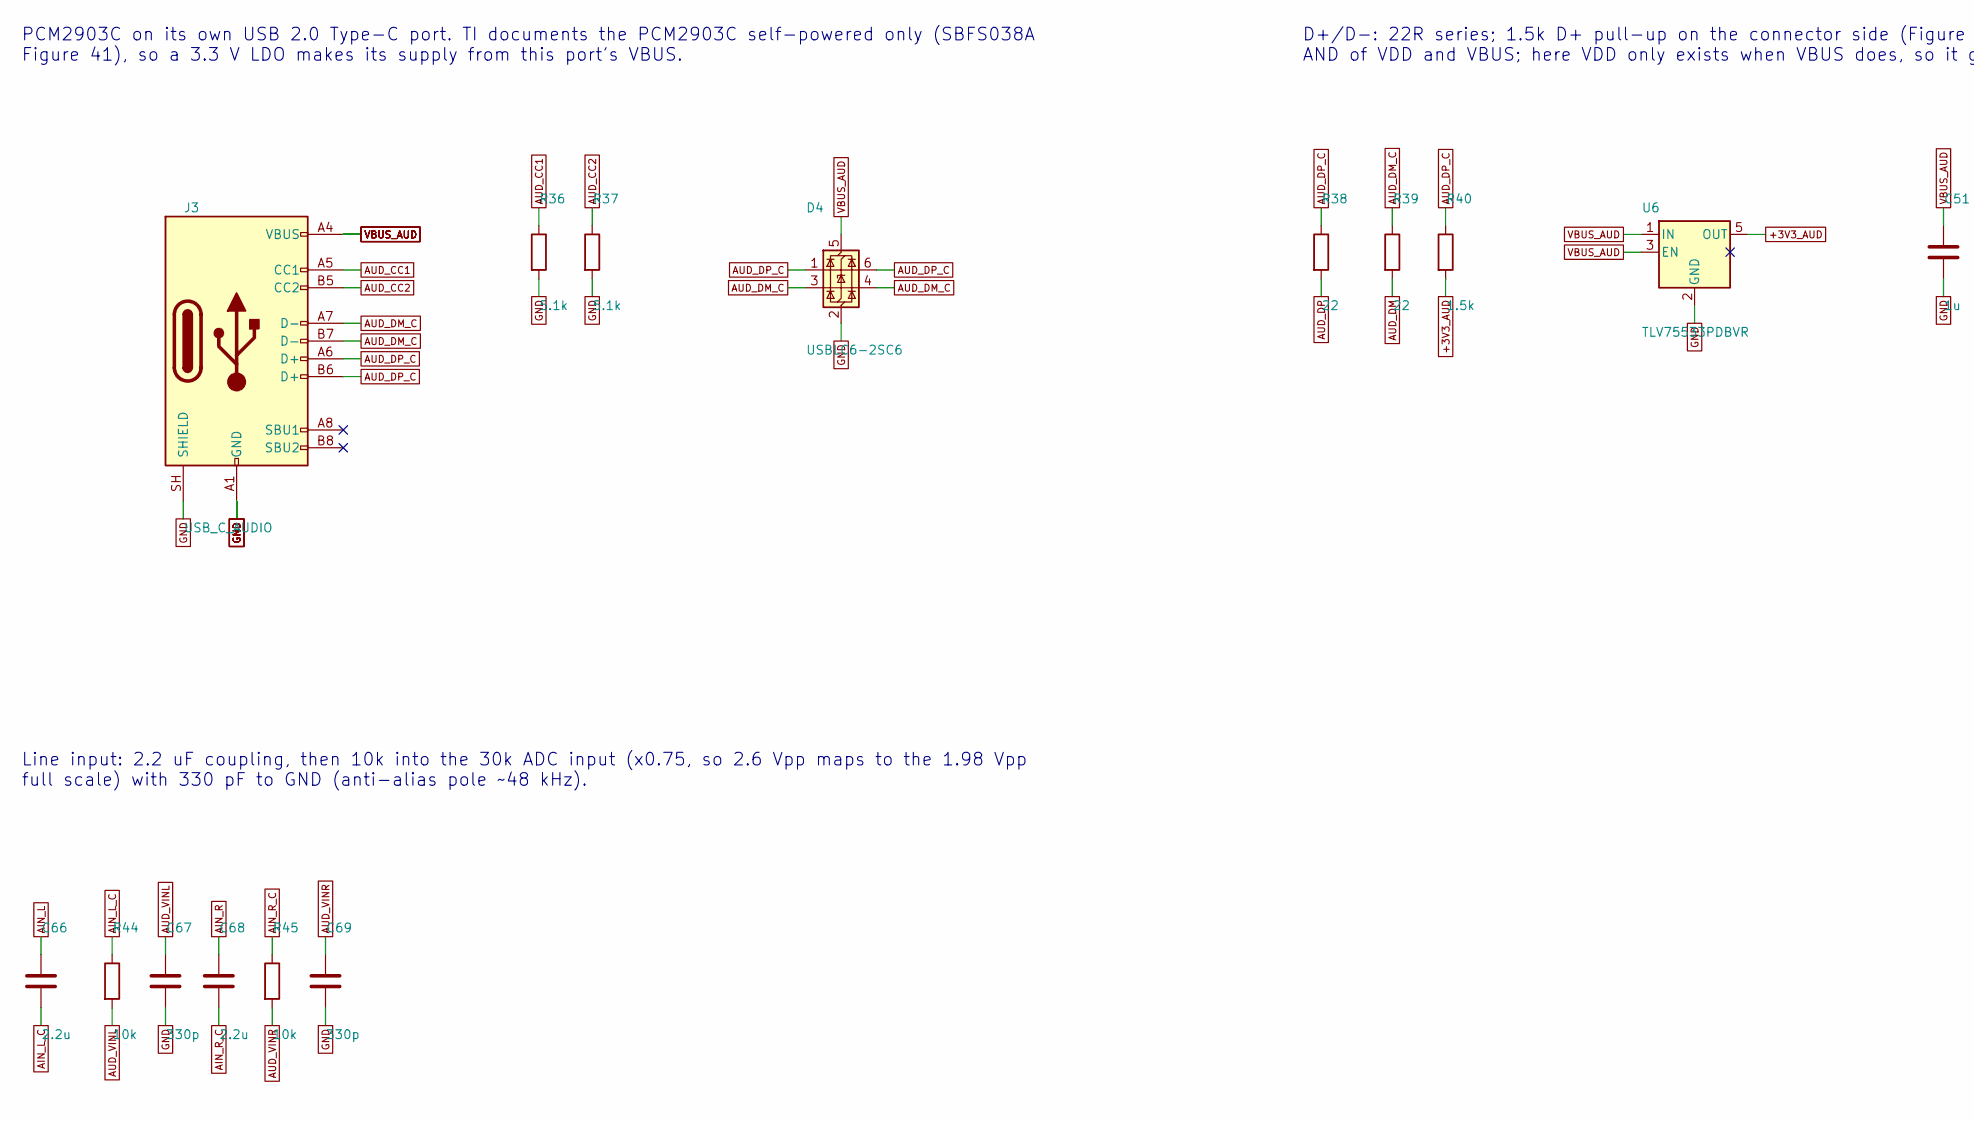
[picture p31: schematic audio.kicad_sch, PCM2903C USB audio, part in row 1, column 1]

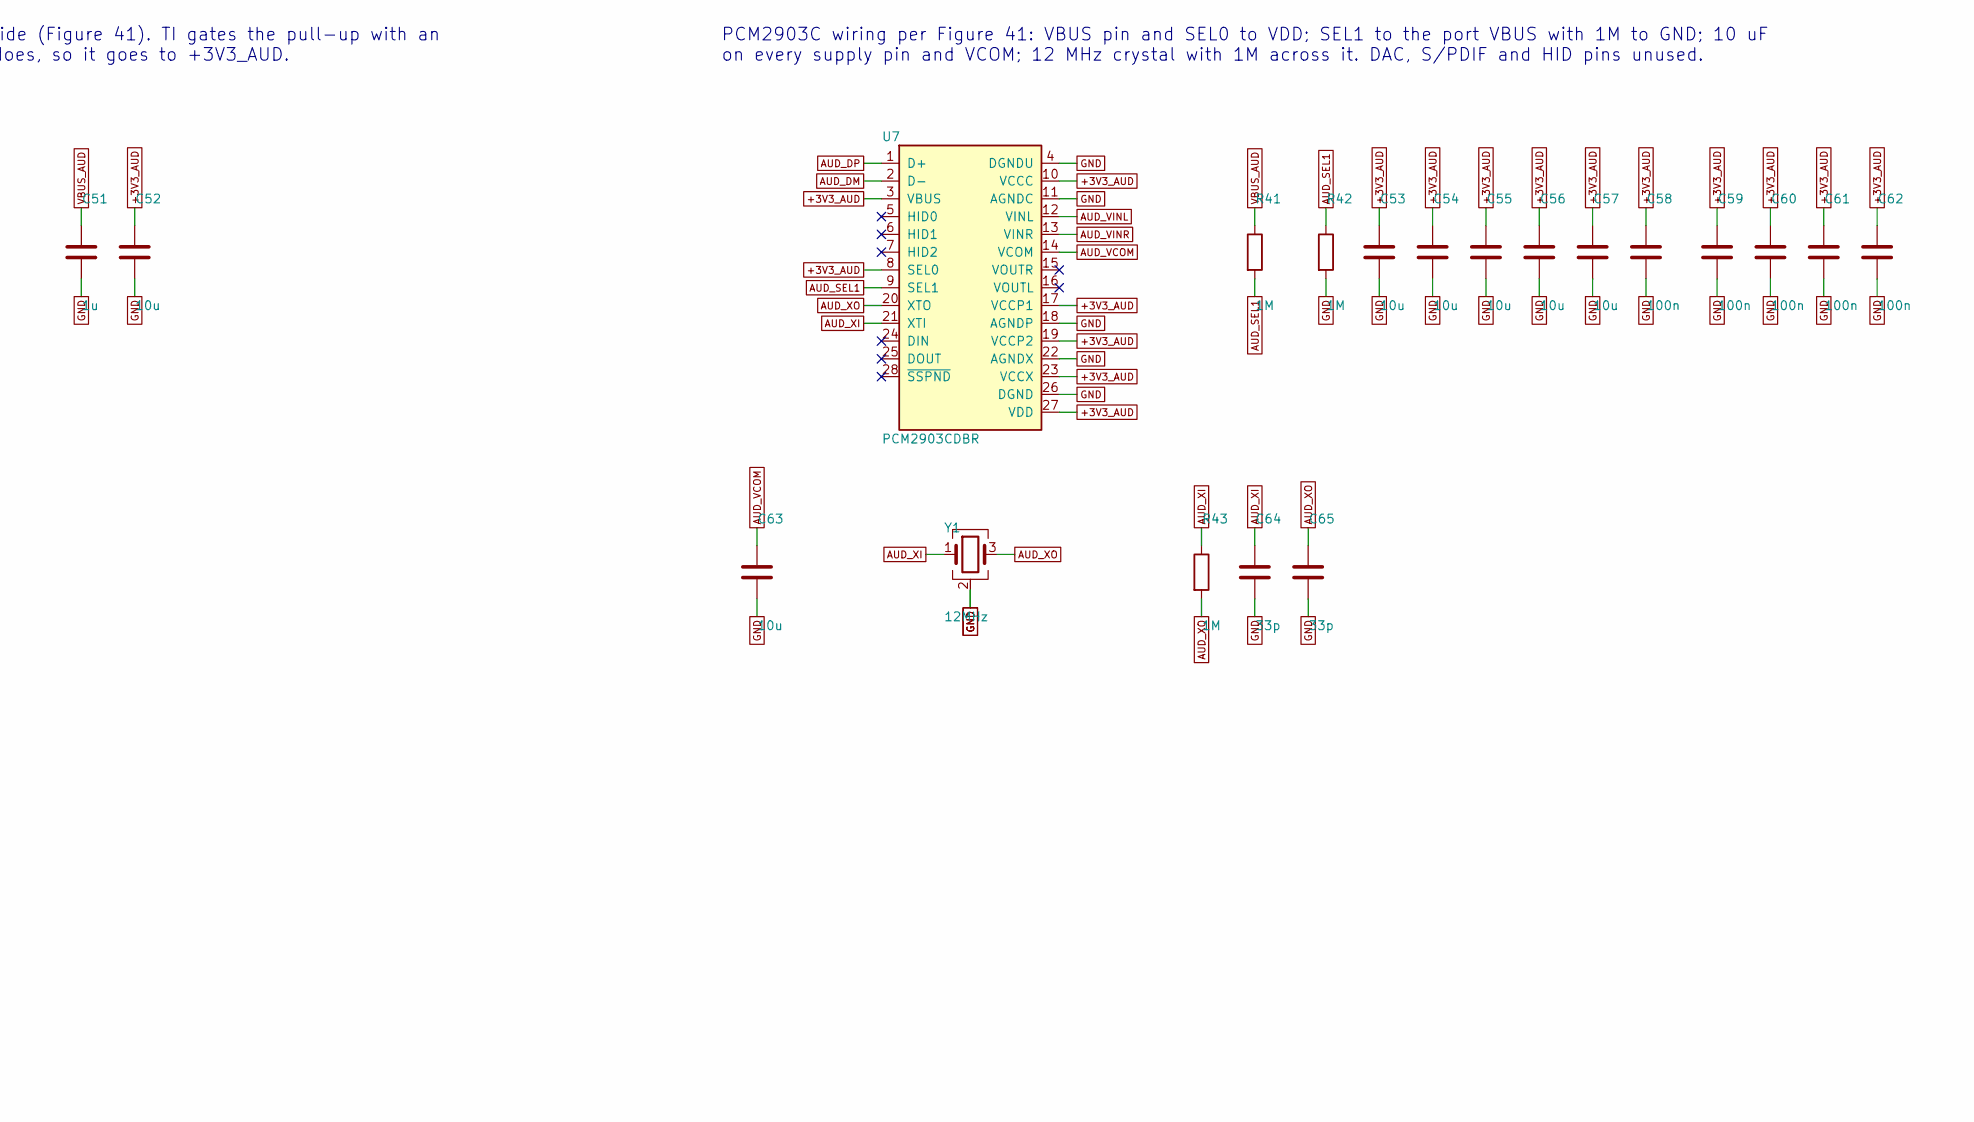
[picture p32: schematic audio.kicad_sch, PCM2903C USB audio, part in row 1, column 2]

Parts:
C51: 1u; C_0402_1005Metric; LCSC C52923
C52, C53, C54, C55, C56, C57, C63: 10u; C_0603_1608Metric; LCSC C19702
C58, C59, C60, C61, C62: 100n; C_0402_1005Metric; LCSC C1525
C64, C65: 33p; C_0402_1005Metric; LCSC C1562
C66, C68: 2.2u; C_0603_1608Metric; LCSC C23630
C67, C69: 330p; C_0402_1005Metric; LCSC C13533
D4: USBLC6-2SC6; SOT-23-6; LCSC C7519
J3: USB_C_AUDIO; USB_C_Receptacle_HRO_TYPE-C-31-M-12; LCSC C165948
R36, R37: 5.1k; R_0402_1005Metric; LCSC C25905
R38, R39: 22; R_0402_1005Metric; LCSC C25092
R40: 1.5k; R_0402_1005Metric; LCSC C25867
R41, R42, R43: 1M; R_0402_1005Metric; LCSC C26083
R44, R45: 10k; R_0402_1005Metric; LCSC C25744
U6: TLV75533PDBVR; SOT-23-5; LCSC C404027
U7: PCM2903CDBR; SSOP-28_5.3x10.2mm_P0.65mm; LCSC C2861593
Y1: 12MHz; Crystal_SMD_3225-4Pin_3.2x2.5mm; LCSC C9002

Connections:
+3V3_AUD: C52.1, C53.1, C54.1, C55.1, C56.1, C57.1, C58.1, C59.1, C60.1, C61.1, C62.1, R40.2, U6.5 (OUT), U7.3 (VBUS), U7.8 (SEL0), U7.10 (VCCC), U7.17 (VCCP1), U7.19 (VCCP2), U7.23 (VCCX), U7.27 (VDD)
AIN_L: C66.1; also elsewhere on the board
AIN_L_C: C66.2, R44.1; also elsewhere on the board
AIN_R: C68.1; also elsewhere on the board
AIN_R_C: C68.2, R45.1; also elsewhere on the board
AUD_CC1: J3.A5 (CC1), R36.1
AUD_CC2: J3.B5 (CC2), R37.1
AUD_DM: R39.2, U7.2 (D-)
AUD_DM_C: D4.3 (I/O2), D4.4 (I/O2), J3.A7 (D-), J3.B7 (D-), R39.1
AUD_DP: R38.2, U7.1 (D+)
AUD_DP_C: D4.1 (I/O1), D4.6 (I/O1), J3.A6 (D+), J3.B6 (D+), R38.1, R40.1
AUD_SEL1: R41.2, R42.1, U7.9 (SEL1)
AUD_VCOM: C63.1, U7.14 (VCOM)
AUD_VINL: C67.1, R44.2, U7.12 (VINL)
AUD_VINR: C69.1, R45.2, U7.13 (VINR)
AUD_XI: C64.1, R43.1, U7.21 (XTI), Y1.1
AUD_XO: C65.1, R43.2, U7.20 (XTO), Y1.3
GND: C51.2, C52.2, C53.2, C54.2, C55.2, C56.2, C57.2, C58.2, C59.2, C60.2, C61.2, C62.2, C63.2, C64.2, C65.2, C67.2, C69.2, D4.2 (GND), J3.A1 (GND), J3.A12 (GND), J3.B1 (GND), J3.B12 (GND), J3.SH (SHIELD), R36.2, R37.2, R42.2, U6.2 (GND), U7.4 (DGNDU), U7.11 (AGNDC), U7.18 (AGNDP), U7.22 (AGNDX), U7.26 (DGND), Y1.2 (G), Y1.4 (G); also elsewhere on the board
VBUS_AUD: C51.1, D4.5 (VBUS), J3.A4 (VBUS), J3.A9 (VBUS), J3.B4 (VBUS), J3.B9 (VBUS), R41.1, U6.1 (IN), U6.3 (EN)

Notes on the sheet:
PCM2903C on its own USB 2.0 Type-C port. TI documents the PCM2903C self-powered only (SBFS038A Figure 41), so a 3.3 V LDO makes its supply from this port's VBUS.
D+/D-: 22R series; 1.5k D+ pull-up on the connector side (Figure 41). TI gates the pull-up with an AND of VDD and VBUS; here VDD only exists when VBUS does, so it goes to +3V3_AUD.
PCM2903C wiring per Figure 41: VBUS pin and SEL0 to VDD; SEL1 to the port VBUS with 1M to GND; 10 uF on every supply pin and VCOM; 12 MHz crystal with 1M across it. DAC, S/PDIF and HID pins unused.
Line input: 2.2 uF coupling, then 10k into the 30k ADC input (x0.75, so 2.6 Vpp maps to the 1.98 Vpp full scale) with 330 pF to GND (anti-alias pole ~48 kHz).

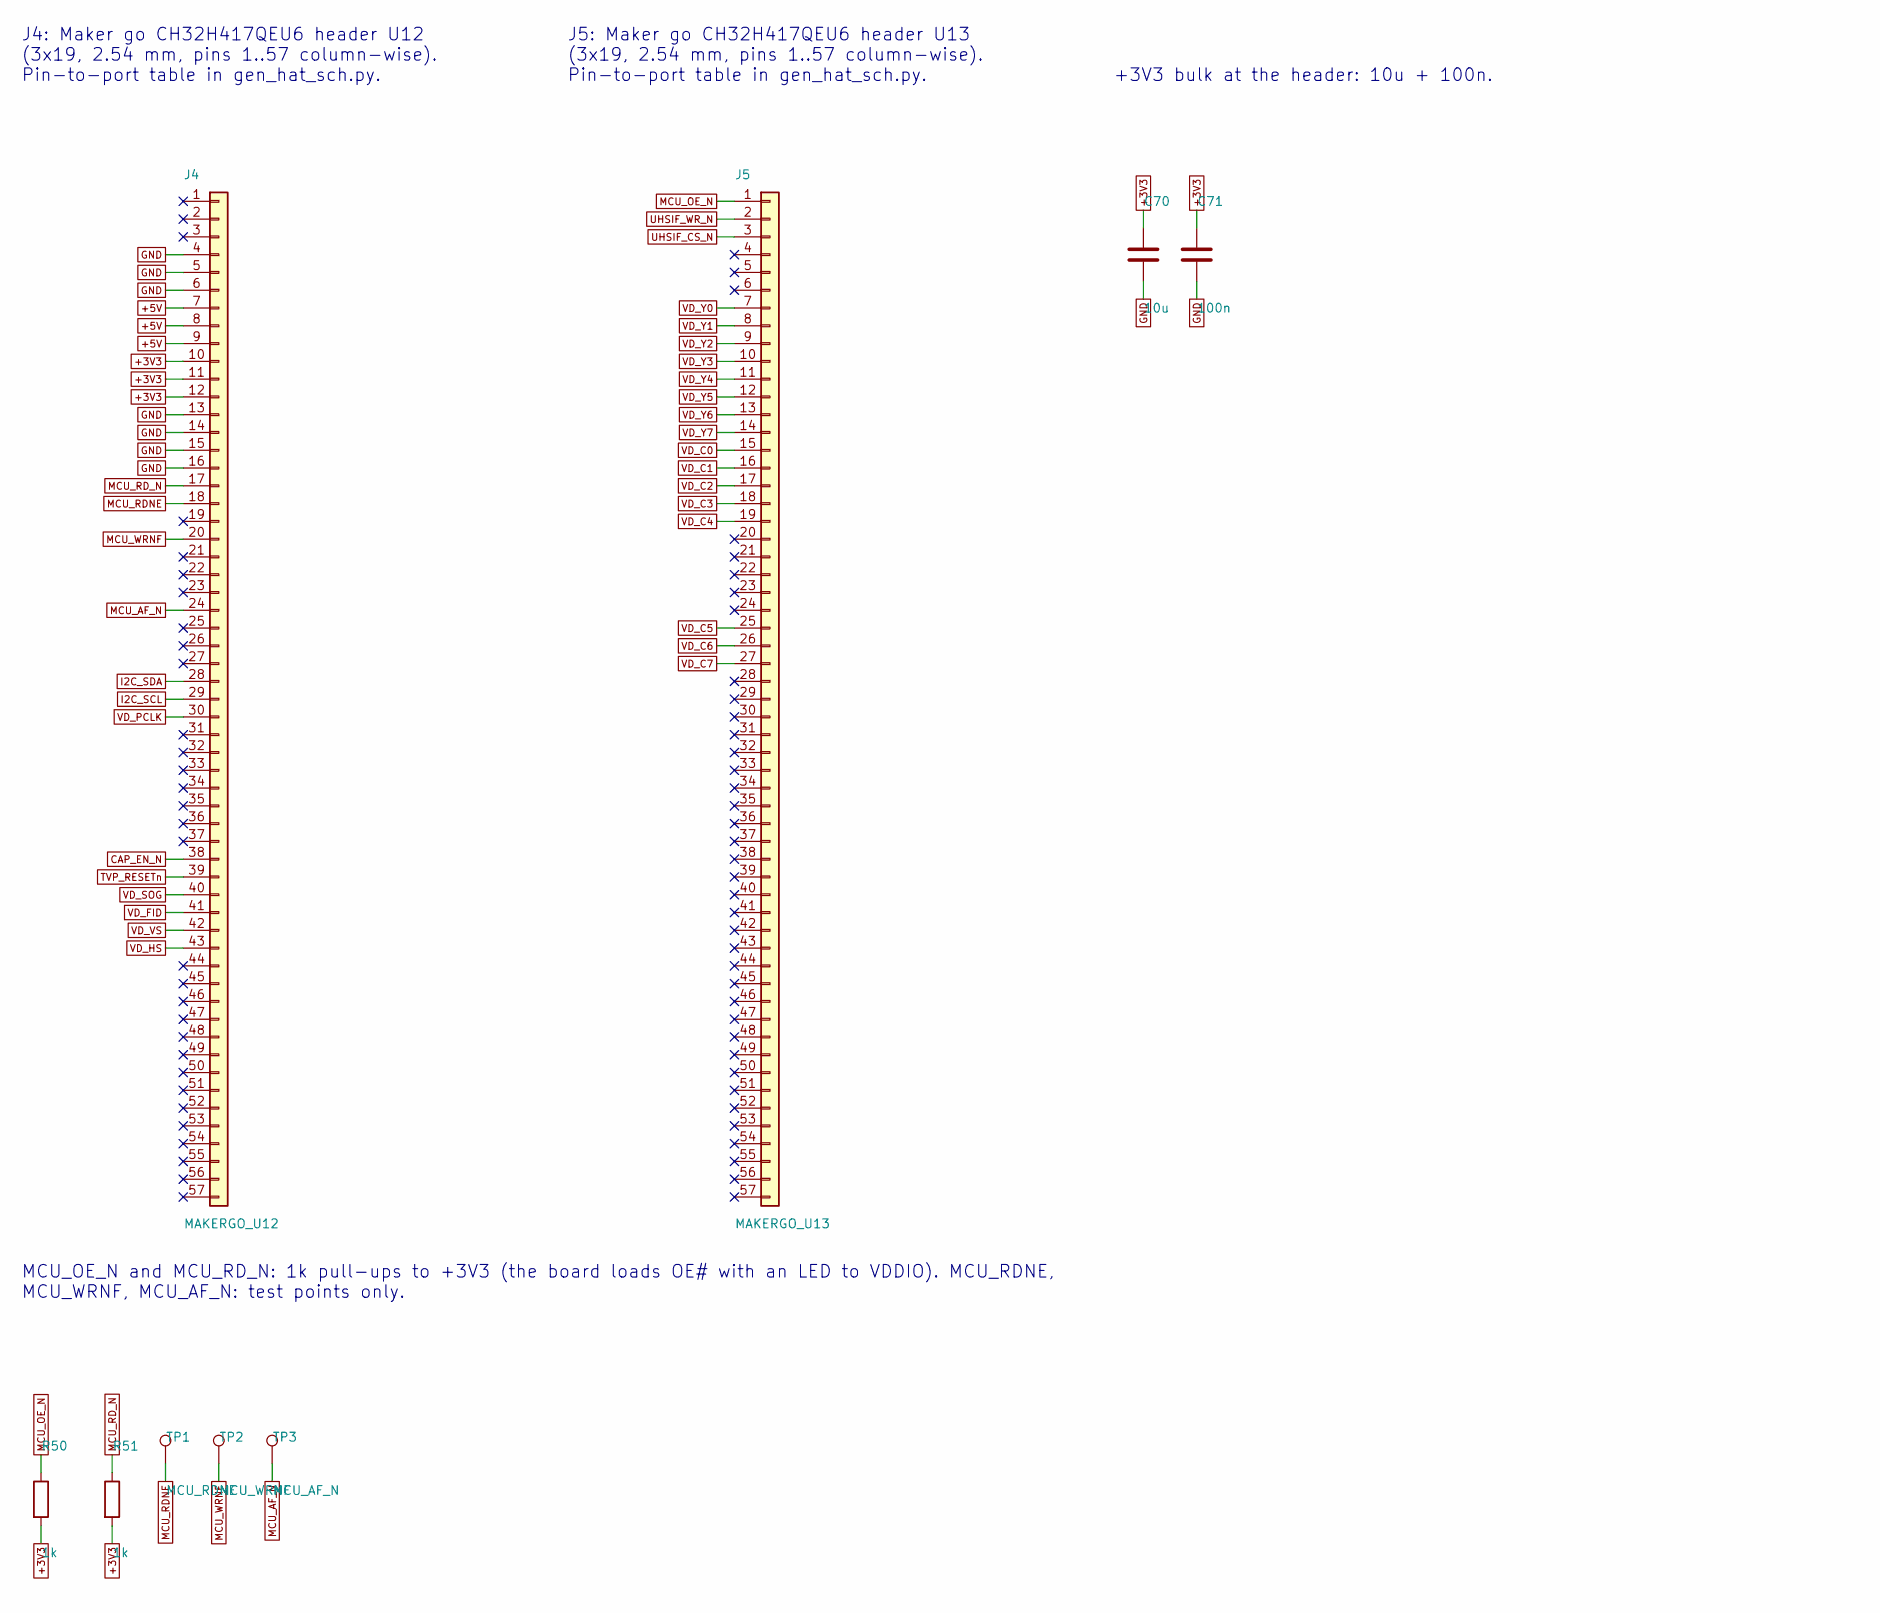
[picture p33: schematic mcu.kicad_sch, CH32H417 dev-board headers and bus control, part in row 1, column 1]

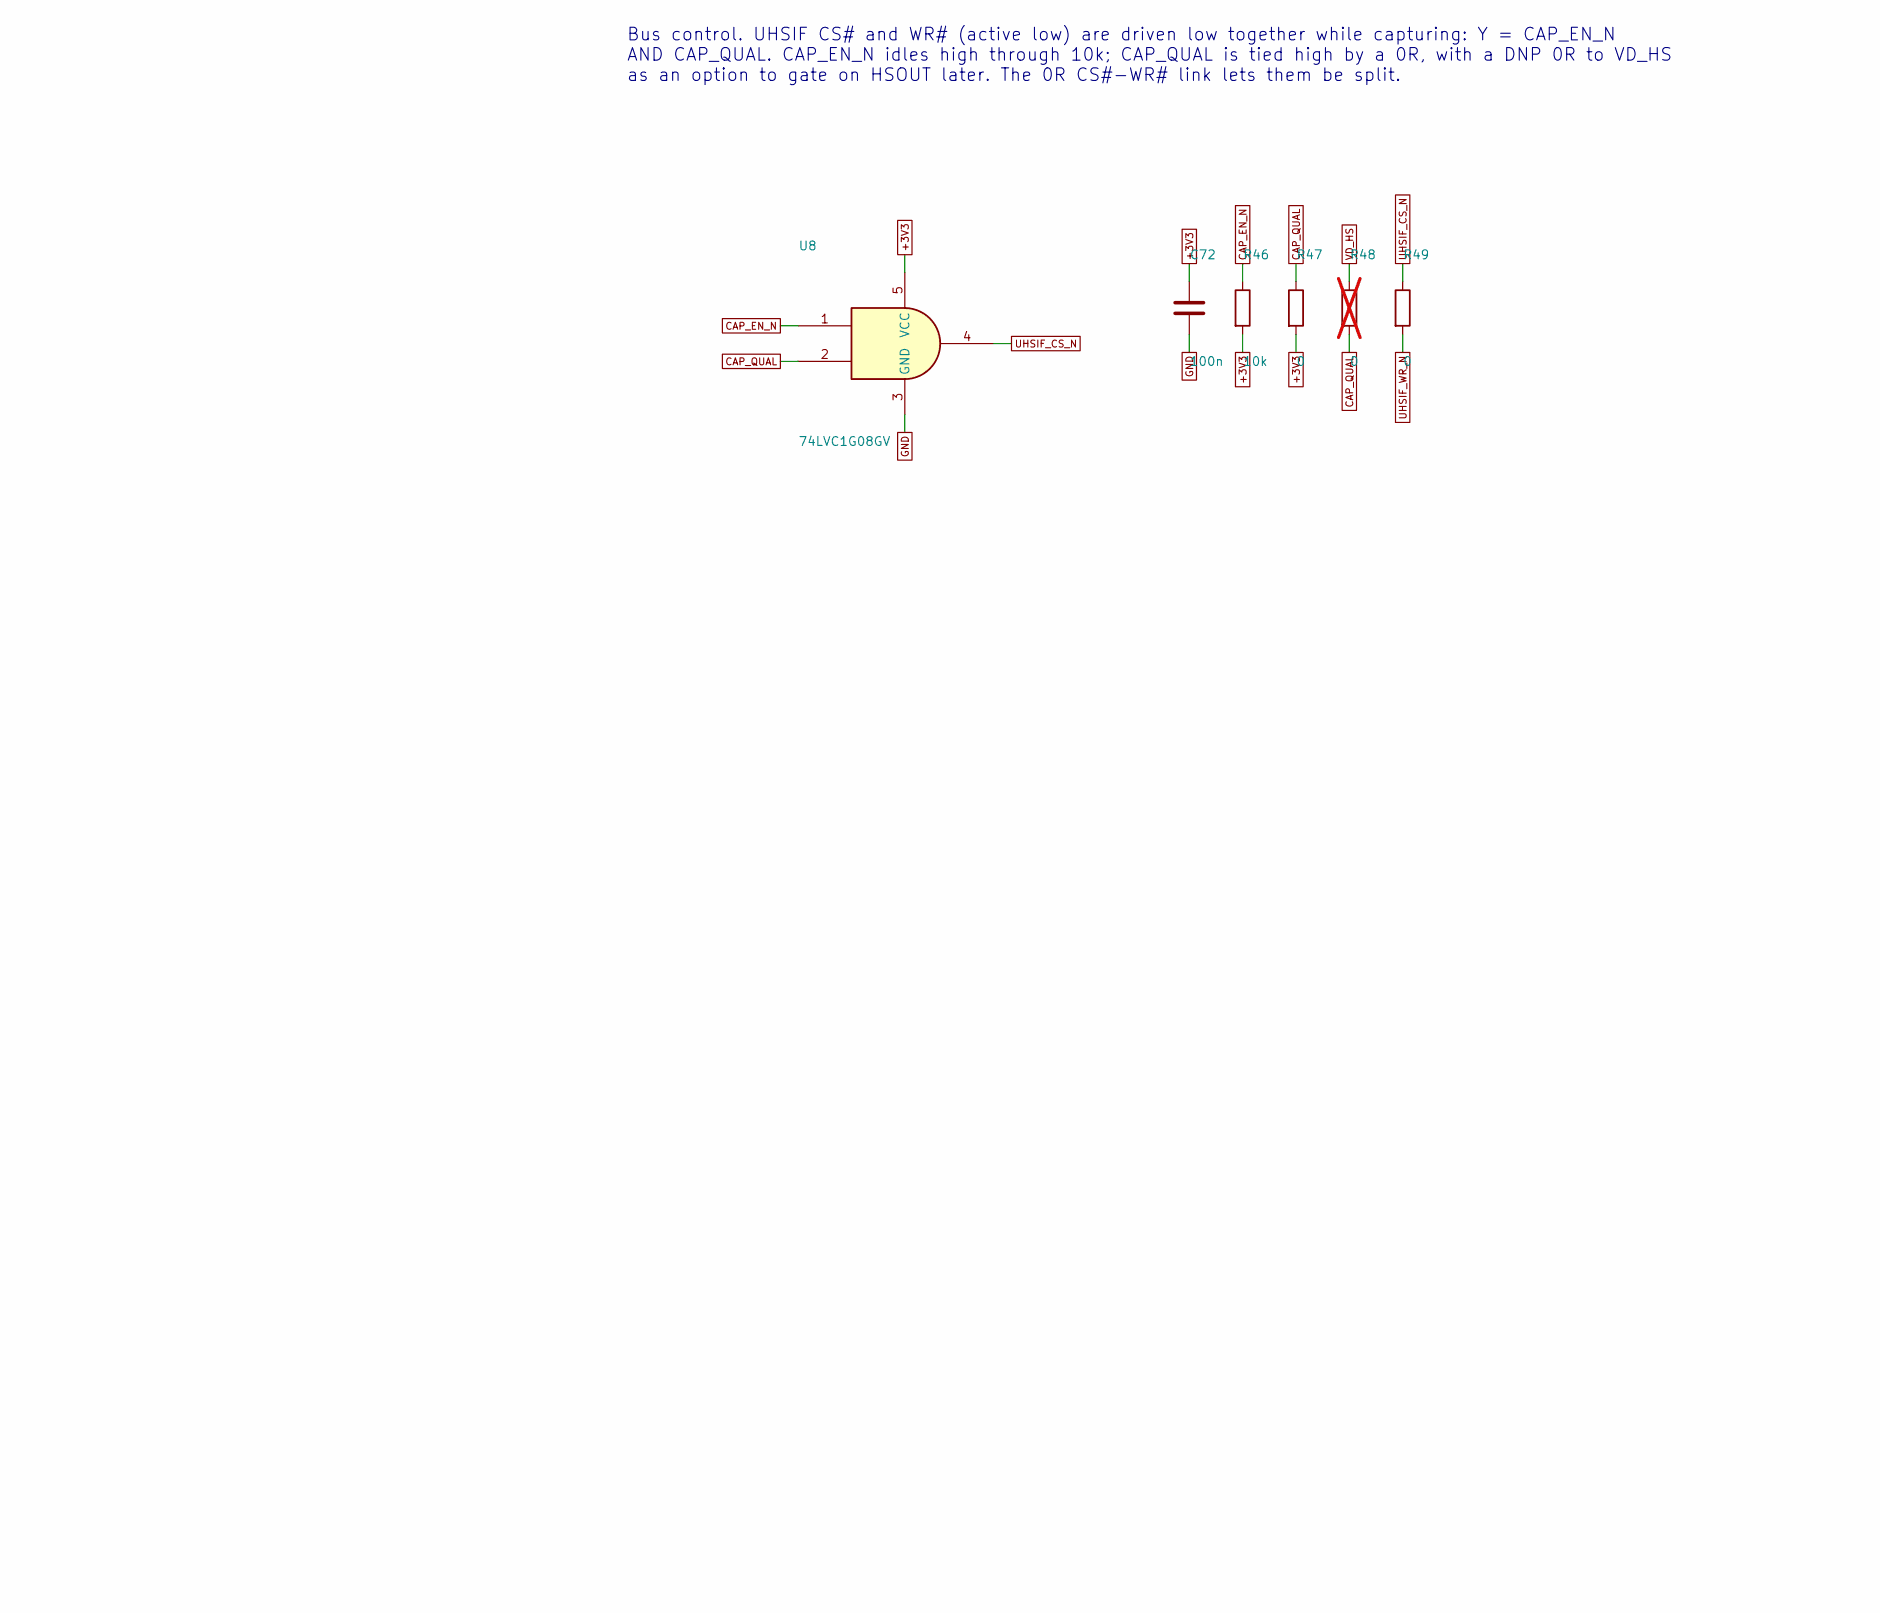
[picture p34: schematic mcu.kicad_sch, CH32H417 dev-board headers and bus control, part in row 1, column 2]

Parts:
C70: 10u; C_0603_1608Metric; LCSC C19702
C71, C72: 100n; C_0402_1005Metric; LCSC C1525
J4: MAKERGO_U12; Socket_3x19_P2.54_MakerGo
J5: MAKERGO_U13; Socket_3x19_P2.54_MakerGo
R46: 10k; R_0402_1005Metric; LCSC C25744
R47, R49: 0; R_0402_1005Metric; LCSC C17168
R48: 0; R_0402_1005Metric; LCSC C17168; not fitted
R50, R51: 1k; R_0402_1005Metric; LCSC C11702
TP1: MCU_RDNE; TestPoint_Pad_D1.0mm
TP2: MCU_WRNF; TestPoint_Pad_D1.0mm
TP3: MCU_AF_N; TestPoint_Pad_D1.0mm
U8: 74LVC1G08GV; SOT-23-5; LCSC C19829591

Connections:
+3V3: C70.1, C71.1, C72.1, J4.10, J4.11, J4.12, R46.2, R47.2, R50.2, R51.2, U8.5 (VCC); also elsewhere on the board
+5V: J4.7, J4.8, J4.9; also elsewhere on the board
CAP_EN_N: J4.38, R46.1, U8.1
CAP_QUAL: R47.1, R48.2, U8.2
GND: C70.2, C71.2, C72.2, J4.4, J4.5, J4.6, J4.13, J4.14, J4.15, J4.16, U8.3 (GND); also elsewhere on the board
I2C_SCL: J4.29; also elsewhere on the board
I2C_SDA: J4.28; also elsewhere on the board
MCU_AF_N: J4.24, TP3.1
MCU_OE_N: J5.1, R50.1
MCU_RDNE: J4.18, TP1.1
MCU_RD_N: J4.17, R51.1
MCU_WRNF: J4.20, TP2.1
TVP_RESETn: J4.39; also elsewhere on the board
UHSIF_CS_N: J5.3, R49.1, U8.4
UHSIF_WR_N: J5.2, R49.2
VD_C0: J5.15; also elsewhere on the board
VD_C1: J5.16; also elsewhere on the board
VD_C2: J5.17; also elsewhere on the board
VD_C3: J5.18; also elsewhere on the board
VD_C4: J5.19; also elsewhere on the board
VD_C5: J5.25; also elsewhere on the board
VD_C6: J5.26; also elsewhere on the board
VD_C7: J5.27; also elsewhere on the board
VD_FID: J4.41; also elsewhere on the board
VD_HS: J4.43, R48.1; also elsewhere on the board
VD_PCLK: J4.30; also elsewhere on the board
VD_SOG: J4.40; also elsewhere on the board
VD_VS: J4.42; also elsewhere on the board
VD_Y0: J5.7; also elsewhere on the board
VD_Y1: J5.8; also elsewhere on the board
VD_Y2: J5.9; also elsewhere on the board
VD_Y3: J5.10; also elsewhere on the board
VD_Y4: J5.11; also elsewhere on the board
VD_Y5: J5.12; also elsewhere on the board
VD_Y6: J5.13; also elsewhere on the board
VD_Y7: J5.14; also elsewhere on the board

Notes on the sheet:
J4: Maker go CH32H417QEU6 header U12 (3x19, 2.54 mm, pins 1..57 column-wise). Pin-to-port table in gen_hat_sch.py.
J5: Maker go CH32H417QEU6 header U13 (3x19, 2.54 mm, pins 1..57 column-wise). Pin-to-port table in gen_hat_sch.py.
+3V3 bulk at the header: 10u + 100n.
Bus control. UHSIF CS# and WR# (active low) are driven low together while capturing: Y = CAP_EN_N AND CAP_QUAL. CAP_EN_N idles high through 10k; CAP_QUAL is tied high by a 0R, with a DNP 0R to VD_HS as an option to gate on HSOUT later. The 0R CS#-WR# link lets them be split.
MCU_OE_N and MCU_RD_N: 1k pull-ups to +3V3 (the board loads OE# with an LED to VDDIO). MCU_RDNE, MCU_WRNF, MCU_AF_N: test points only.

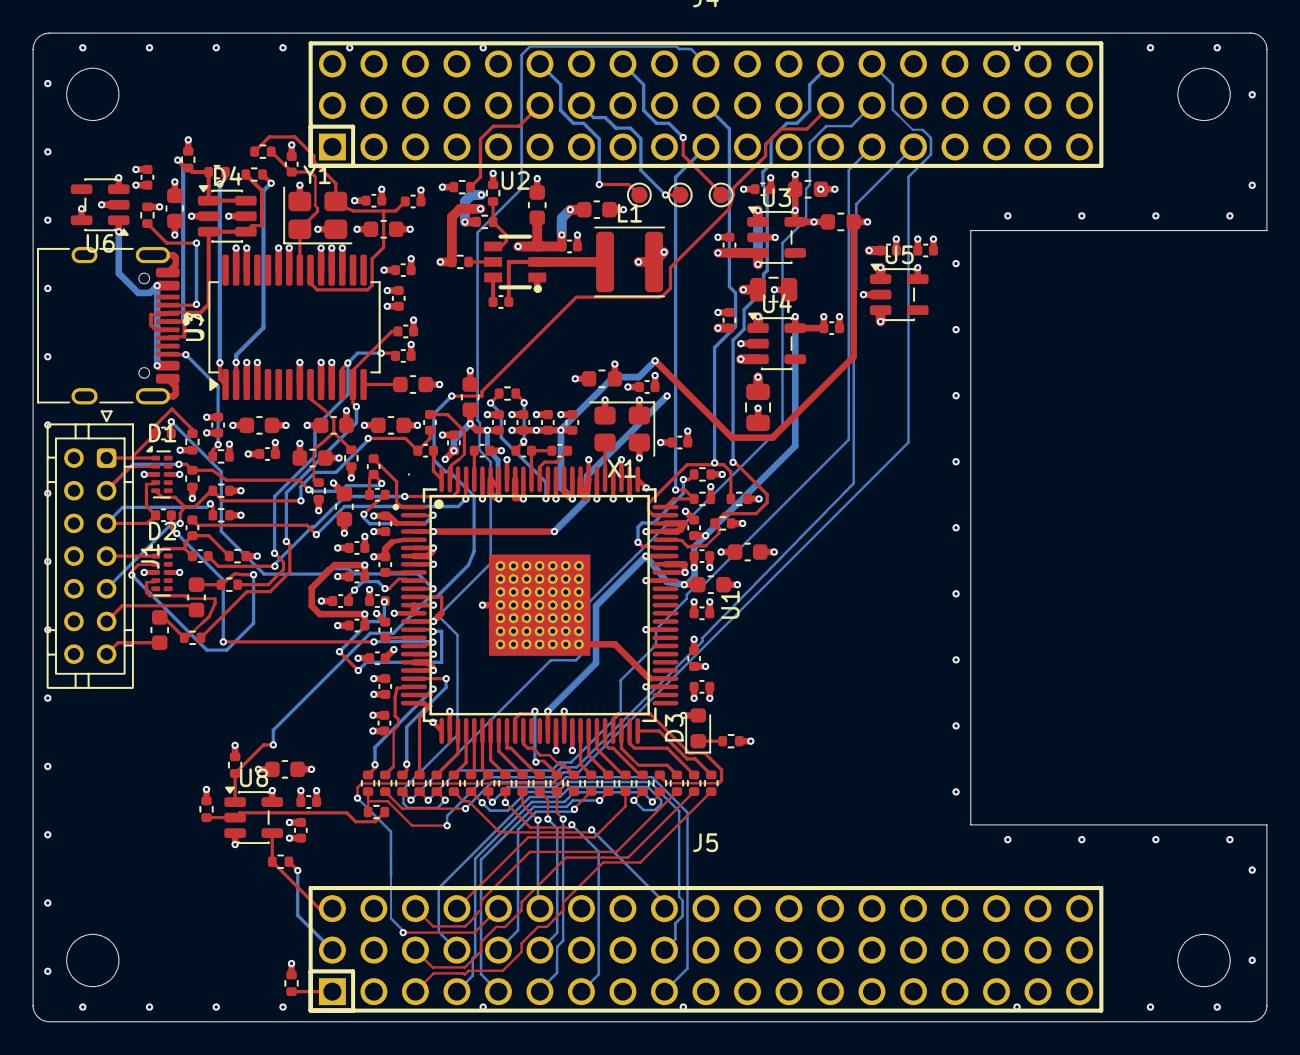
[picture p35: board ps1-av-hat.kicad_pcb from above]

Board: 4 copper layers, 75.5 x 60.5 mm, 152 parts (0 on the bottom side), 111 nets.
