rixnobis/ps1-av-capture/ps1-av-capture.kicad_pcb

## KiCad design ps1-av-capture.kicad_pcb (2026-10-28)

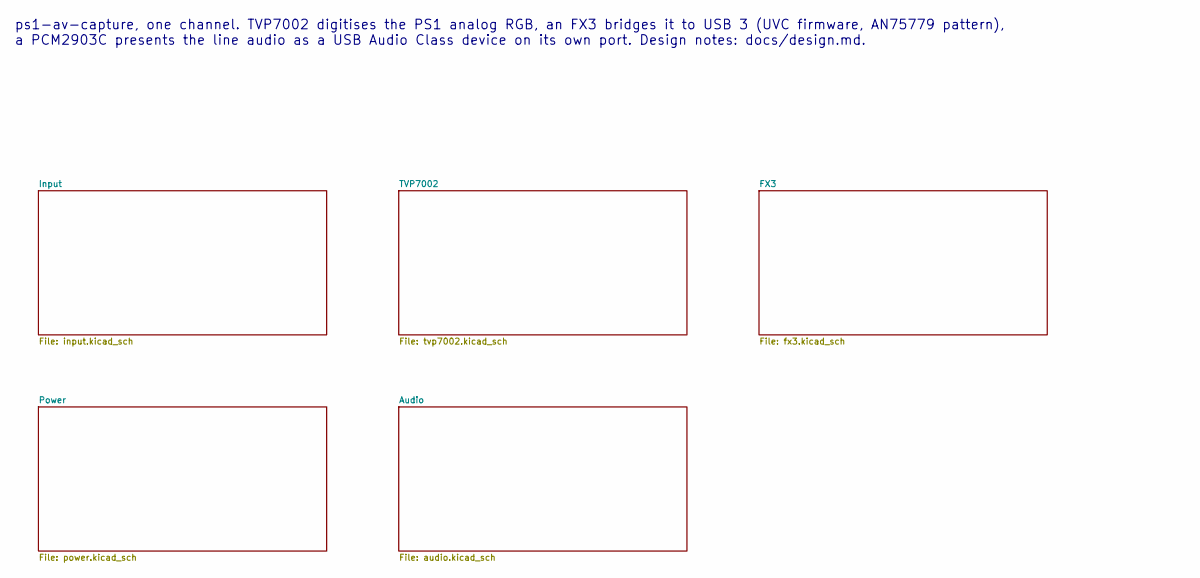
[picture p36: schematic ps1-av-capture.kicad_sch, ps1-av-capture: PS1 RGB + audio to USB]

Notes on the sheet:
ps1-av-capture, one channel. TVP7002 digitises the PS1 analog RGB, an FX3 bridges it to USB 3 (UVC firmware, AN75779 pattern), a PCM2903C presents the line audio as a USB Audio Class device on its own port. Design notes: docs/design.md.

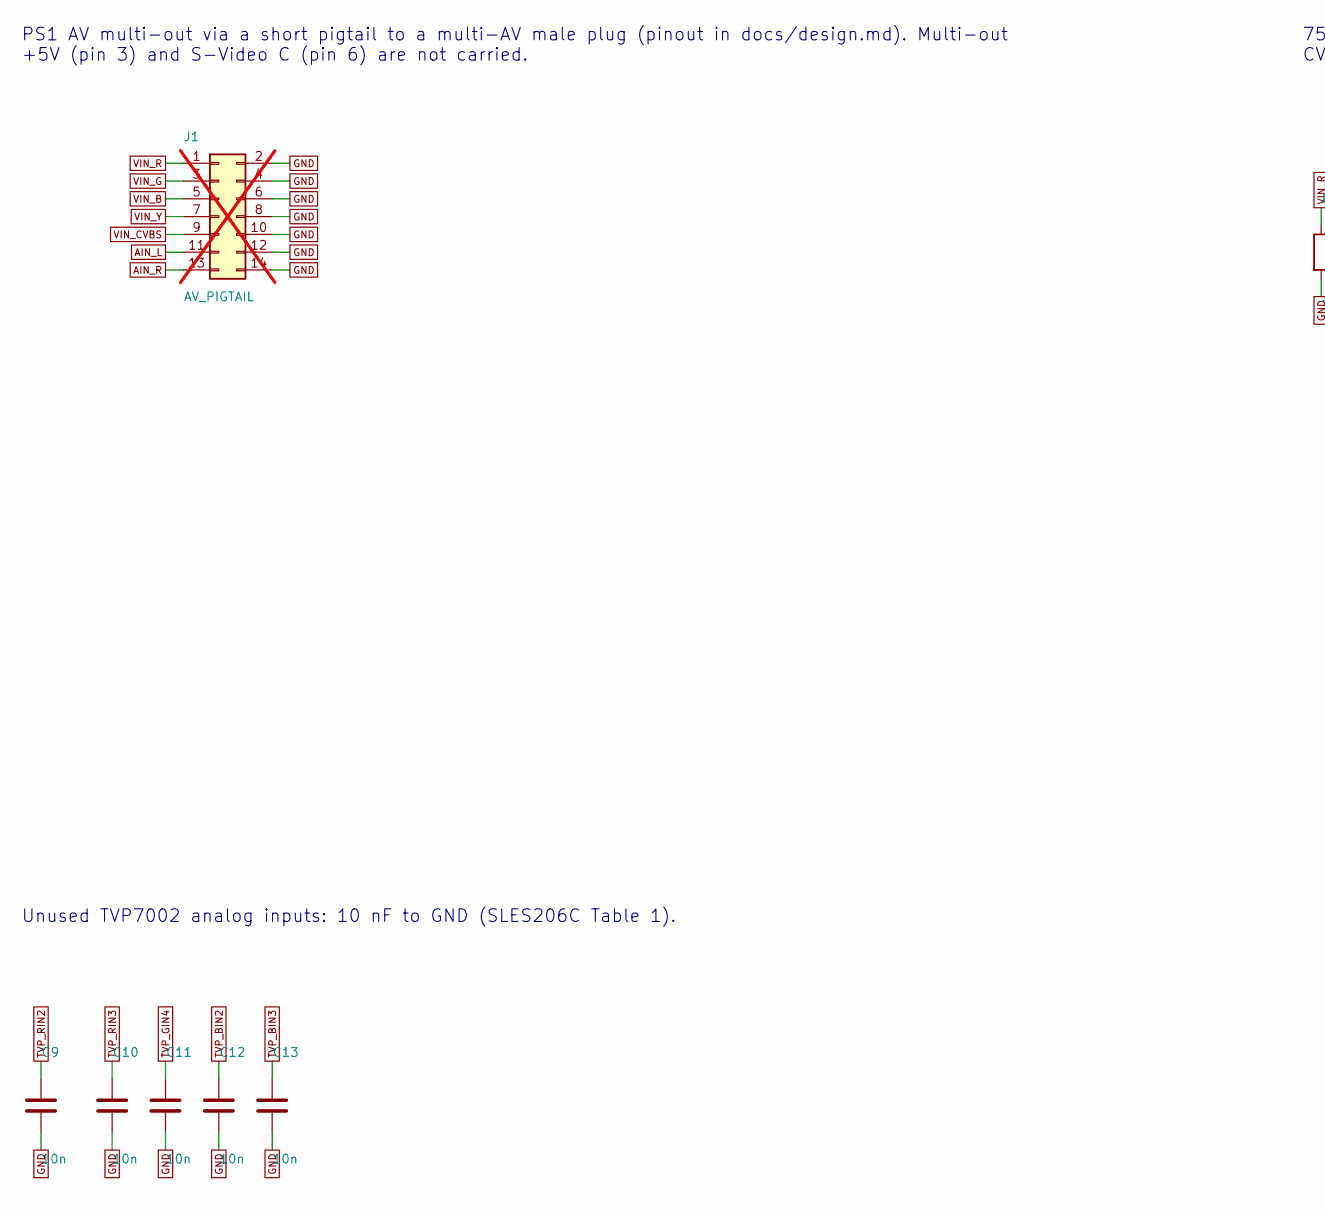
[picture p37: schematic input.kicad_sch, AV multi-out input, termination, ESD, part in row 1, column 1]


Parts:
C1, C2, C3, C4, C5: 100n; C_0402_1005Metric; LCSC C1525
C6, C7, C8: 1n; C_0402_1005Metric; LCSC C1523
C9, C10, C11, C12, C13: 10n; C_0402_1005Metric; LCSC C15195
D1, D2: TPD4E05U06DQAR; USON-10_2.5x1.0mm_P0.5mm; LCSC C138714
J1: AV_PIGTAIL; JST_PHD_B14B-PHDSS_2x07_P2.00mm_Vertical; LCSC C471471; not fitted
R1, R2, R3, R4, R5: 75; R_0402_1005Metric; LCSC C25133

Connections:
AIN_L: J1.11; also elsewhere on the board
AIN_L_C: D2.2 (D1-); also elsewhere on the board
AIN_R: J1.13; also elsewhere on the board
AIN_R_C: D2.4 (D2+); also elsewhere on the board
GND: C9.2, C10.2, C11.2, C12.2, C13.2, D1.3 (GND), D1.8 (GND), D2.3 (GND), D2.8 (GND), J1.2, J1.4, J1.6, J1.8, J1.10, J1.12, J1.14, R1.2, R2.2, R3.2, R4.2, R5.2; also elsewhere on the board
TVP_BIN1: C3.2; also elsewhere on the board
TVP_BIN2: C12.1; also elsewhere on the board
TVP_BIN3: C13.1; also elsewhere on the board
TVP_GIN1: C2.2; also elsewhere on the board
TVP_GIN2: C4.2; also elsewhere on the board
TVP_GIN3: C5.2; also elsewhere on the board
TVP_GIN4: C11.1; also elsewhere on the board
TVP_RIN1: C1.2; also elsewhere on the board
TVP_RIN2: C9.1; also elsewhere on the board
TVP_RIN3: C10.1; also elsewhere on the board
TVP_SOGIN1: C6.2; also elsewhere on the board
TVP_SOGIN2: C7.2; also elsewhere on the board
TVP_SOGIN3: C8.2; also elsewhere on the board
VIN_B: C3.1, D1.4 (D2+), J1.5, R3.1
VIN_CVBS: C4.1, C7.1, D1.5 (D2-), J1.9, R4.1
VIN_G: C2.1, C6.1, D1.2 (D1-), J1.3, R2.1
VIN_R: C1.1, D1.1 (D1+), J1.1, R1.1
VIN_Y: C5.1, C8.1, D2.1 (D1+), J1.7, R5.1

Notes on the sheet:
PS1 AV multi-out via a short pigtail to a multi-AV male plug (pinout in docs/design.md). Multi-out +5V (pin 3) and S-Video C (pin 6) are not carried.
75 ohm termination at the connector, then ESD, then AC coupling (TVP7002: 0.1 uF; SOG inputs: 1 nF). CVBS and Y also reach spare ADC inputs, so luma can be digitised.
Unused TVP7002 analog inputs: 10 nF to GND (SLES206C Table 1).
