rixnobis/ps1-av-capture/ps1-av-capture.kicad_pcb

## KiCad design ps1-av-capture.kicad_pcb (continued)

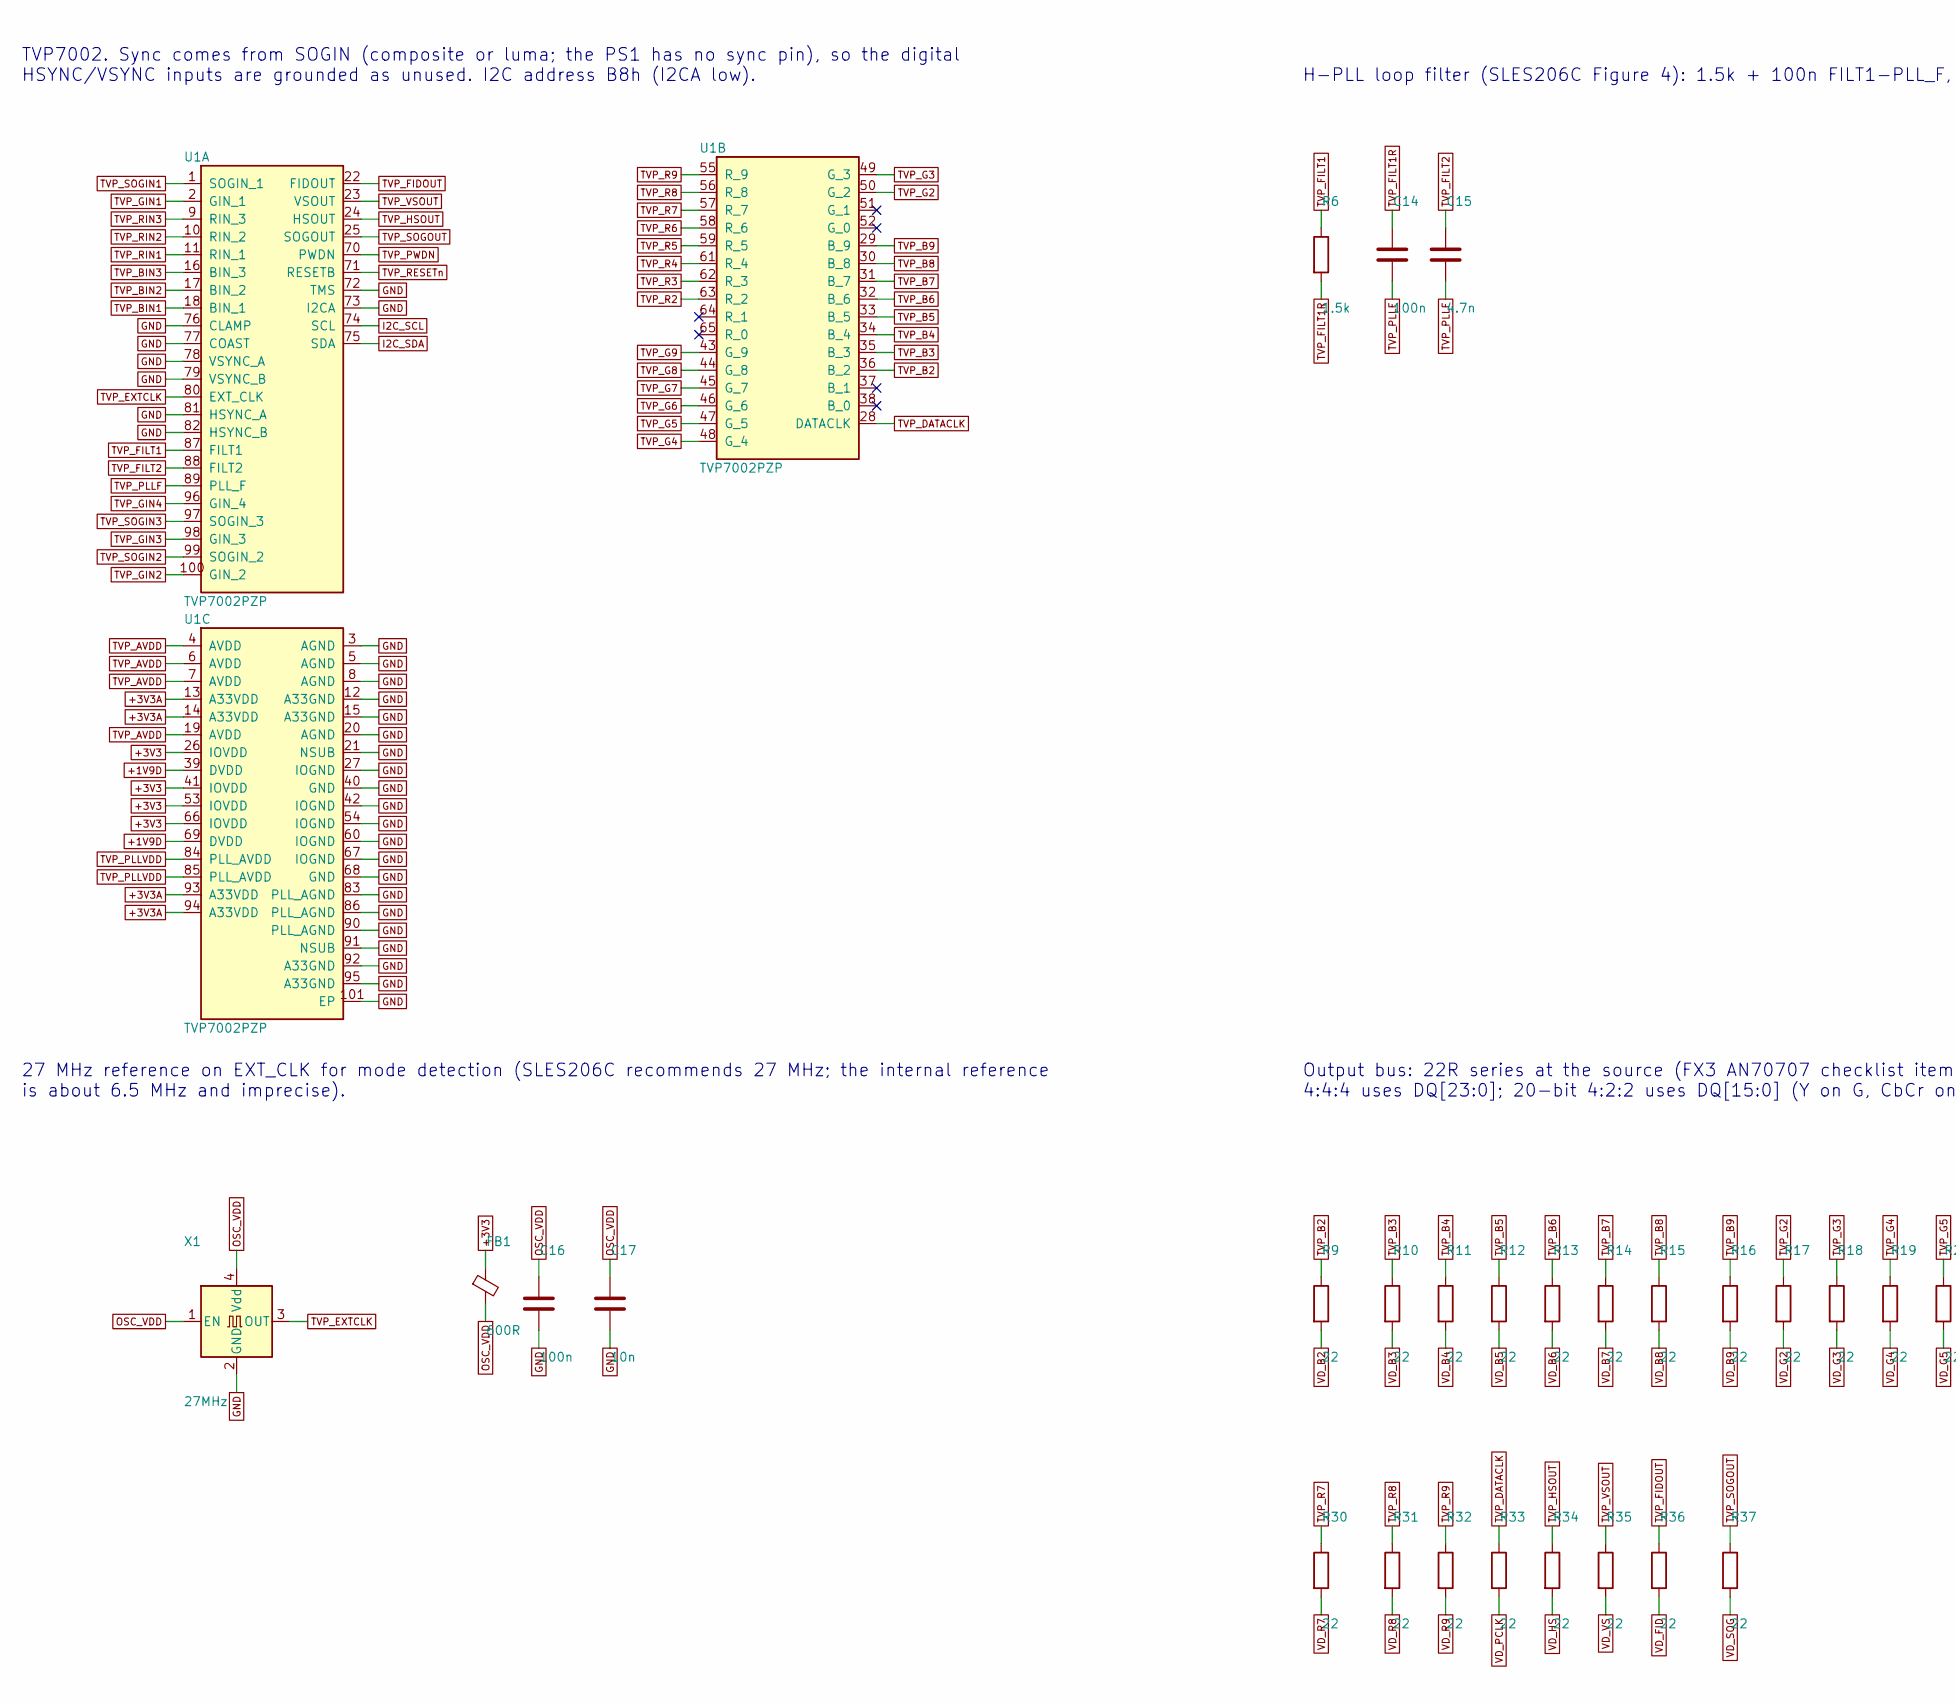
[picture p38: schematic tvp7002.kicad_sch, TVP7002 RGB digitiser, part in row 1, column 1]

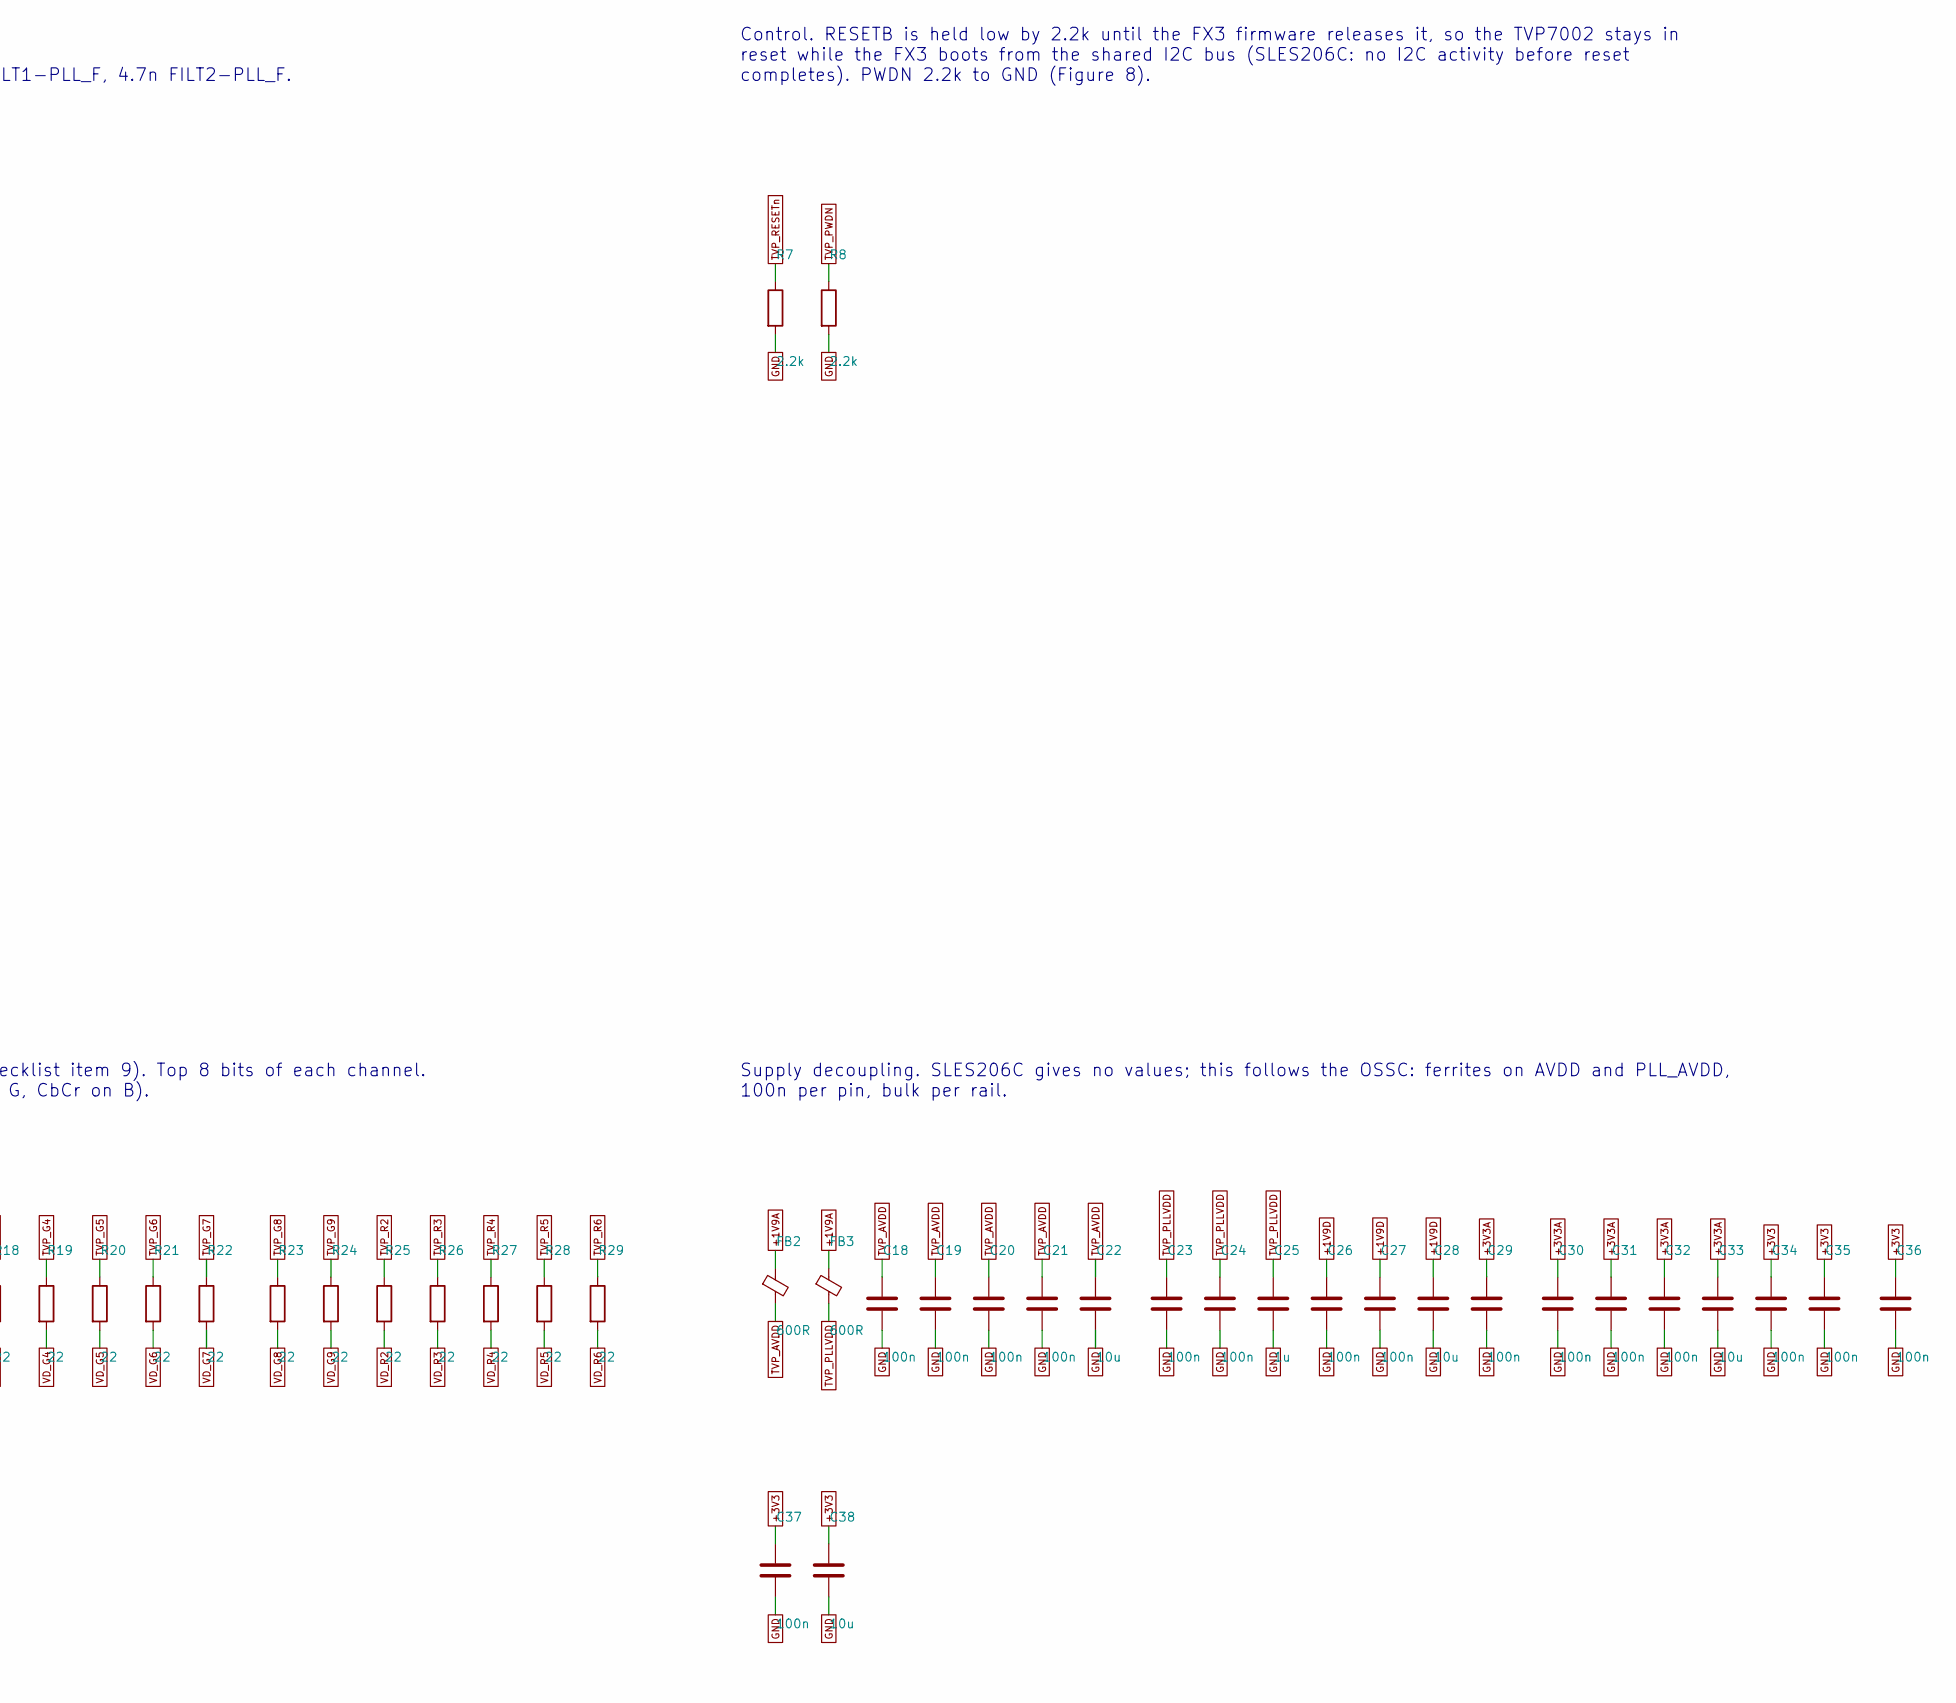
[picture p39: schematic tvp7002.kicad_sch, TVP7002 RGB digitiser, part in row 1, column 2]

Parts:
C14, C16, C18, C19, C20, C21, C23, C24, C26, C27, C29, C30, C31, C32, C34, C35, C36, C37: 100n; C_0402_1005Metric; LCSC C1525
C15: 4.7n; C_0402_1005Metric; LCSC C1538
C17: 10n; C_0402_1005Metric; LCSC C15195
C22, C28, C33, C38: 10u; C_0603_1608Metric; LCSC C19702
C25: 1u; C_0402_1005Metric; LCSC C52923
FB1, FB2, FB3: 600R; L_0603_1608Metric; LCSC C108301
R6: 1.5k; R_0402_1005Metric; LCSC C25867
R7, R8: 2.2k; R_0402_1005Metric; LCSC C25879
R9, R10, R11, R12, R13, R14, R15, R16, R17, R18, R19, R20, R21, R22, R23, R24, R25, R26, R27, R28, R29, R30, R31, R32, R33, R34, R35, R36, R37: 22; R_0402_1005Metric; LCSC C25092
U1: TVP7002PZP; HTQFP-100_L14.0-W14.0-P0.50-LS16.0-BL-EP6.2; LCSC C3824085
X1: 27MHz; Oscillator_SMD_Abracon_ASE-4Pin_3.2x2.5mm; LCSC C725995

Connections:
+1V9A: FB2.1, FB3.1; also elsewhere on the board
+1V9D: C26.1, C27.1, C28.1, U1.39 (DVDD), U1.69 (DVDD); also elsewhere on the board
+3V3: C34.1, C35.1, C36.1, C37.1, C38.1, FB1.1, U1.26 (IOVDD), U1.41 (IOVDD), U1.53 (IOVDD), U1.66 (IOVDD); also elsewhere on the board
+3V3A: C29.1, C30.1, C31.1, C32.1, C33.1, U1.13 (A33VDD), U1.14 (A33VDD), U1.93 (A33VDD), U1.94 (A33VDD); also elsewhere on the board
GND: C16.2, C17.2, C18.2, C19.2, C20.2, C21.2, C22.2, C23.2, C24.2, C25.2, C26.2, C27.2, C28.2, C29.2, C30.2, C31.2, C32.2, C33.2, C34.2, C35.2, C36.2, C37.2, C38.2, R7.2, R8.2, U1.3 (AGND), U1.5 (AGND), U1.8 (AGND), U1.12 (A33GND), U1.15 (A33GND), U1.20 (AGND), U1.21 (NSUB), U1.27 (IOGND), U1.40 (GND), U1.42 (IOGND), U1.54 (IOGND), U1.60 (IOGND), U1.67 (IOGND), U1.68 (GND), U1.72 (TMS), U1.73 (I2CA), U1.76 (CLAMP), U1.77 (COAST), U1.78 (VSYNC_A), U1.79 (VSYNC_B), U1.81 (HSYNC_A), U1.82 (HSYNC_B), U1.83 (PLL_AGND), U1.86 (PLL_AGND), U1.90 (PLL_AGND), U1.91 (NSUB), U1.92 (A33GND), U1.95 (A33GND), U1.101 (EP), X1.2 (GND); also elsewhere on the board
I2C_SCL: U1.74 (SCL); also elsewhere on the board
I2C_SDA: U1.75 (SDA); also elsewhere on the board
OSC_VDD: C16.1, C17.1, FB1.2, X1.1 (EN), X1.4 (Vdd)
TVP_AVDD: C18.1, C19.1, C20.1, C21.1, C22.1, FB2.2, U1.4 (AVDD), U1.6 (AVDD), U1.7 (AVDD), U1.19 (AVDD)
TVP_B2: R9.1, U1.36 (B_2)
TVP_B3: R10.1, U1.35 (B_3)
TVP_B4: R11.1, U1.34 (B_4)
TVP_B5: R12.1, U1.33 (B_5)
TVP_B6: R13.1, U1.32 (B_6)
TVP_B7: R14.1, U1.31 (B_7)
TVP_B8: R15.1, U1.30 (B_8)
TVP_B9: R16.1, U1.29 (B_9)
TVP_BIN1: U1.18 (BIN_1); also elsewhere on the board
TVP_BIN2: U1.17 (BIN_2); also elsewhere on the board
TVP_BIN3: U1.16 (BIN_3); also elsewhere on the board
TVP_DATACLK: R33.1, U1.28 (DATACLK)
TVP_EXTCLK: U1.80 (EXT_CLK), X1.3 (OUT)
TVP_FIDOUT: R36.1, U1.22 (FIDOUT)
TVP_FILT1: R6.1, U1.87 (FILT1)
TVP_FILT1R: C14.1, R6.2
TVP_FILT2: C15.1, U1.88 (FILT2)
TVP_G2: R17.1, U1.50 (G_2)
TVP_G3: R18.1, U1.49 (G_3)
TVP_G4: R19.1, U1.48 (G_4)
TVP_G5: R20.1, U1.47 (G_5)
TVP_G6: R21.1, U1.46 (G_6)
TVP_G7: R22.1, U1.45 (G_7)
TVP_G8: R23.1, U1.44 (G_8)
TVP_G9: R24.1, U1.43 (G_9)
TVP_GIN1: U1.2 (GIN_1); also elsewhere on the board
TVP_GIN2: U1.100 (GIN_2); also elsewhere on the board
TVP_GIN3: U1.98 (GIN_3); also elsewhere on the board
TVP_GIN4: U1.96 (GIN_4); also elsewhere on the board
TVP_HSOUT: R34.1, U1.24 (HSOUT)
TVP_PLLF: C14.2, C15.2, U1.89 (PLL_F)
TVP_PLLVDD: C23.1, C24.1, C25.1, FB3.2, U1.84 (PLL_AVDD), U1.85 (PLL_AVDD)
TVP_PWDN: R8.1, U1.70 (PWDN)
TVP_R2: R25.1, U1.63 (R_2)
TVP_R3: R26.1, U1.62 (R_3)
TVP_R4: R27.1, U1.61 (R_4)
TVP_R5: R28.1, U1.59 (R_5)
TVP_R6: R29.1, U1.58 (R_6)
TVP_R7: R30.1, U1.57 (R_7)
TVP_R8: R31.1, U1.56 (R_8)
TVP_R9: R32.1, U1.55 (R_9)
TVP_RESETn: R7.1, U1.71 (RESETB); also elsewhere on the board
TVP_RIN1: U1.11 (RIN_1); also elsewhere on the board
TVP_RIN2: U1.10 (RIN_2); also elsewhere on the board
TVP_RIN3: U1.9 (RIN_3); also elsewhere on the board
TVP_SOGIN1: U1.1 (SOGIN_1); also elsewhere on the board
TVP_SOGIN2: U1.99 (SOGIN_2); also elsewhere on the board
TVP_SOGIN3: U1.97 (SOGIN_3); also elsewhere on the board
TVP_SOGOUT: R37.1, U1.25 (SOGOUT)
TVP_VSOUT: R35.1, U1.23 (VSOUT)
VD_B2: R9.2; also elsewhere on the board
VD_B3: R10.2; also elsewhere on the board
VD_B4: R11.2; also elsewhere on the board
VD_B5: R12.2; also elsewhere on the board
VD_B6: R13.2; also elsewhere on the board
VD_B7: R14.2; also elsewhere on the board
VD_B8: R15.2; also elsewhere on the board
VD_B9: R16.2; also elsewhere on the board
VD_FID: R36.2; also elsewhere on the board
VD_G2: R17.2; also elsewhere on the board
VD_G3: R18.2; also elsewhere on the board
VD_G4: R19.2; also elsewhere on the board
VD_G5: R20.2; also elsewhere on the board
VD_G6: R21.2; also elsewhere on the board
VD_G7: R22.2; also elsewhere on the board
VD_G8: R23.2; also elsewhere on the board
VD_G9: R24.2; also elsewhere on the board
VD_HS: R34.2; also elsewhere on the board
VD_PCLK: R33.2; also elsewhere on the board
VD_R2: R25.2; also elsewhere on the board
VD_R3: R26.2; also elsewhere on the board
VD_R4: R27.2; also elsewhere on the board
VD_R5: R28.2; also elsewhere on the board
VD_R6: R29.2; also elsewhere on the board
VD_R7: R30.2; also elsewhere on the board
VD_R8: R31.2; also elsewhere on the board
VD_R9: R32.2; also elsewhere on the board
VD_SOG: R37.2; also elsewhere on the board
VD_VS: R35.2; also elsewhere on the board

Notes on the sheet:
TVP7002. Sync comes from SOGIN (composite or luma; the PS1 has no sync pin), so the digital HSYNC/VSYNC inputs are grounded as unused. I2C address B8h (I2CA low).
H-PLL loop filter (SLES206C Figure 4): 1.5k + 100n FILT1-PLL_F, 4.7n FILT2-PLL_F.
Control. RESETB is held low by 2.2k until the FX3 firmware releases it, so the TVP7002 stays in reset while the FX3 boots from the shared I2C bus (SLES206C: no I2C activity before reset completes). PWDN 2.2k to GND (Figure 8).
27 MHz reference on EXT_CLK for mode detection (SLES206C recommends 27 MHz; the internal reference is about 6.5 MHz and imprecise).
Output bus: 22R series at the source (FX3 AN70707 checklist item 9). Top 8 bits of each channel. 4:4:4 uses DQ[23:0]; 20-bit 4:2:2 uses DQ[15:0] (Y on G, CbCr on B).
Supply decoupling. SLES206C gives no values; this follows the OSSC: ferrites on AVDD and PLL_AVDD, 100n per pin, bulk per rail.

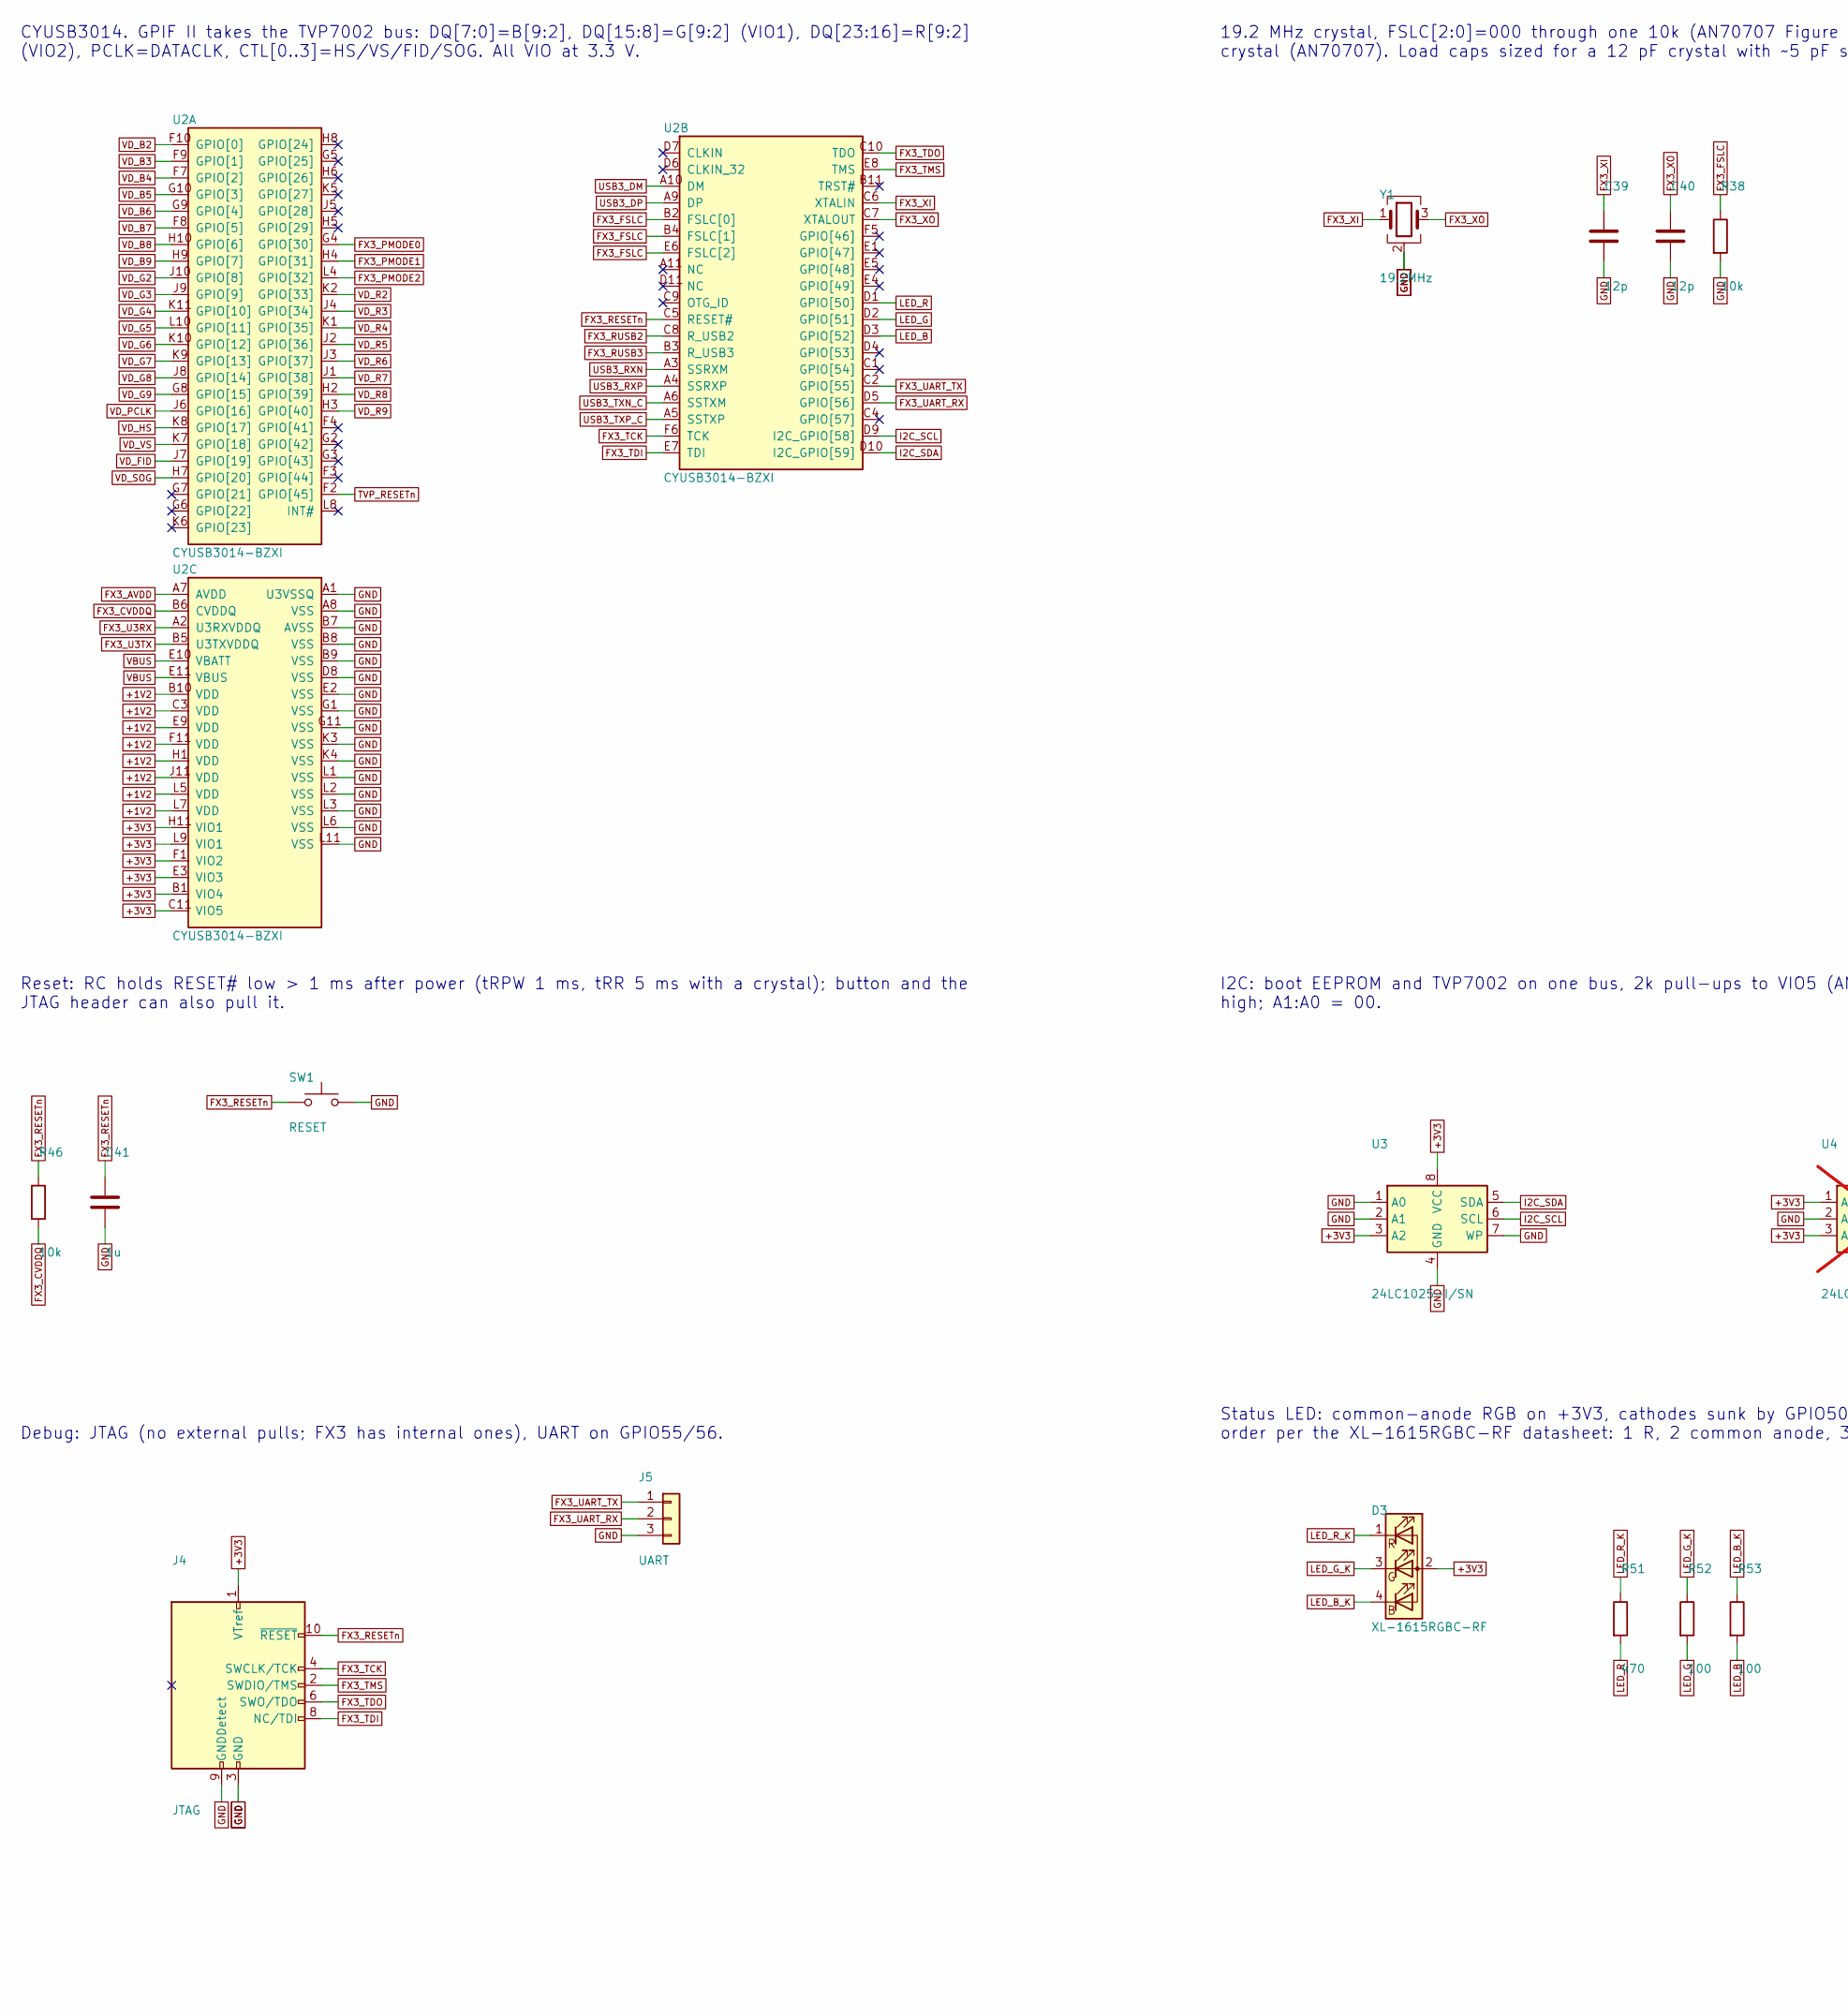
[picture p40: schematic fx3.kicad_sch, FX3 USB 3 bridge, part in row 1, column 1]

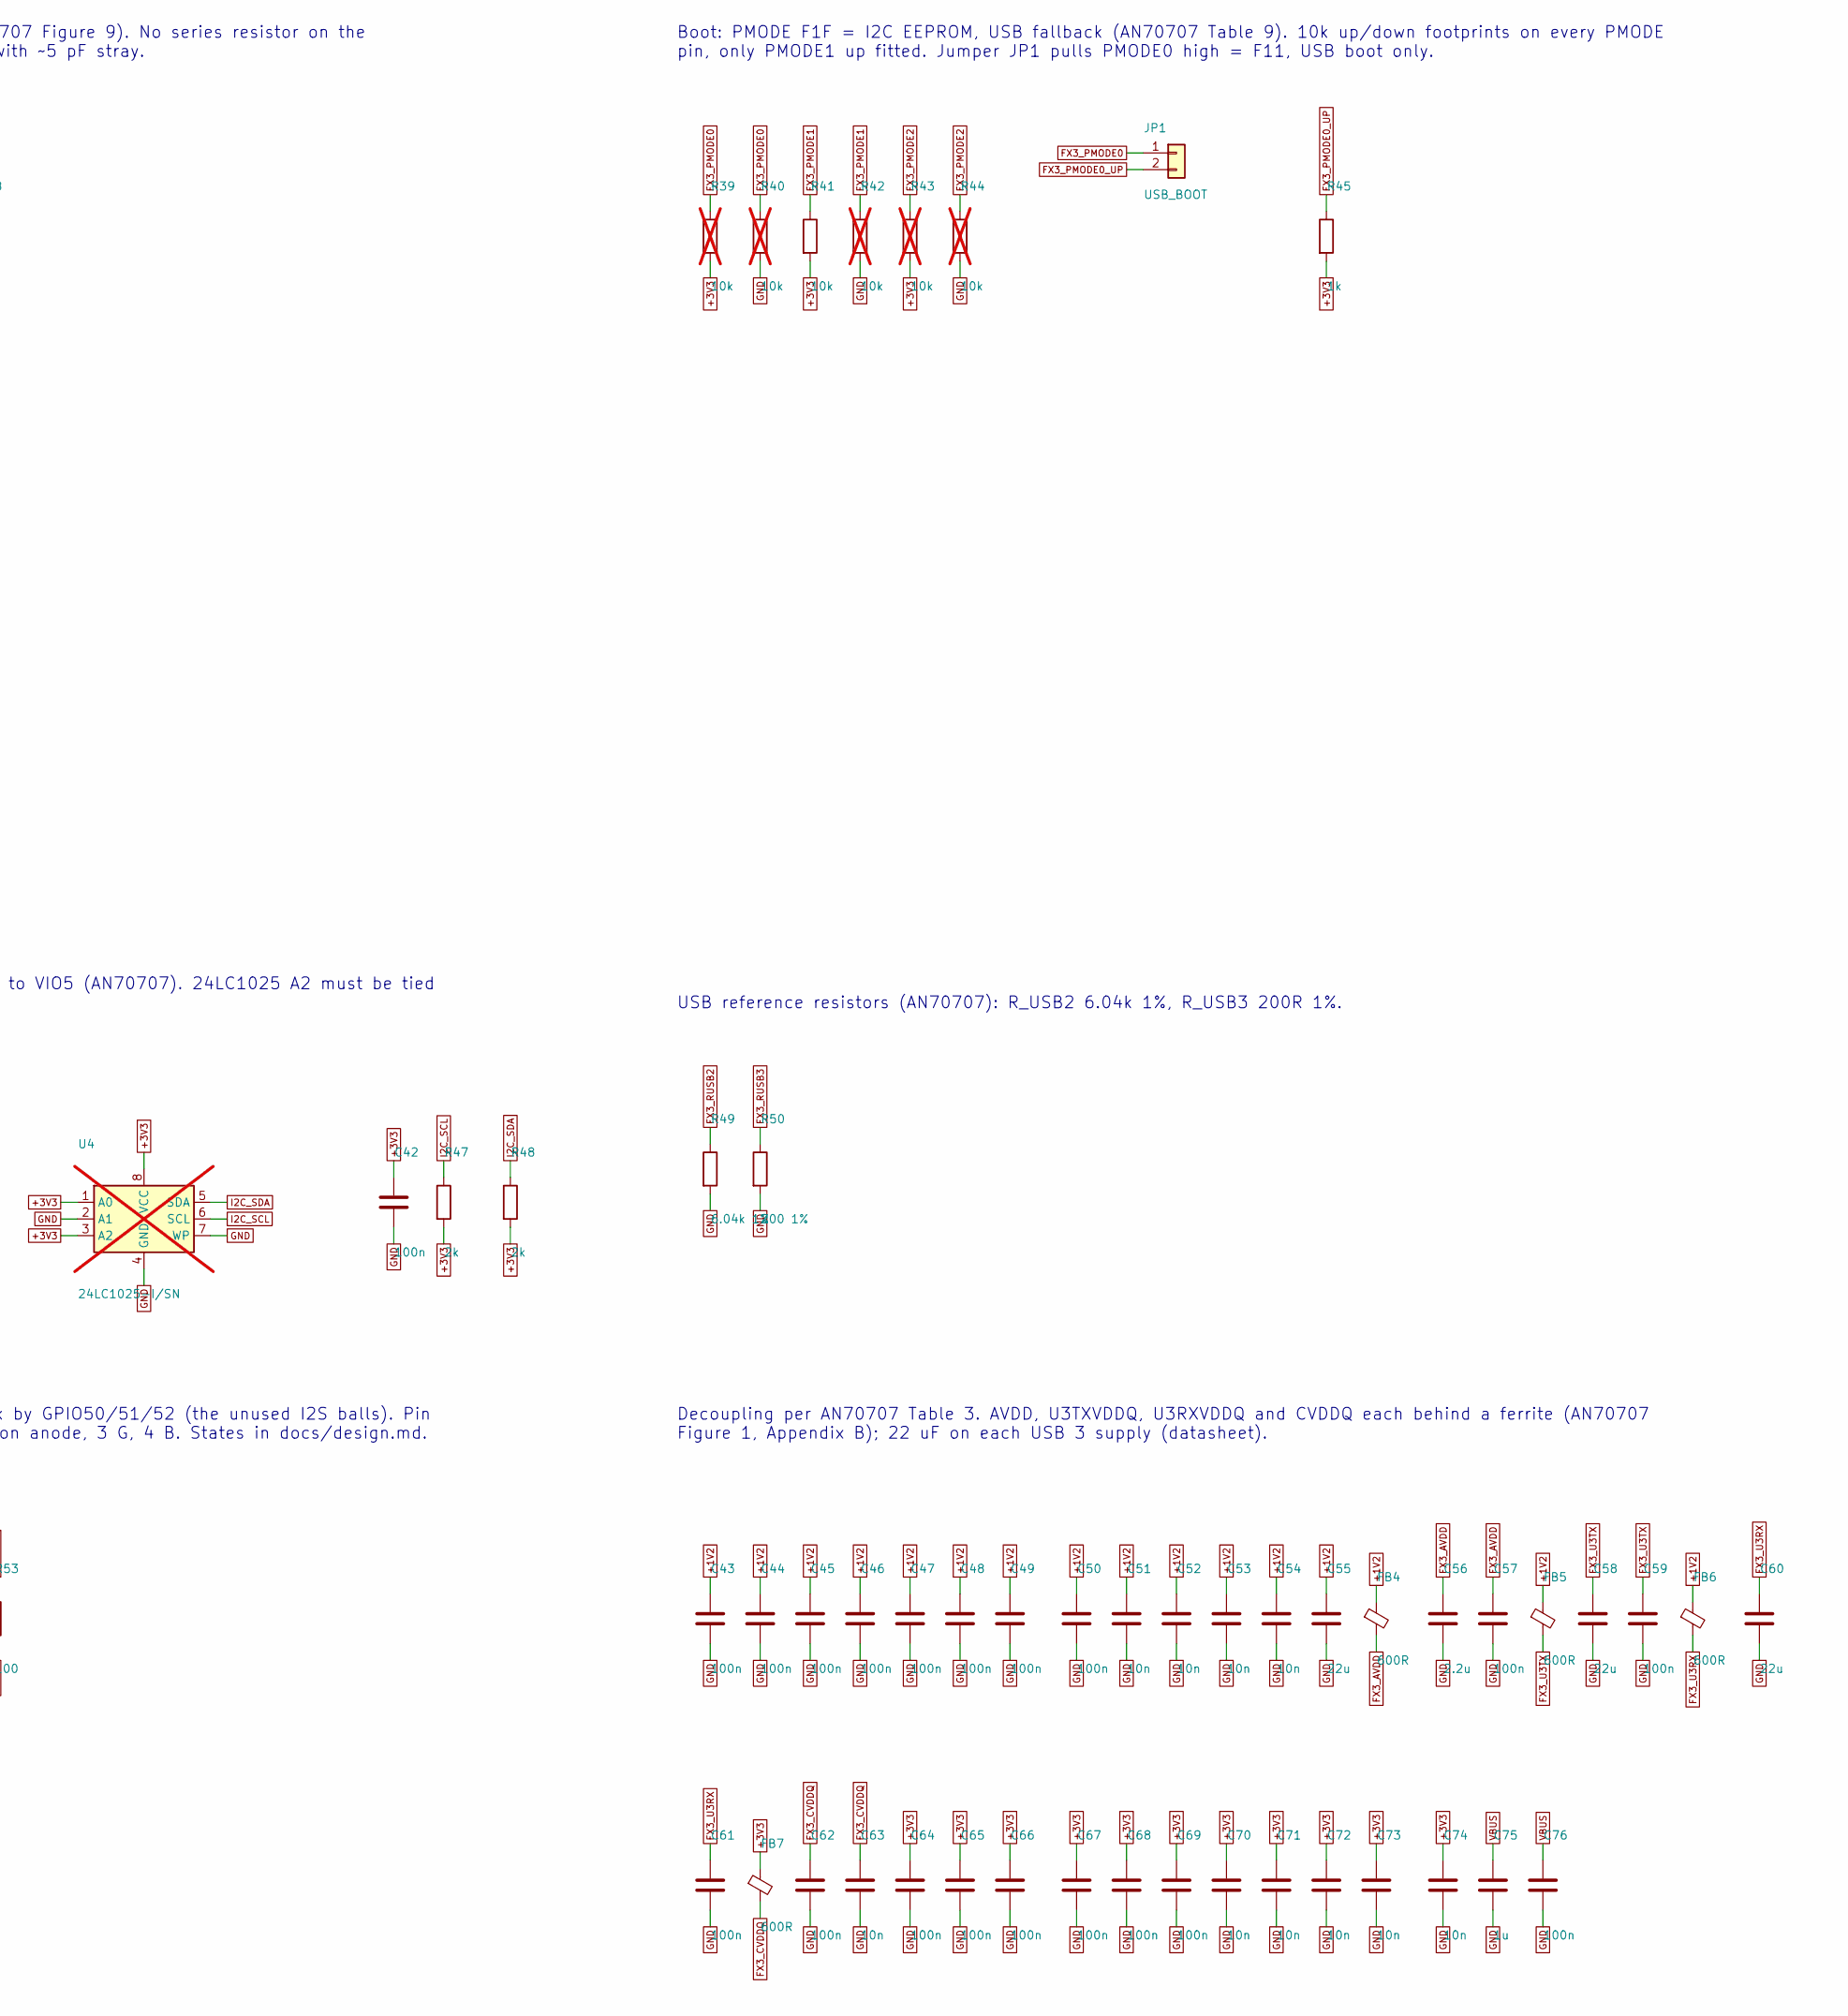
[picture p41: schematic fx3.kicad_sch, FX3 USB 3 bridge, part in row 1, column 2]

Parts:
C39, C40: 12p; C_0402_1005Metric; LCSC C1547
C41, C75: 1u; C_0402_1005Metric; LCSC C52923
C42, C43, C44, C45, C46, C47, C48, C49, C50, C57, C59, C61, C62, C64, C65, C66, C67, C68, C69, C76: 100n; C_0402_1005Metric; LCSC C1525
C51, C52, C53, C54, C63, C70, C71, C72, C73, C74: 10n; C_0402_1005Metric; LCSC C15195
C55, C58, C60: 22u; C_0805_2012Metric; LCSC C45783
C56: 2.2u; C_0603_1608Metric; LCSC C23630
D3: XL-1615RGBC-RF; LED-ARRAY-SMD_4P-L1.6-W1.5-BR_XL-1615RGBC-RF; LCSC C965840
FB4, FB5, FB6, FB7: 600R; L_0603_1608Metric; LCSC C108301
J4: JTAG; PinHeader_2x05_P1.27mm_Vertical_SMD
J5: UART; PinHeader_1x03_P2.54mm_Vertical
JP1: USB_BOOT; PinHeader_1x02_P2.54mm_Vertical
R38, R41, R46: 10k; R_0402_1005Metric; LCSC C25744
R39, R40, R42, R43, R44: 10k; R_0402_1005Metric; LCSC C25744; not fitted
R45: 1k; R_0402_1005Metric; LCSC C11702
R47, R48: 2k; R_0402_1005Metric; LCSC C4109
R49: 6.04k 1%; R_0402_1005Metric; LCSC C97819
R50: 200 1%; R_0402_1005Metric; LCSC C25087
R51: 470; R_0402_1005Metric; LCSC C25117
R52, R53: 100; R_0402_1005Metric; LCSC C25076
SW1: RESET; SW_SPST_TL3342; LCSC C318884
U2: CYUSB3014-BZXI; BGA-121_L10.0-W10.0-R11-C11-P0.80-TL; LCSC C57294
U3: 24LC1025-I/SN; SOIC-8_3.9x4.9mm_P1.27mm; LCSC C615697
U4: 24LC1025-I/SN; SOIC-8_3.9x4.9mm_P1.27mm; LCSC C615697; not fitted
Y1: 19.2MHz; Crystal_SMD_3225-4Pin_3.2x2.5mm; LCSC C411225

Connections:
+1V2: C43.1, C44.1, C45.1, C46.1, C47.1, C48.1, C49.1, C50.1, C51.1, C52.1, C53.1, C54.1, C55.1, FB4.1, FB5.1, FB6.1, U2.B10 (VDD), U2.C3 (VDD), U2.E9 (VDD), U2.F11 (VDD), U2.H1 (VDD), U2.J11 (VDD), U2.L5 (VDD), U2.L7 (VDD); also elsewhere on the board
+3V3: C42.1, C64.1, C65.1, C66.1, C67.1, C68.1, C69.1, C70.1, C71.1, C72.1, C73.1, C74.1, D3.2 (A), FB7.1, J4.1 (VTref), R39.2, R41.2, R43.2, R45.2, R47.2, R48.2, U2.B1 (VIO4), U2.C11 (VIO5), U2.E3 (VIO3), U2.F1 (VIO2), U2.H11 (VIO1), U2.L9 (VIO1), U3.3 (A2), U3.8 (VCC), U4.1 (A0), U4.3 (A2), U4.8 (VCC); also elsewhere on the board
FX3_AVDD: C56.1, C57.1, FB4.2, U2.A7 (AVDD)
FX3_CVDDQ: C62.1, C63.1, FB7.2, R46.2, U2.B6 (CVDDQ)
FX3_FSLC: R38.1, U2.B2 (FSLC[0]), U2.B4 (FSLC[1]), U2.E6 (FSLC[2])
FX3_PMODE0: JP1.1, R39.1, R40.1, U2.G4 (GPIO[30])
FX3_PMODE0_UP: JP1.2, R45.1
FX3_PMODE1: R41.1, R42.1, U2.H4 (GPIO[31])
FX3_PMODE2: R43.1, R44.1, U2.L4 (GPIO[32])
FX3_RESETn: C41.1, J4.10 (~RESET), R46.1, SW1.1, U2.C5 (RESET#)
FX3_RUSB2: R49.1, U2.C8 (R_USB2)
FX3_RUSB3: R50.1, U2.B3 (R_USB3)
FX3_TCK: J4.4 (SWCLK/TCK), U2.F6 (TCK)
FX3_TDI: J4.8 (NC/TDI), U2.E7 (TDI)
FX3_TDO: J4.6 (SWO/TDO), U2.C10 (TDO)
FX3_TMS: J4.2 (SWDIO/TMS), U2.E8 (TMS)
FX3_U3RX: C60.1, C61.1, FB6.2, U2.A2 (U3RXVDDQ)
FX3_U3TX: C58.1, C59.1, FB5.2, U2.B5 (U3TXVDDQ)
FX3_UART_RX: J5.2, U2.D5 (GPIO[56])
FX3_UART_TX: J5.1, U2.C2 (GPIO[55])
FX3_XI: C39.1, U2.C6 (XTALIN), Y1.1
FX3_XO: C40.1, U2.C7 (XTALOUT), Y1.3
GND: C39.2, C40.2, C41.2, C42.2, C43.2, C44.2, C45.2, C46.2, C47.2, C48.2, C49.2, C50.2, C51.2, C52.2, C53.2, C54.2, C55.2, C56.2, C57.2, C58.2, C59.2, C60.2, C61.2, C62.2, C63.2, C64.2, C65.2, C66.2, C67.2, C68.2, C69.2, C70.2, C71.2, C72.2, C73.2, C74.2, C75.2, C76.2, J4.3 (GND), J4.5 (GND), J4.9 (GNDDetect), J5.3, R38.2, R40.2, R42.2, R44.2, R49.2, R50.2, SW1.2, U2.A1 (U3VSSQ), U2.A8 (VSS), U2.B7 (AVSS), U2.B8 (VSS), U2.B9 (VSS), U2.D8 (VSS), U2.E2 (VSS), U2.G1 (VSS), U2.G11 (VSS), U2.K3 (VSS), U2.K4 (VSS), U2.L1 (VSS), U2.L2 (VSS), U2.L3 (VSS), U2.L6 (VSS), U2.L11 (VSS), U3.1 (A0), U3.2 (A1), U3.4 (GND), U3.7 (WP), U4.2 (A1), U4.4 (GND), U4.7 (WP), Y1.2 (G), Y1.4 (G); also elsewhere on the board
I2C_SCL: R47.1, U2.D9 (I2C_GPIO[58]), U3.6 (SCL), U4.6 (SCL); also elsewhere on the board
I2C_SDA: R48.1, U2.D10 (I2C_GPIO[59]), U3.5 (SDA), U4.5 (SDA); also elsewhere on the board
LED_B: R53.2, U2.D3 (GPIO[52])
LED_B_K: D3.4 (BK), R53.1
LED_G: R52.2, U2.D2 (GPIO[51])
LED_G_K: D3.3 (GK), R52.1
LED_R: R51.2, U2.D1 (GPIO[50])
LED_R_K: D3.1 (RK), R51.1
TVP_RESETn: U2.F2 (GPIO[45]); also elsewhere on the board
USB3_DM: U2.A10 (DM); also elsewhere on the board
USB3_DP: U2.A9 (DP); also elsewhere on the board
USB3_RXN: U2.A3 (SSRXM); also elsewhere on the board
USB3_RXP: U2.A4 (SSRXP); also elsewhere on the board
USB3_TXN_C: U2.A6 (SSTXM); also elsewhere on the board
USB3_TXP_C: U2.A5 (SSTXP); also elsewhere on the board
VBUS: C75.1, C76.1, U2.E10 (VBATT), U2.E11 (VBUS); also elsewhere on the board
VD_B2: U2.F10 (GPIO[0]); also elsewhere on the board
VD_B3: U2.F9 (GPIO[1]); also elsewhere on the board
VD_B4: U2.F7 (GPIO[2]); also elsewhere on the board
VD_B5: U2.G10 (GPIO[3]); also elsewhere on the board
VD_B6: U2.G9 (GPIO[4]); also elsewhere on the board
VD_B7: U2.F8 (GPIO[5]); also elsewhere on the board
VD_B8: U2.H10 (GPIO[6]); also elsewhere on the board
VD_B9: U2.H9 (GPIO[7]); also elsewhere on the board
VD_FID: U2.J7 (GPIO[19]); also elsewhere on the board
VD_G2: U2.J10 (GPIO[8]); also elsewhere on the board
VD_G3: U2.J9 (GPIO[9]); also elsewhere on the board
VD_G4: U2.K11 (GPIO[10]); also elsewhere on the board
VD_G5: U2.L10 (GPIO[11]); also elsewhere on the board
VD_G6: U2.K10 (GPIO[12]); also elsewhere on the board
VD_G7: U2.K9 (GPIO[13]); also elsewhere on the board
VD_G8: U2.J8 (GPIO[14]); also elsewhere on the board
VD_G9: U2.G8 (GPIO[15]); also elsewhere on the board
VD_HS: U2.K8 (GPIO[17]); also elsewhere on the board
VD_PCLK: U2.J6 (GPIO[16]); also elsewhere on the board
VD_R2: U2.K2 (GPIO[33]); also elsewhere on the board
VD_R3: U2.J4 (GPIO[34]); also elsewhere on the board
VD_R4: U2.K1 (GPIO[35]); also elsewhere on the board
VD_R5: U2.J2 (GPIO[36]); also elsewhere on the board
VD_R6: U2.J3 (GPIO[37]); also elsewhere on the board
VD_R7: U2.J1 (GPIO[38]); also elsewhere on the board
VD_R8: U2.H2 (GPIO[39]); also elsewhere on the board
VD_R9: U2.H3 (GPIO[40]); also elsewhere on the board
VD_SOG: U2.H7 (GPIO[20]); also elsewhere on the board
VD_VS: U2.K7 (GPIO[18]); also elsewhere on the board

Notes on the sheet:
CYUSB3014. GPIF II takes the TVP7002 bus: DQ[7:0]=B[9:2], DQ[15:8]=G[9:2] (VIO1), DQ[23:16]=R[9:2] (VIO2), PCLK=DATACLK, CTL[0..3]=HS/VS/FID/SOG. All VIO at 3.3 V.
19.2 MHz crystal, FSLC[2:0]=000 through one 10k (AN70707 Figure 9). No series resistor on the crystal (AN70707). Load caps sized for a 12 pF crystal with ~5 pF stray.
Boot: PMODE F1F = I2C EEPROM, USB fallback (AN70707 Table 9). 10k up/down footprints on every PMODE pin, only PMODE1 up fitted. Jumper JP1 pulls PMODE0 high = F11, USB boot only.
Reset: RC holds RESET# low > 1 ms after power (tRPW 1 ms, tRR 5 ms with a crystal); button and the JTAG header can also pull it.
I2C: boot EEPROM and TVP7002 on one bus, 2k pull-ups to VIO5 (AN70707). 24LC1025 A2 must be tied high; A1:A0 = 00.
USB reference resistors (AN70707): R_USB2 6.04k 1%, R_USB3 200R 1%.
Debug: JTAG (no external pulls; FX3 has internal ones), UART on GPIO55/56.
Status LED: common-anode RGB on +3V3, cathodes sunk by GPIO50/51/52 (the unused I2S balls). Pin order per the XL-1615RGBC-RF datasheet: 1 R, 2 common anode, 3 G, 4 B. States in docs/design.md.
Decoupling per AN70707 Table 3. AVDD, U3TXVDDQ, U3RXVDDQ and CVDDQ each behind a ferrite (AN70707 Figure 1, Appendix B); 22 uF on each USB 3 supply (datasheet).
