rixnobis/ps1-av-capture/ps1-av-capture.kicad_pcb

## KiCad design ps1-av-capture.kicad_pcb (continued)

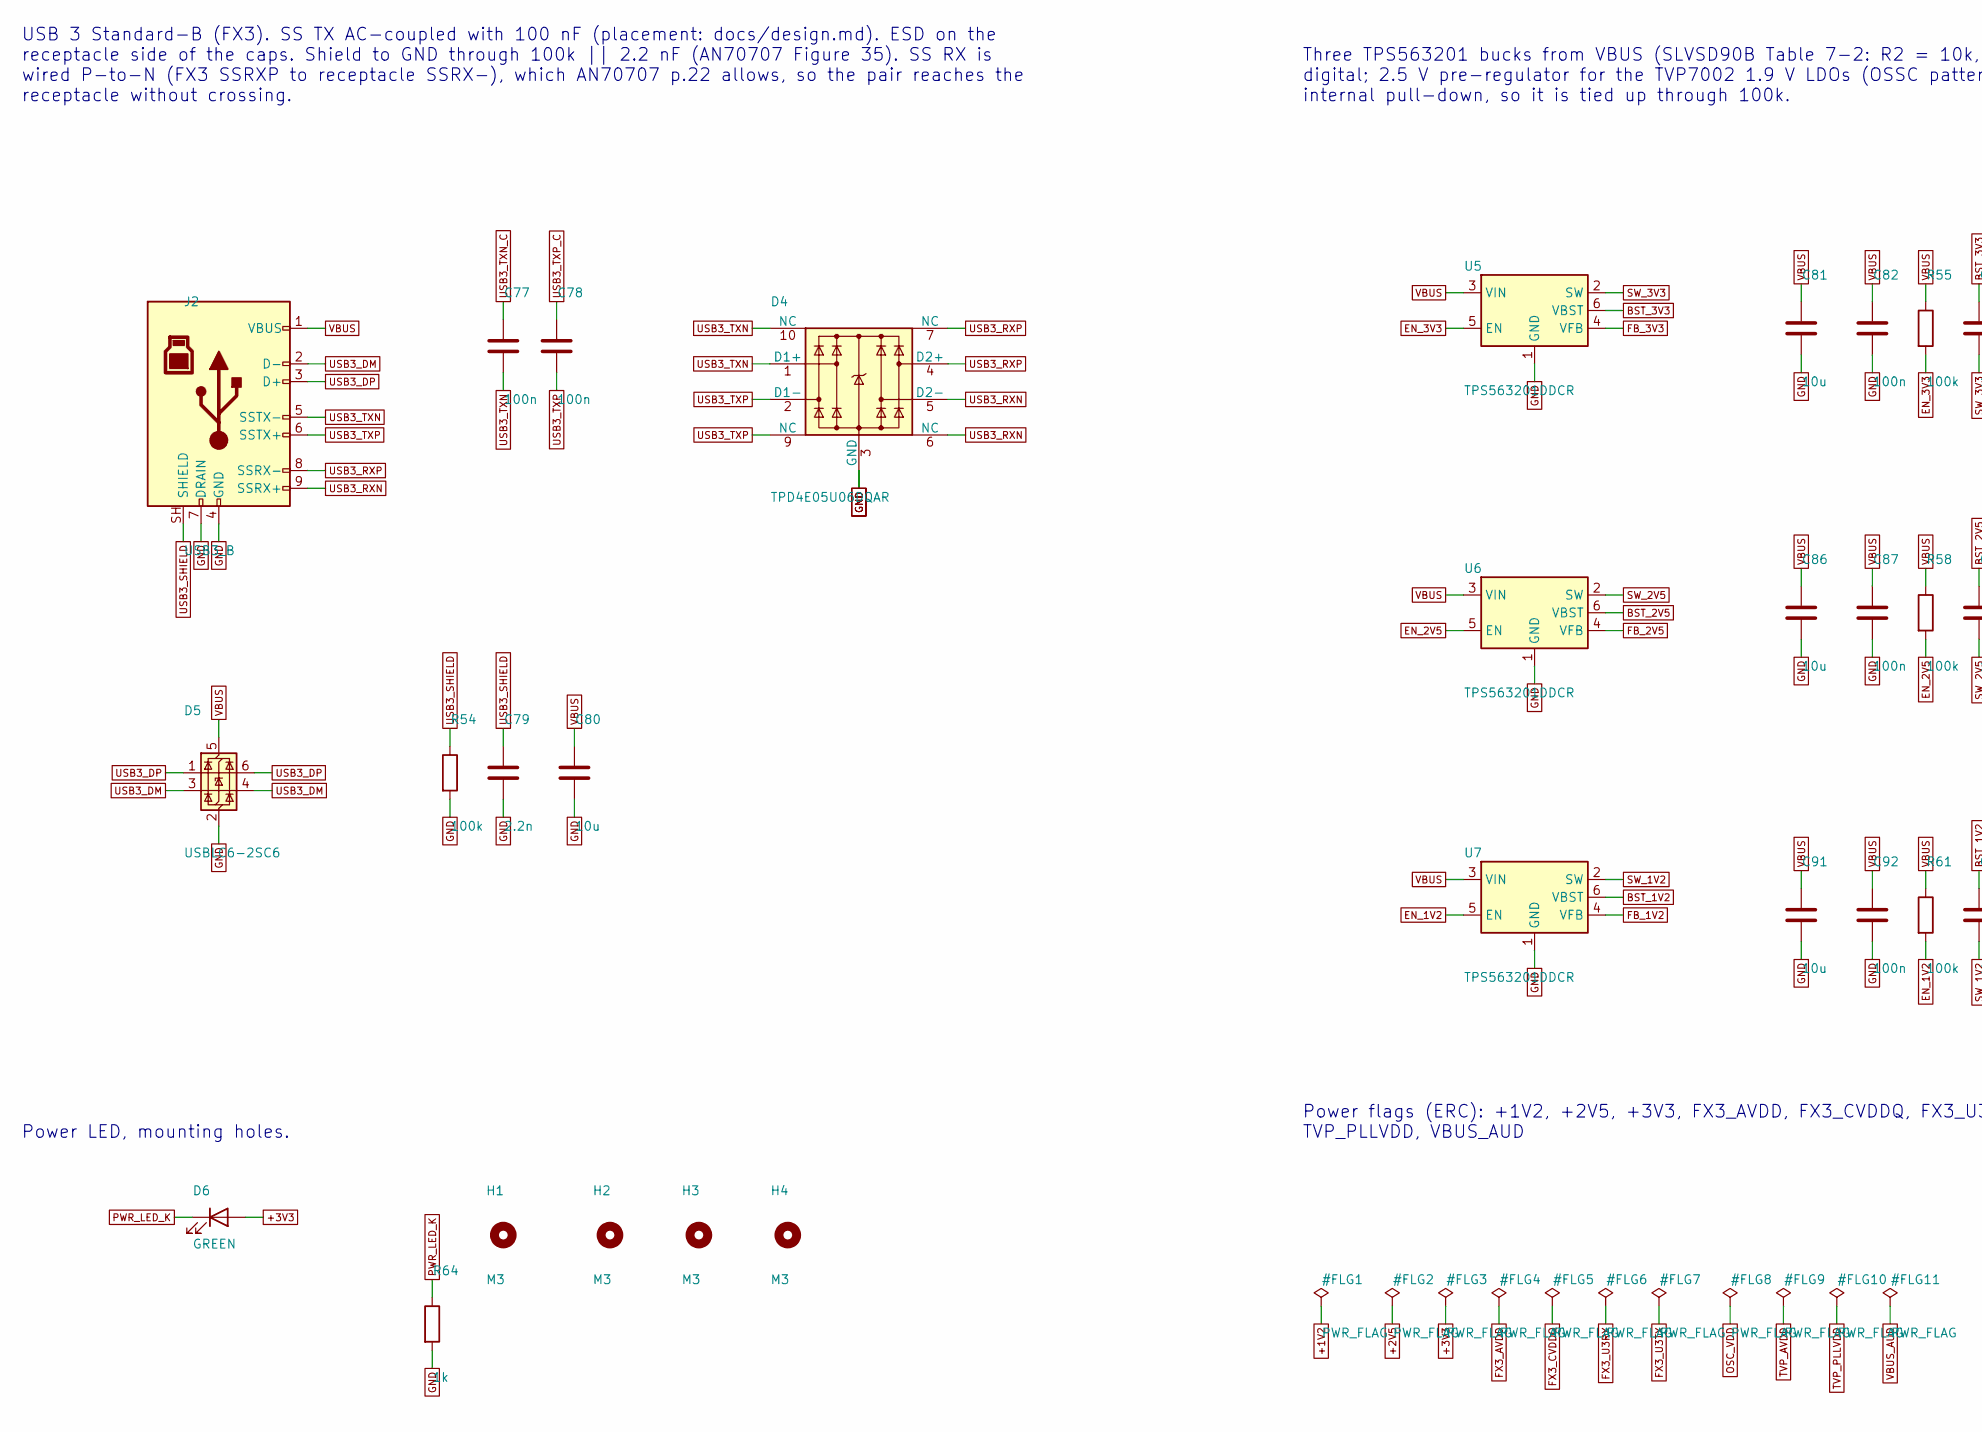
[picture p42: schematic power.kicad_sch, USB 3 connector and power, part in row 1, column 1]

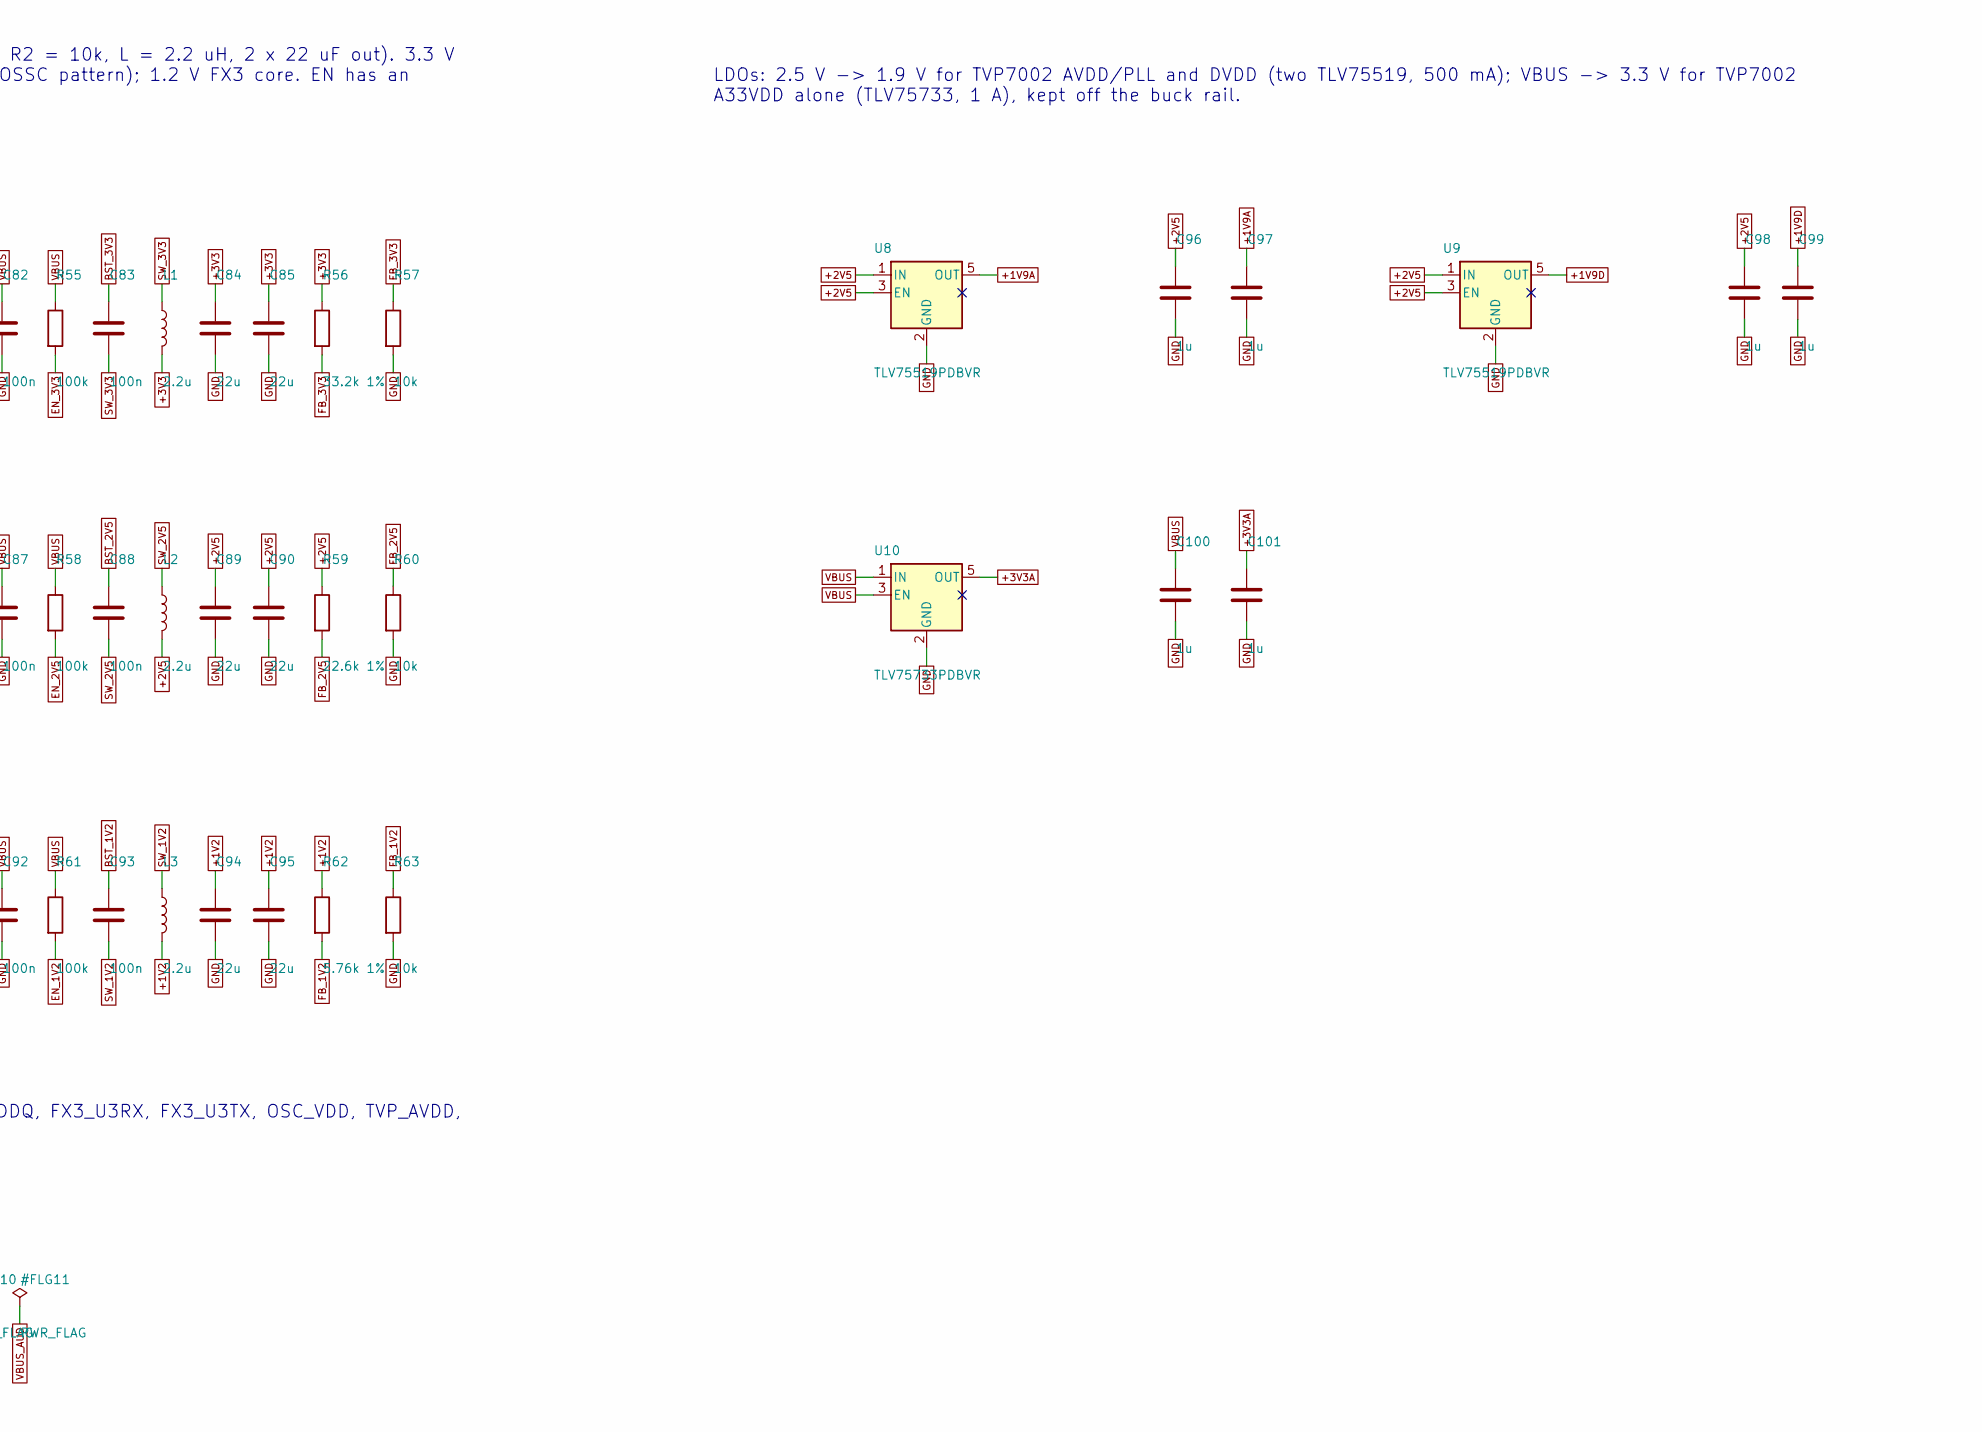
[picture p43: schematic power.kicad_sch, USB 3 connector and power, part in row 1, column 2]

Parts:
C77, C78, C82, C83, C87, C88, C92, C93: 100n; C_0402_1005Metric; LCSC C1525
C79: 2.2n; C_0402_1005Metric; LCSC C1531
C80, C81, C86, C91: 10u; C_0603_1608Metric; LCSC C19702
C84, C85, C89, C90, C94, C95: 22u; C_0805_2012Metric; LCSC C45783
C96, C97, C98, C99, C100, C101: 1u; C_0402_1005Metric; LCSC C52923
D4: TPD4E05U06DQAR; USON-10_2.5x1.0mm_P0.5mm; LCSC C138714
D5: USBLC6-2SC6; SOT-23-6; LCSC C7519
D6: GREEN; LED_0603_1608Metric; LCSC C2986059
H1, H2, H3, H4: M3; MountingHole_3.2mm_M3
J2: USB3_B; USB-B-TH_9P-L18.5-W12.0; LCSC C7501849
L1, L2, L3: 2.2u; L_Sunlord_SWPA4030S; LCSC C36409
R54, R55, R58, R61: 100k; R_0402_1005Metric; LCSC C25741
R56: 33.2k 1%; R_0402_1005Metric; LCSC C122548
R57, R60, R63: 10k; R_0402_1005Metric; LCSC C25744
R59: 22.6k 1%; R_0402_1005Metric; LCSC C26960
R62: 5.76k 1%; R_0402_1005Metric; LCSC C5153969
R64: 1k; R_0402_1005Metric; LCSC C11702
U5, U6, U7: TPS563201DDCR; SOT-23-6_L2.9-W1.6-P0.95-LS2.8-BR; LCSC C116592
U8, U9: TLV75519PDBVR; SOT-23-5; LCSC C2865381
U10: TLV75733PDBVR; SOT-23-5; LCSC C485517

Connections:
+1V2: C94.1, C95.1, L3.2, R62.1; also elsewhere on the board
+1V9A: C97.1, U8.5 (OUT); also elsewhere on the board
+1V9D: C99.1, U9.5 (OUT); also elsewhere on the board
+2V5: C89.1, C90.1, C96.1, C98.1, L2.2, R59.1, U8.1 (IN), U8.3 (EN), U9.1 (IN), U9.3 (EN)
+3V3: C84.1, C85.1, D6.2 (A), L1.2, R56.1; also elsewhere on the board
+3V3A: C101.1, U10.5 (OUT); also elsewhere on the board
BST_1V2: C93.1, U7.6 (VBST)
BST_2V5: C88.1, U6.6 (VBST)
BST_3V3: C83.1, U5.6 (VBST)
EN_1V2: R61.2, U7.5 (EN)
EN_2V5: R58.2, U6.5 (EN)
EN_3V3: R55.2, U5.5 (EN)
FB_1V2: R62.2, R63.1, U7.4 (VFB)
FB_2V5: R59.2, R60.1, U6.4 (VFB)
FB_3V3: R56.2, R57.1, U5.4 (VFB)
GND: C79.2, C80.2, C81.2, C82.2, C84.2, C85.2, C86.2, C87.2, C89.2, C90.2, C91.2, C92.2, C94.2, C95.2, C96.2, C97.2, C98.2, C99.2, C100.2, C101.2, D4.3 (GND), D4.8 (GND), D5.2 (GND), J2.4 (GND), J2.7 (DRAIN), R54.2, R57.2, R60.2, R63.2, R64.2, U5.1 (GND), U6.1 (GND), U7.1 (GND), U8.2 (GND), U9.2 (GND), U10.2 (GND); also elsewhere on the board
PWR_LED_K: D6.1 (K), R64.1
SW_1V2: C93.2, L3.1, U7.2 (SW)
SW_2V5: C88.2, L2.1, U6.2 (SW)
SW_3V3: C83.2, L1.1, U5.2 (SW)
USB3_DM: D5.3 (I/O2), D5.4 (I/O2), J2.2 (D-); also elsewhere on the board
USB3_DP: D5.1 (I/O1), D5.6 (I/O1), J2.3 (D+); also elsewhere on the board
USB3_RXN: D4.5 (D2-), D4.6 (NC), J2.9 (SSRX+); also elsewhere on the board
USB3_RXP: D4.4 (D2+), D4.7 (NC), J2.8 (SSRX-); also elsewhere on the board
USB3_SHIELD: C79.1, J2.SH (SHIELD), R54.1
USB3_TXN: C77.2, D4.1 (D1+), D4.10 (NC), J2.5 (SSTX-)
USB3_TXN_C: C77.1; also elsewhere on the board
USB3_TXP: C78.2, D4.2 (D1-), D4.9 (NC), J2.6 (SSTX+)
USB3_TXP_C: C78.1; also elsewhere on the board
VBUS: C80.1, C81.1, C82.1, C86.1, C87.1, C91.1, C92.1, C100.1, D5.5 (VBUS), J2.1 (VBUS), R55.1, R58.1, R61.1, U5.3 (VIN), U6.3 (VIN), U7.3 (VIN), U10.1 (IN), U10.3 (EN); also elsewhere on the board

Notes on the sheet:
USB 3 Standard-B (FX3). SS TX AC-coupled with 100 nF (placement: docs/design.md). ESD on the receptacle side of the caps. Shield to GND through 100k || 2.2 nF (AN70707 Figure 35). SS RX is wired P-to-N (FX3 SSRXP to receptacle SSRX-), which AN70707 p.22 allows, so the pair reaches the receptacle wi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
Three TPS563201 bucks from VBUS (SLVSD90B Table 7-2: R2 = 10k, L = 2.2 uH, 2 x 22 uF out). 3.3 V digital; 2.5 V pre-regulator for the TVP7002 1.9 V LDOs (OSSC pattern); 1.2 V FX3 core. EN has an internal pull-down, so it is tied up through 100k.
LDOs: 2.5 V -> 1.9 V for TVP7002 AVDD/PLL and DVDD (two TLV75519, 500 mA); VBUS -> 3.3 V for TVP7002 A33VDD alone (TLV75733, 1 A), kept off the buck rail.
Power LED, mounting holes.
Power flags (ERC): +1V2, +2V5, +3V3, FX3_AVDD, FX3_CVDDQ, FX3_U3RX, FX3_U3TX, OSC_VDD, TVP_AVDD, TVP_PLLVDD, VBUS_AUD

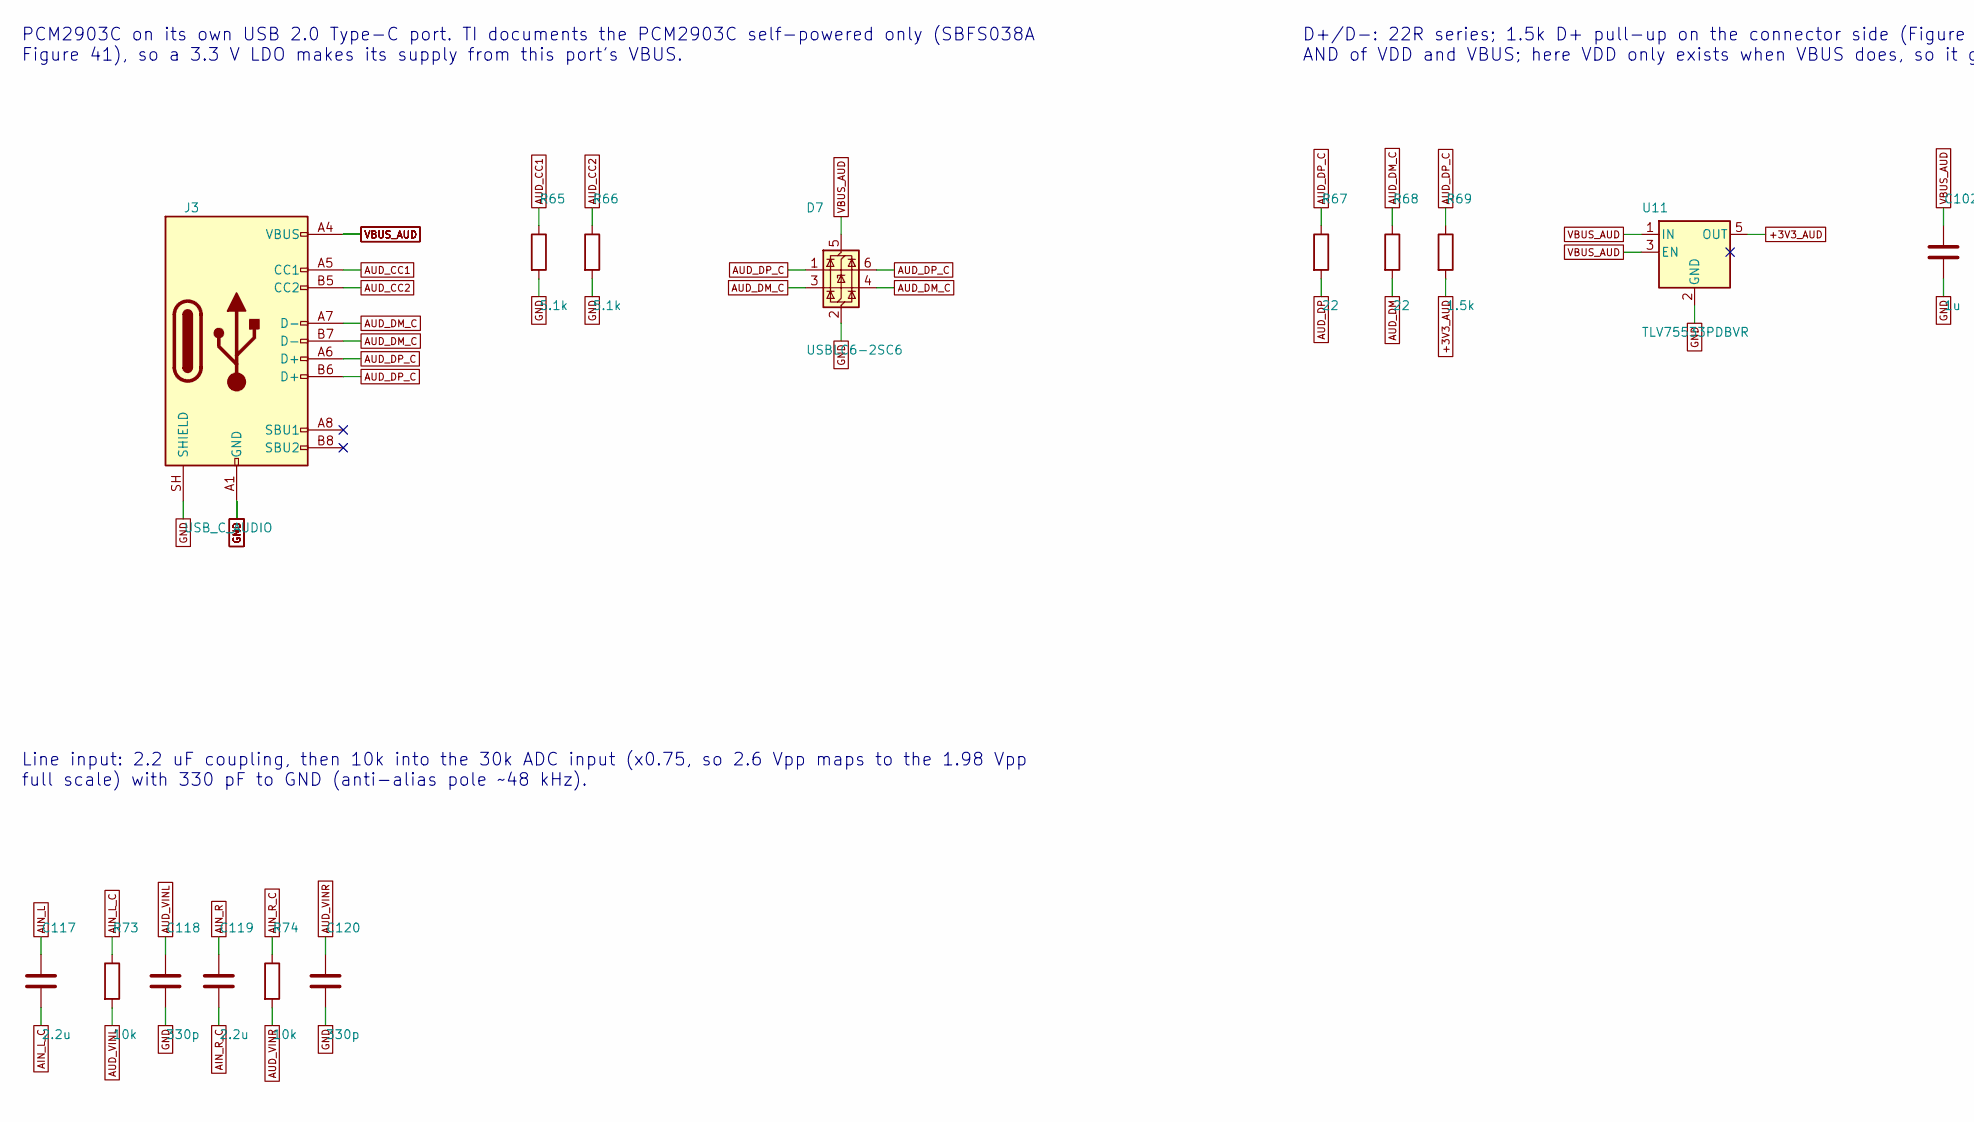
[picture p44: schematic audio.kicad_sch, PCM2903C USB audio, part in row 1, column 1]

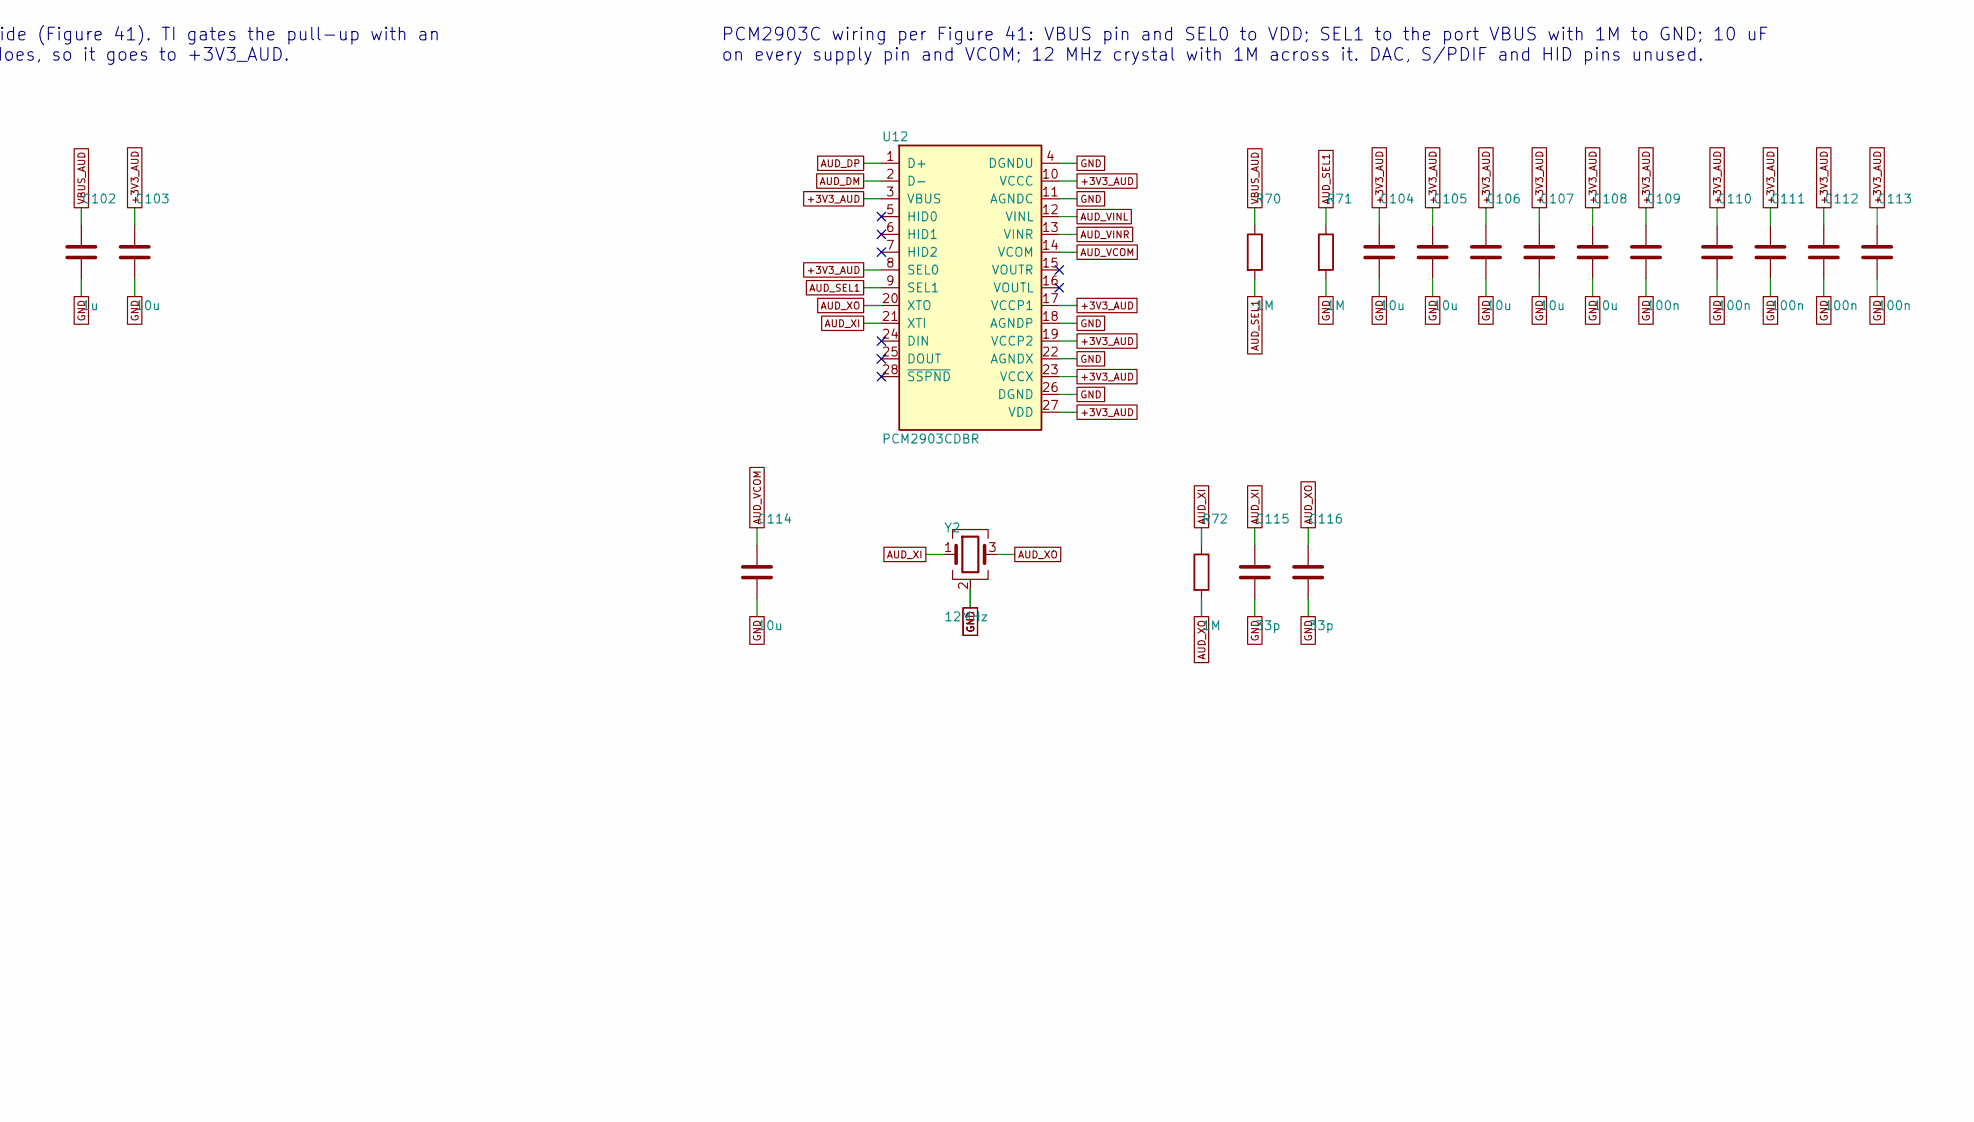
[picture p45: schematic audio.kicad_sch, PCM2903C USB audio, part in row 1, column 2]

Parts:
C102: 1u; C_0402_1005Metric; LCSC C52923
C103, C104, C105, C106, C107, C108, C114: 10u; C_0603_1608Metric; LCSC C19702
C109, C110, C111, C112, C113: 100n; C_0402_1005Metric; LCSC C1525
C115, C116: 33p; C_0402_1005Metric; LCSC C1562
C117, C119: 2.2u; C_0603_1608Metric; LCSC C23630
C118, C120: 330p; C_0402_1005Metric; LCSC C13533
D7: USBLC6-2SC6; SOT-23-6; LCSC C7519
J3: USB_C_AUDIO; USB_C_Receptacle_HRO_TYPE-C-31-M-12; LCSC C165948
R65, R66: 5.1k; R_0402_1005Metric; LCSC C25905
R67, R68: 22; R_0402_1005Metric; LCSC C25092
R69: 1.5k; R_0402_1005Metric; LCSC C25867
R70, R71, R72: 1M; R_0402_1005Metric; LCSC C26083
R73, R74: 10k; R_0402_1005Metric; LCSC C25744
U11: TLV75533PDBVR; SOT-23-5; LCSC C404027
U12: PCM2903CDBR; SSOP-28_5.3x10.2mm_P0.65mm; LCSC C2861593
Y2: 12MHz; Crystal_SMD_3225-4Pin_3.2x2.5mm; LCSC C9002

Connections:
+3V3_AUD: C103.1, C104.1, C105.1, C106.1, C107.1, C108.1, C109.1, C110.1, C111.1, C112.1, C113.1, R69.2, U11.5 (OUT), U12.3 (VBUS), U12.8 (SEL0), U12.10 (VCCC), U12.17 (VCCP1), U12.19 (VCCP2), U12.23 (VCCX), U12.27 (VDD)
AIN_L: C117.1; also elsewhere on the board
AIN_L_C: C117.2, R73.1; also elsewhere on the board
AIN_R: C119.1; also elsewhere on the board
AIN_R_C: C119.2, R74.1; also elsewhere on the board
AUD_CC1: J3.A5 (CC1), R65.1
AUD_CC2: J3.B5 (CC2), R66.1
AUD_DM: R68.2, U12.2 (D-)
AUD_DM_C: D7.3 (I/O2), D7.4 (I/O2), J3.A7 (D-), J3.B7 (D-), R68.1
AUD_DP: R67.2, U12.1 (D+)
AUD_DP_C: D7.1 (I/O1), D7.6 (I/O1), J3.A6 (D+), J3.B6 (D+), R67.1, R69.1
AUD_SEL1: R70.2, R71.1, U12.9 (SEL1)
AUD_VCOM: C114.1, U12.14 (VCOM)
AUD_VINL: C118.1, R73.2, U12.12 (VINL)
AUD_VINR: C120.1, R74.2, U12.13 (VINR)
AUD_XI: C115.1, R72.1, U12.21 (XTI), Y2.1
AUD_XO: C116.1, R72.2, U12.20 (XTO), Y2.3
GND: C102.2, C103.2, C104.2, C105.2, C106.2, C107.2, C108.2, C109.2, C110.2, C111.2, C112.2, C113.2, C114.2, C115.2, C116.2, C118.2, C120.2, D7.2 (GND), J3.A1 (GND), J3.A12 (GND), J3.B1 (GND), J3.B12 (GND), J3.SH (SHIELD), R65.2, R66.2, R71.2, U11.2 (GND), U12.4 (DGNDU), U12.11 (AGNDC), U12.18 (AGNDP), U12.22 (AGNDX), U12.26 (DGND), Y2.2 (G), Y2.4 (G); also elsewhere on the board
VBUS_AUD: C102.1, D7.5 (VBUS), J3.A4 (VBUS), J3.A9 (VBUS), J3.B4 (VBUS), J3.B9 (VBUS), R70.1, U11.1 (IN), U11.3 (EN)

Notes on the sheet:
PCM2903C on its own USB 2.0 Type-C port. TI documents the PCM2903C self-powered only (SBFS038A Figure 41), so a 3.3 V LDO makes its supply from this port's VBUS.
D+/D-: 22R series; 1.5k D+ pull-up on the connector side (Figure 41). TI gates the pull-up with an AND of VDD and VBUS; here VDD only exists when VBUS does, so it goes to +3V3_AUD.
PCM2903C wiring per Figure 41: VBUS pin and SEL0 to VDD; SEL1 to the port VBUS with 1M to GND; 10 uF on every supply pin and VCOM; 12 MHz crystal with 1M across it. DAC, S/PDIF and HID pins unused.
Line input: 2.2 uF coupling, then 10k into the 30k ADC input (x0.75, so 2.6 Vpp maps to the 1.98 Vpp full scale) with 330 pF to GND (anti-alias pole ~48 kHz).

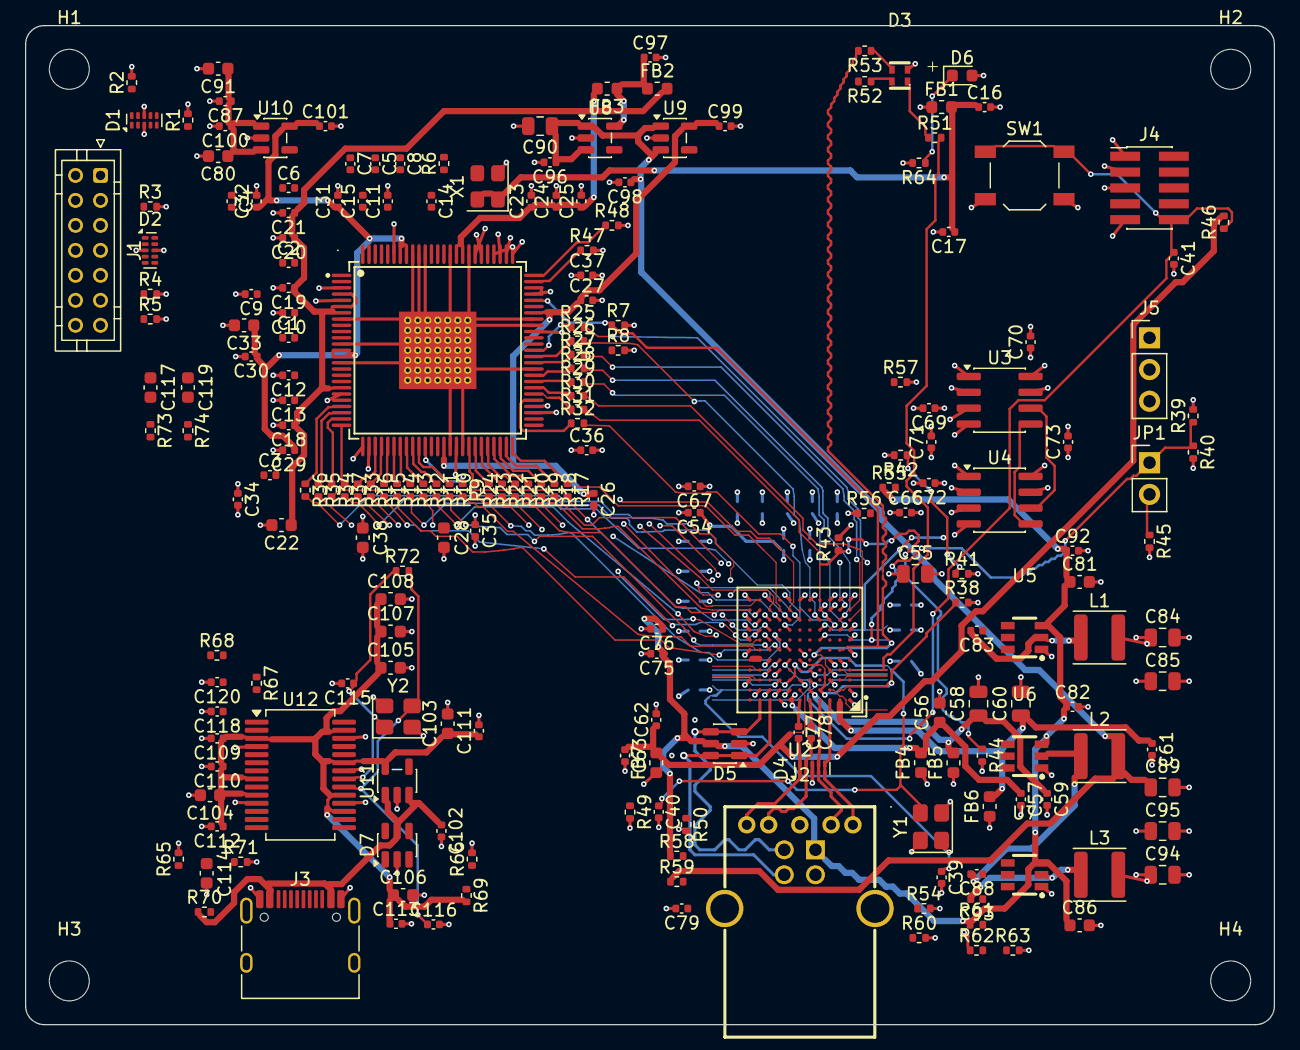
[picture p46: board ps1-av-capture.kicad_pcb from above]

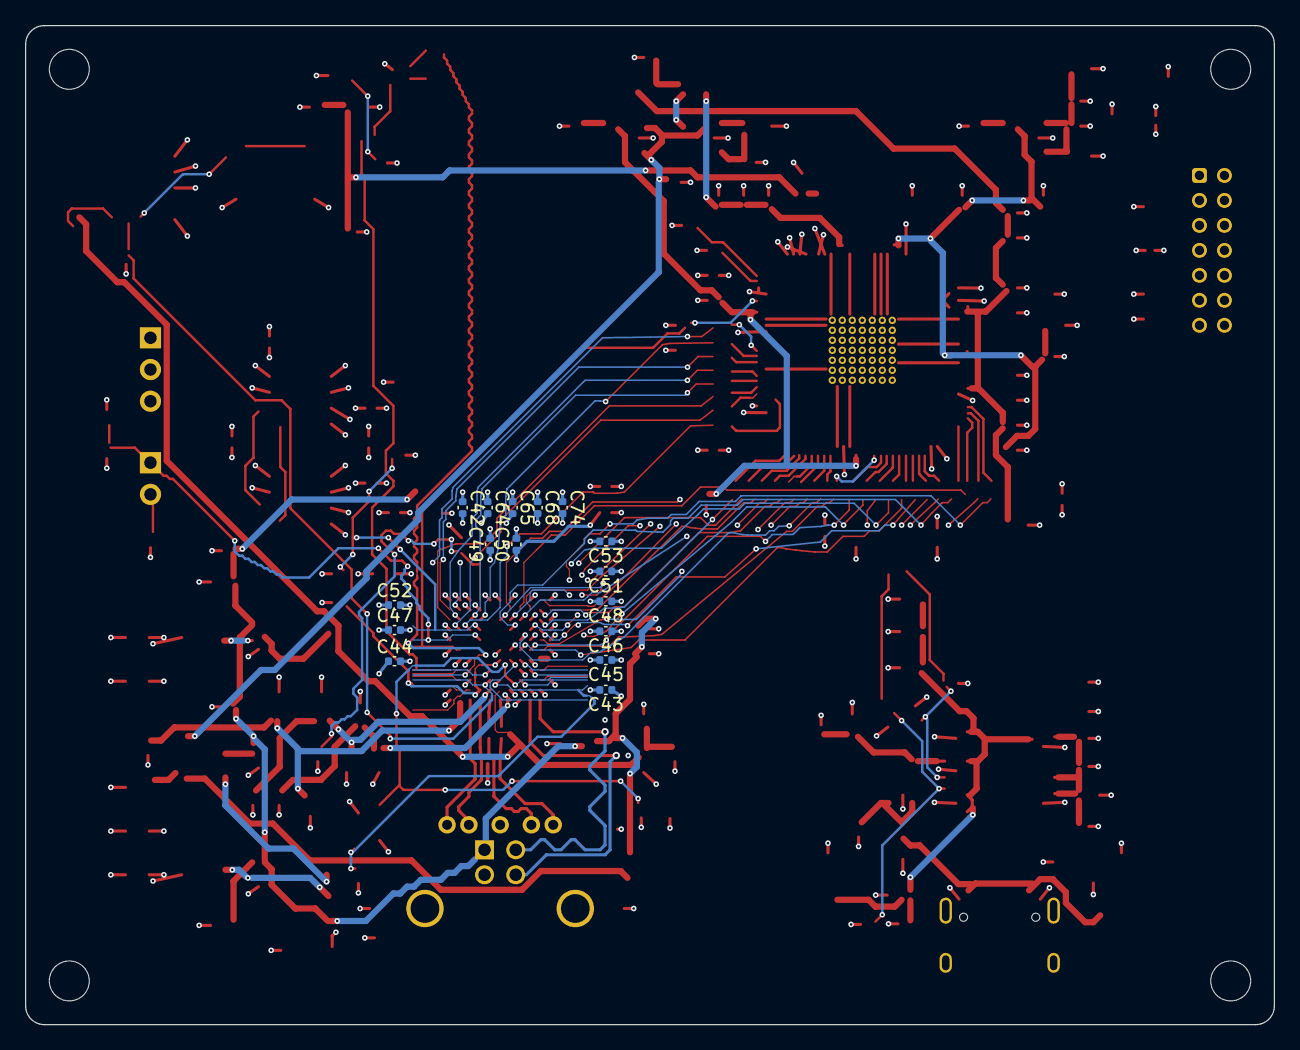
[picture p47: board ps1-av-capture.kicad_pcb from below]

Board: 4 copper layers, 100.0 x 80.0 mm, 237 parts (16 on the bottom side), 162 nets.
