rixnobis/ps1-av-capture/tools/bga_route.py

#!/usr/bin/env python3
"""FX3 BGA escape, phase 2: a grid maze router for U2's signal balls out to the field edge.

Runs after escape.py on the same board. Inside ESC_BOX (U2's ball field plus a skirt) tracks
neck down to 0.1 mm at 0.1 mm clearance, so one track passes between two vias in neighbouring
cells (0.35 mm gap) - the custom rule in ps1-av-capture.kicad_dru holds DRC to the same numbers
there and nowhere else. Rings 1-2 route on F.Cu from the ball; rings 3+ from their dogbone via
on B.Cu, falling back to In2.Cu. Each net runs to the box face its bundle leaves from (GPIF
G/B and syncs west towards U1, GPIF R north, everything else its nearest face) and stops on the
box edge; the bundle beyond is the next script's job. A* on a 0.05 mm grid, 8-connected, one
net at a time, no rip-up: prints what it routed and what it could not.
"""
import fnmatch
import heapq
import math
import sys
from pathlib import Path

import numpy as np
import pcbnew

sys.path.insert(0, str(Path(__file__).resolve().parent))
from route_usb import OX, OY, PCB, footprints, tracks  # noqa: E402
from escape import ring, SKIP_NETS  # noqa: E402
from build_pcb import POWER_NETS  # noqa: E402

G = 0.05                                   # grid step, mm
W, CLR = 0.1, 0.1                          # neckdown track width and clearance inside the box
ESC_BOX = (55.0, 43.0, 69.0, 57.0)         # x0, y0, x1, y1 (board mm)
SKIRT = 1.0                                # rule area BGA_ESC margin past ESC_BOX (gpif_route.NECK)
LAYERS = [pcbnew.F_Cu, pcbnew.In2_Cu, pcbnew.B_Cu]
NX = int(round((ESC_BOX[2] - ESC_BOX[0]) / G)) + 1
NY = int(round((ESC_BOX[3] - ESC_BOX[1]) / G)) + 1


def mm(v):
    return pcbnew.ToMM(v)


# Per-net face overrides. VD_HS (ball K8) is a sync, so its 22R (R34) sits at the west end of
# the B/G row, but its ball is in the G group's rows: leaving west it lands mid-bus on F.Cu
# (between VD_VS and VD_G7, with the B.Cu syncs under it) and every G net peeling north to the
# row has to cross it; with no via room in the 0.2 mm stubs the GPIF router could only get it
# out on In2 across the +1V2 island and the L9 +3V3 channel. North it rises between L8 and L9
# and leaves the island on F.Cu clear of the bundle.
FACE = {"VD_HS": "N"}


def face_for(net, x, y):
    if net in FACE:
        return FACE[net]
    if net.startswith("VD_R"):
        return "N"
    if net.startswith("VD_"):
        return "W"
    d = {"W": x - ESC_BOX[0], "E": ESC_BOX[2] - x, "N": y - ESC_BOX[1], "S": ESC_BOX[3] - y}
    d["S"] += 99                           # south is the USB corridor: nothing else leaves there
    return min(d, key=d.get)


def main():
    board = pcbnew.LoadBoard(str(PCB))
    nets = board.GetNetsByName()
    netid = {}

    def nid(n):
        return netid.setdefault(n, len(netid) + 1)

    # owner[l][j, i]: 0 free, k>0 only net k may use the cell, -1 blocked
    owner = [np.zeros((NY, NX), dtype=np.int32) for _ in LAYERS]

    def stamp(li, net, kind, g, ext):
        """Mark cells whose centre is within ext + CLR + W/2 of the item."""
        r = ext + CLR + W / 2
        if kind == "circle":
            (cx, cy), bx = g, (g[0] - r, g[1] - r, g[0] + r, g[1] + r)
        elif kind == "rect":
            bx = (g[0] - r, g[1] - r, g[2] + r, g[3] + r)
        else:
            (a, b) = g
            bx = (min(a[0], b[0]) - r, min(a[1], b[1]) - r, max(a[0], b[0]) + r, max(a[1], b[1]) + r)
        i0, i1 = max(0, int((bx[0] - ESC_BOX[0]) / G)), min(NX - 1, int((bx[2] - ESC_BOX[0]) / G) + 1)
        j0, j1 = max(0, int((bx[1] - ESC_BOX[1]) / G)), min(NY - 1, int((bx[3] - ESC_BOX[1]) / G) + 1)
        if i0 > i1 or j0 > j1:
            return
        xs = ESC_BOX[0] + np.arange(i0, i1 + 1) * G
        ys = ESC_BOX[1] + np.arange(j0, j1 + 1) * G
        X, Y = np.meshgrid(xs, ys)
        if kind == "circle":
            d = np.hypot(X - cx, Y - cy)
        elif kind == "rect":
            d = np.hypot(np.maximum(np.maximum(g[0] - X, X - g[2]), 0), np.maximum(np.maximum(g[1] - Y, Y - g[3]), 0))
        else:
            ax, ay = a
            vx, vy = b[0] - ax, b[1] - ay
            L2 = vx * vx + vy * vy or 1e-12
            t = np.clip(((X - ax) * vx + (Y - ay) * vy) / L2, 0, 1)
            d = np.hypot(X - ax - t * vx, Y - ay - t * vy)
        hit = d < r - 1e-6
        sub = owner[li][j0:j1 + 1, i0:i1 + 1]
        k = nid(net)
        sub[hit & (sub == 0)] = k
        sub[hit & (sub != k) & (sub != 0)] = -1

    for fp in footprints(board):
        for p in fp.Pads():
            net = p.GetNetname() or f"<nc {fp.GetReference()}.{p.GetNumber()}>"
            pos = p.GetPosition()
            for li, L in enumerate(LAYERS):
                if not p.IsOnLayer(L):
                    continue
                if p.GetShape() == pcbnew.PAD_SHAPE_CIRCLE:
                    stamp(li, net, "circle", (mm(pos.x) - OX, mm(pos.y) - OY), mm(p.GetSize().x) / 2)
                else:
                    bb = p.GetBoundingBox()
                    stamp(li, net, "rect", (mm(bb.GetLeft()) - OX, mm(bb.GetTop()) - OY,
                                            mm(bb.GetRight()) - OX, mm(bb.GetBottom()) - OY), 0.0)
    vias = {}
    for t in tracks(board):
        if t.GetClass() == "PCB_VIA":
            xy = (mm(t.GetPosition().x) - OX, mm(t.GetPosition().y) - OY)
            vias.setdefault(t.GetNetname(), []).append(xy)
            for li in range(len(LAYERS)):
                stamp(li, t.GetNetname(), "circle", xy, mm(t.GetWidth(pcbnew.F_Cu)) / 2)
        else:
            for li, L in enumerate(LAYERS):
                if t.GetLayer() == L:
                    stamp(li, t.GetNetname(), "seg", ((mm(t.GetStart().x) - OX, mm(t.GetStart().y) - OY),
                                                      (mm(t.GetEnd().x) - OX, mm(t.GetEnd().y) - OY)),
                          mm(t.GetWidth()) / 2)

    def cell(x, y):
        return int(round((y - ESC_BOX[1]) / G)), int(round((x - ESC_BOX[0]) / G))

    def on_face(j, i, face):
        return {"W": i == 0, "E": i == NX - 1, "N": j == 0, "S": j == NY - 1}[face]

    def astar(li, k, start, face):
        grid = owner[li]
        ok = lambda j, i: grid[j, i] == 0 or grid[j, i] == k
        goal_d = {"W": lambda j, i: i, "E": lambda j, i: NX - 1 - i,
                  "N": lambda j, i: j, "S": lambda j, i: NY - 1 - j}[face]
        if not ok(*start):
            return None
        openq = [(goal_d(*start), 0.0, start, None)]
        came, best = {}, {start: 0.0}
        steps = [(0, 1, 1), (0, -1, 1), (1, 0, 1), (-1, 0, 1),
                 (1, 1, 1.4142), (1, -1, 1.4142), (-1, 1, 1.4142), (-1, -1, 1.4142)]
        while openq:
            _, g, c, par = heapq.heappop(openq)
            if c in came:
                continue
            came[c] = par
            if on_face(*c, face):
                path = [c]
                while came[path[-1]] is not None:
                    path.append(came[path[-1]])
                return path[::-1]
            for dj, di, cost in steps:
                n = (c[0] + dj, c[1] + di)
                if not (0 <= n[0] < NY and 0 <= n[1] < NX) or not ok(*n):
                    continue
                if dj and di and not (ok(c[0] + dj, c[1]) and ok(c[0], c[1] + di)):
                    continue                       # no corner-cutting past an obstacle
                turn = 0.3 if par is not None and (c[0] - par[0], c[1] - par[1]) != (dj, di) else 0
                ng = g + cost + turn
                if ng < best.get(n, 1e18):
                    best[n] = ng
                    heapq.heappush(openq, (ng + goal_d(*n), ng, n, c))
        return None

    def simplify(path):
        out = [path[0]]
        for a, b, c in zip(path, path[1:], path[2:]):
            if (b[0] - a[0], b[1] - a[1]) != (c[0] - b[0], c[1] - b[1]):
                out.append(b)
        out.append(path[-1])
        return out

    def via_fits(k, x, y):
        """A 0.45 via at (x, y) keeps CLR on every layer: the grid is inflated by W/2 for a
        track centreline, so every cell within 0.225 - W/2 of the centre must be ours."""
        r = int(math.ceil((0.225 - W / 2 + CLR * 0) / G))
        j, i = cell(x, y)
        for lj in range(len(LAYERS)):
            for dj in range(-r, r + 1):
                for di in range(-r, r + 1):
                    if math.hypot(dj, di) * G > 0.225 - W / 2 + 1e-6:
                        continue
                    jj, ii = j + dj, i + di
                    if not (0 <= jj < NY and 0 <= ii < NX):
                        return False
                    o = owner[lj][jj, ii]
                    if o != 0 and o != k:
                        return False
        return True

    def line_ok(li, k, a, b):
        n = max(2, int(math.dist(a, b) / (G / 2)))
        for t in range(1, n):
            j, i = cell(a[0] + (b[0] - a[0]) * t / n, a[1] + (b[1] - a[1]) * t / n)
            o = owner[li][j, i]
            if o != 0 and o != k:
                return False
        return True

    ops = []                       # board edits of the attempt in progress, applied at the end

    def add_track(li, net, a, b, w):
        ops.append(("track", li, net, a, b, w))
        stamp(li, net, "seg", (a, b), w / 2)

    def add_via(net, x, y):
        ops.append(("via", net, x, y))
        for lj in range(len(LAYERS)):
            stamp(lj, net, "circle", (x, y), 0.225)

    def bends_ok(ps):
        """Every corner turns by 45 degrees or less (check_geometry's ACUTE test)."""
        for u, v, w in zip(ps, ps[1:], ps[2:]):
            a1 = math.atan2(v[1] - u[1], v[0] - u[0])
            a2 = math.atan2(w[1] - v[1], w[0] - v[0])
            if abs((a2 - a1 + math.pi) % (2 * math.pi) - math.pi) > math.pi / 4 + 1e-3:
                return False
        return True

    def finish(path, li, k, x, y):
        """Grid path -> polyline from (x, y). Sub-width segments are merged away where the
        straight replacement clears the raster and keeps 45-degree bends; returns the points
        and whether any sub-width segment survived (a staircase squeezing between balls)."""
        pts = [(ESC_BOX[0] + i * G, ESC_BOX[1] + j * G) for j, i in simplify(path)]
        pts[0] = (x, y)               # the ball or via centre, not its nearest grid point
        changed = True
        while changed and len(pts) > 2:
            changed = False
            for q in range(1, len(pts) - 1):
                if (min(math.dist(pts[q - 1], pts[q]), math.dist(pts[q], pts[q + 1])) < 2 * W
                        and line_ok(li, k, pts[q - 1], pts[q + 1]) and bends_ok(pts[:q] + pts[q + 1:])):
                    del pts[q]
                    changed = True
                    break
        if len(pts) > 2 and math.dist(pts[-2], pts[-1]) < 2 * W:
            pts[-2] = pts[-1]          # the last grid step onto the box edge
            del pts[-1]
        stair = any(1e-6 < math.dist(a, b) < 2 * W for a, b in zip(pts, pts[1:]))
        return pts, stair

    u2 = board.FindFootprintByReference("U2")
    jobs = []
    for p in u2.Pads():
        net = p.GetNetname()
        if net in SKIP_NETS or net.startswith(("unconnected", "USB3_")):
            continue
        if any(fnmatch.fnmatchcase(net, pat) for pat in POWER_NETS):
            continue                  # supply nets keep their class width: point-to-point step
        px, py = mm(p.GetPosition().x) - OX, mm(p.GetPosition().y) - OY
        rg = ring(p.GetNumber())
        if rg <= 2:
            starts = [(0, (px, py))]
        else:
            v = min(vias.get(net, []), key=lambda q: math.hypot(q[0] - px, q[1] - py), default=None)
            if v is None or math.hypot(v[0] - px, v[1] - py) > 0.6:
                print("  no dogbone for", p.GetNumber(), net)
                continue
            starts = [(2, v), (1, v)]
        face = face_for(net, px, py)
        dist = {"W": px - ESC_BOX[0], "E": ESC_BOX[2] - px, "N": py - ESC_BOX[1], "S": ESC_BOX[3] - py}[face]
        jobs.append((rg, dist, p.GetNumber(), net, starts, face))
    def attempt(order):
        """Route every job in this order on a copy of the raster; edits go to ops."""
        done, failed, seen_net = [], [], set()
        for rg, _, ball, net, starts, face in order:
            if net in seen_net:                    # FX3_FSLC has several balls: one exit
                continue
            seen_net.add(net)
            k = nid(net)
            x0, y0 = starts[0][1]
            # preferred face first, then the others nearest first (south, the USB corridor, last)
            rest = sorted("WENS".replace(face, ""), key=lambda f: ({"W": x0 - ESC_BOX[0], "E": ESC_BOX[2] - x0,
                          "N": y0 - ESC_BOX[1], "S": ESC_BOX[3] - y0 + 99}[f]))
            res = None
            for f in [face] + rest:
                for li, (x, y) in starts:
                    path = astar(li, k, cell(x, y), f)
                    if path:
                        pts, stair = finish(path, li, k, x, y)
                        if not (stair and rg <= 2):
                            res = (li, pts, f, None)
                        break
                if res:
                    break
            if not res and rg <= 2:
                # boxed in on F.Cu, or only out through a staircase between two balls: drop a
                # dogbone via of its own and leave on an inner layer instead
                for vx, vy in sorted([(x0 + sx * 0.4, y0 + sy * 0.4) for sx in (1, -1) for sy in (1, -1)],
                                     key=lambda q: math.hypot(q[0] - ESC_BOX[0] if face == "W" else 0,
                                                              q[1] - ESC_BOX[1] if face == "N" else 0)):
                    if not via_fits(k, vx, vy) or not line_ok(0, k, (x0, y0), (vx, vy)):
                        continue
                    for f in [face] + rest:
                        for li in (2, 1):
                            path = astar(li, k, cell(vx, vy), f)
                            if path:
                                pts, stair = finish(path, li, k, vx, vy)
                                res = (li, pts, f, (vx, vy))
                                break
                        if res:
                            break
                    if res:
                        break
            if not res:
                failed.append(f"{ball} {net} ring {rg} -> {face}")
                continue
            li, pts, face, via = res
            if via:
                add_track(0, net, (x0, y0), via, 0.2)
                add_via(net, *via)
            L = 0.0
            for a, b in zip(pts, pts[1:]):
                if math.dist(a, b) > 1e-6:
                    add_track(li, net, a, b, W)
                    L += math.dist(a, b)
            done.append(f"{ball} {net} {board.GetLayerName(LAYERS[li])} -> {face} {L:.2f} mm"
                        + (" (own dogbone)" if via else ""))
        return done, failed

    # Two orders, keep the better: ring 2 before ring 1 (a ring-2 ball threads between two
    # ring-1 balls), and ring 1 first (an edge ball ringed in by its neighbours' exits). Via
    # nets go last in both, inner rings last of all.
    base = [o.copy() for o in owner]
    orders = [sorted(jobs, key=lambda j: (j[0] > 2, -j[0] if j[0] <= 2 else j[0], j[1])),
              sorted(jobs, key=lambda j: (j[0], j[1]))]
    best = None
    for n_ord, order in enumerate(orders):
        for li in range(len(LAYERS)):
            owner[li][:] = base[li]
        ops.clear()
        done, failed = attempt(order)
        print(f"  order {n_ord}: {len(done)} out, {len(failed)} failed")
        if best is None or len(failed) < len(best[1]):
            best = (done, failed, list(ops))
    done, failed, chosen = best
    for op in chosen:
        if op[0] == "track":
            _, li, net, a, b, w = op
            t = pcbnew.PCB_TRACK(board)
            t.SetStart(pcbnew.VECTOR2I(pcbnew.FromMM(OX + a[0]), pcbnew.FromMM(OY + a[1])))
            t.SetEnd(pcbnew.VECTOR2I(pcbnew.FromMM(OX + b[0]), pcbnew.FromMM(OY + b[1])))
            t.SetWidth(pcbnew.FromMM(w))
            t.SetLayer(LAYERS[li])
        else:
            _, net, x, y = op
            t = pcbnew.PCB_VIA(board)
            t.SetPosition(pcbnew.VECTOR2I(pcbnew.FromMM(OX + x), pcbnew.FromMM(OY + y)))
            t.SetWidth(pcbnew.FromMM(0.45))
            t.SetDrill(pcbnew.FromMM(0.2))
        t.SetNet(nets[net])
        t.SetLocked(True)
        board.Add(t)
    area = pcbnew.ZONE(board)                      # rule area the .kicad_dru keys on
    area.SetIsRuleArea(True)
    area.SetZoneName("BGA_ESC")
    area.SetDoNotAllowTracks(False)
    area.SetDoNotAllowVias(False)
    area.SetDoNotAllowPads(False)
    area.SetDoNotAllowFootprints(False)
    area.SetDoNotAllowZoneFills(False)
    ls = pcbnew.LSET()
    for L in (pcbnew.F_Cu, pcbnew.In1_Cu, pcbnew.In2_Cu, pcbnew.B_Cu):
        ls.AddLayer(L)
    area.SetLayerSet(ls)
    ol = area.Outline()
    ol.NewOutline()
    # the rule area reaches SKIRT past the router's box, so tools/gpif_route.py can fan the
    # bundle out at 0.1/0.1 before it widens to the netclass rules
    x0, y0, x1, y1 = ESC_BOX[0] - SKIRT, ESC_BOX[1] - SKIRT, ESC_BOX[2] + SKIRT, ESC_BOX[3] + SKIRT
    for x, y in ((x0, y0), (x1, y0), (x1, y1), (x0, y1)):
        ol.Append(pcbnew.FromMM(OX + x), pcbnew.FromMM(OY + y))
    board.Add(area)
    pcbnew.ZONE_FILLER(board).Fill(board.Zones())
    board.Save(str(PCB))
    print(f"bga_route: {len(done)} nets out of the field, {len(failed)} failed")
    for d in done:
        print("  ok", d)
    for f in failed:
        print("  FAILED", f)


if __name__ == "__main__":
    main()
