rixnobis/ps1-av-capture/(commit log)

2026-10-21 Parts stock check for the one-channel board
2026-10-21 Pin tables for TVP7002 and FX3, LCSC footprints
2026-10-21 Schematic rev A: TVP7002 + FX3 + PCM2903C, one channel
    Generated by tools/gen_sch.py; tools/build.sh runs ERC, a netlist check of
    the GPIF bus and supply pins, a pin/pad check and an LCSC readback.
2026-10-21 Footprints: TVP7002 pad and vias per the OSSC, FX3 pads per AN70707; spare boot EEPROM
2026-10-22 Stackup: JLC04161H-3313A, 90 ohm pairs from JLC's solver
2026-10-22 Layout: board outline, 4-layer stackup, net classes, IC and connector placement
2026-10-22 J1: JST PHD 2x7 latching header for a multi-AV pigtail, hand-soldered
    Signals paired with grounds in each column, DNP in the JLC assembly.
    Pigtail pinout and build steps in docs/design.md, hand-built items in docs/parts.md.
2026-10-22 Status LED: common-anode RGB on FX3 GPIO50-52, firmware state map
    XL-1615RGBC-RF (C965840) replaces the GPIO57 debug LED. Its LCSC pattern
    numbers G and B the other way from the datasheet; fix_footprints.py renumbers
    them and applies the datasheet's land pattern. GPIO budget in docs/design.md.
2026-10-22 Layout: place every remaining part
    Power block, LDOs and debug parts by hand; the rest next to the pad they
    serve, pushed out until clear. Rail caps go to an IC on their own sheet,
    spread over its rail pins; 75R terminations sit at J1. No courtyard overlaps.
2026-10-22 Layout: USB 3 corridor placed and routed, pairs length-matched
    SS TX/RX on L1 from the FX3's row A through one flow-through TPD4E05U06 to
    the receptacle; RX wired P-to-N as AN70707 p.22 allows. D+/D- through the
    USBLC6, then L4. route_usb.py matches each pair by 45-degree bumps and prints
    the lengths; L2 GND plane added.
2026-10-22 Layout: L3 supply planes, geometry checker, Freerouting export
    L3 is +3V3 with a +1V2 island under the FX3 and its buck and GND under the
    USB corridor, so the D+/D- run on L4 has a ground reference. check_geometry.py
    from ps1-port-tap; the USB routing had 10 findings (90-degree corners, sub-width
    jogs) and now has none. Hand routes are locked for the autorouter.
2026-10-22 Layout: 0.45/0.2 vias and a 1.5 mm escape ring around U1/U2
    Freerouting pass 2 with these: fanout escaped 489/802 SMD pins (pass 1: 499),
    best routing 131 unrouted (pass 1: 164). Not converging; the next step is a
    scripted plane fanout so the router only sees signal nets.
2026-10-22 Layout: scripted plane fanout before the autorouter
    fanout.py stubs every SMD pad on GND/+3V3/+1V2 to a 0.45 mm via where its plane
    covers the spot (FX3 balls dogbone into the diagonal gap, TVP7002 ground pins
    strap onto the exposed pad): 238 of 284 pads. +1V2 island cut back to the FX3
    and its own buck; plane nets get their own 0.25 mm class.
2026-10-22 Layout: L3 opened to signals, 0.5 mm placement gap
    Freerouting with only L1/L4 for signals stalled at 89 unrouted (16 violations)
    after the plane fanout. L3 keeps its supply pours and now also takes signals,
    except over the GND island under the USB corridor (rule area: no tracks).
2026-10-22 Layout: 22R series terminations hand-placed in pin order
    The autoplacer scattered the 34 data/sync terminations around U1, some on the
    far side from U2. They now sit just outside U1's escape ring in pin order (B/G
    and DATACLK in a row under the south pins, R in a column east, syncs west), so
    each bus fans out on L1 with no crossings before the scripted GPIF run.
2026-10-23 Layout: FX3 plane balls fanned out, +3V3 channels through the +1V2 island
    fanout.py counted BGA balls as vias in its same-net hole-to-hole check, so
    every dogbone was rejected by its own ball (0.57 mm < 0.7 mm) and no U2 plane
    ball was ever fanned. The spacing check now covers vias only: fanout leaves 7
    pads for the router (was 37).
    U2's six +3V3 balls sit over the L3 +1V2 island; each one's dogbone via now
    lands in a +3V3 channel running out past the island edge to the main pour.
    DRC lists no unconnected +3V3 or U2 plane pad.
2026-10-23 Layout: FX3 escape router (not yet in the build), escape-box DRC rules
    tools/bga_route.py is an A* grid router (0.05 mm, 8-connected, per-layer
    net-ownership raster) for U2's signal balls out to the edge of a 14 mm box:
    rings 1-2 on F.Cu, inner rings from their dogbone vias on B.Cu/In2, with a
    boxed-in ring-1/2 ball dropping a via of its own. It routes 53 of 55 nets
    out (A2 FX3_U3RX and K1 VD_R4 fail). It needs 0.1 mm clearance inside the box,
    which ps1-av-capture.kicad_dru grants against a BGA_ESC rule area, but
    kicad-cli 10.0.7 does not apply the rules file here (an unconditional rule and
    a bogus constraint both change nothing), so the router stays out of build.sh
    and the committed board i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
2026-10-23 DRC rules: units on every value, so kicad-cli loads them
    kicad-cli 10.0.7 drops a .kicad_dru that fails to parse without a message, and
    bare numbers fail to parse (pcbnew's Python DRC says so: 'Missing units').
    With mm on every value the escape-box rule applies: the router stage goes from
    165 clearance violations to 0, and raising the box clearance to 0.12 mm brings
    back 499. Outside the box the rule restates the 0.15 mm netclass clearance.
2026-10-23 Layout: FX3 escape router in the build, 49 of 50 nets out
    bga_route.py now leaves the supply nets (build_pcb POWER_NETS) to the
    point-to-point step, drops sub-width segments where the straight replacement
    still clears and keeps every bend at 45 degrees. check_geometry holds tracks
    inside the BGA_ESC rule area to the 0.1 mm neckdown instead of their class
    width (with the area renamed, 174 NECKED come back). DRC: no copper errors,
    49 escape ends dangle until the bundle lands. Open: K1 VD_R4 finds no way
    out; VD_R8 squeezes between J1/K2 in a 0.05 mm staircase (4 SHORT, 1 ACUTE).
2026-10-23 Layout: GPIF bundle router, first cut (not yet in the build)
    tools/gpif_route.py routes each VD_* net from its FX3 escape end to the VD
    pad of its 22R: A* over three layers with vias, 0.1/0.1 inside the escape box
    plus a 1 mm skirt (the BGA_ESC rule area is widened to match), 0.127 mm at
    0.15 clearance beyond. New GPIF netclass (VD_*, 0.127 mm). No vias within
    2 mm of the resistor pads; lanes ordered so the first net to peel off owns
    the lane nearest the pads.
    Best result 22 of 29, DRC copper-clean. The same 7 fail in every order
    (VD_B3/B6/B7/B8, VD_R6, VD_FID, VD_HS) and each routes when alone: the escape
    order at the FX3 face does not match the row order, so greedy one-net-at-a-
    time rout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
2026-10-24 gpif_route: negotiated-congestion mode behind --negotiate
    PathFinder-style rip-up: every net reroutes each round, sharing a cell costs
    pf per occupant (x1.6 per round) plus a per-cell history of conflicts; a net's
    occupancy is a per-layer union so its own joints do not count against it, and
    the final commit checks both directions plus via-to-via spacing. On this board
    it does not converge (about 20 nets in conflict after 10 rounds, 16 commit),
    so greedy stays the default (22 of 29). The board stays at the bga_route stage.
2026-10-24 Layout: GPIF bundle routed, 29 of 29 VD nets TVP7002 -> FX3
    The seven nets that never routed were not losing on congestion: every one
    stopped after a few thousand A* expansions with the search space exhausted.
    Four leave the escape box on B.Cu at x=55, 0.2 mm apart, and face the B.Cu
    +1V2 decap column 1.5 mm west with its plane vias; the router allowed no
    layer change inside the neckdown skirt, so they were sealed in. Vias are now
    allowed there (GPIF_VIA_IN_NECK), every via keeps 0.4 mm hole-to-hole from
    every other, and each escape end gets a short reserved exit.
    Also: the sync 22Rs moved into the row under U1 (left of DATACLK).
    DRC: no copper errors, no unconnected VD_ net. Lengths 15.5-5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
2026-10-24 gpif_route: collapse grid staircases and reversals
    One simplify() for both routers: vertex/staircase deletion, 45-degree corner
    chamfers, neck-edge vertex kept on the edge, exact DRC-clearance checks.
    Sealed escape ends branch off their stub (stub trimmed) instead of doubling back.
    VD_* check_geometry: SHORT 53->7, ACUTE 17->0, OVERLAP 7->0, DANGLING 18->0;
    29/29 routed, DRC 0 violations; 840.8->813.2 mm, 43->46 vias.
2026-10-24 fanout: one stub per plane pad
    A pad that already holds a same-net via (L3/C94, L1/C84) or sits under a fanned pad
    (J3 A1/B12) is left on that via; a stub may not run over a same-net via or stub.
    Clears the 2 ACUTE GND and 2 OVERLAP +1V2/+3V3 findings. Unconnected 283 -> 283.
2026-10-24 p2p_route: supplies, plane stitches, point-to-point signals
    New last build stage: A* on F.Cu/B.Cu per net, FX3 supply balls dogboned first.
    Unconnected 283 -> 112: supplies 105 -> 3, plane nets 13 -> 5, FX3_U3TX/RX 6 -> 0,
    crystals/I2C/FSLC/22R/reset/LED/PMODE 72 -> 17. DRC 0 violations.
2026-10-25 tools: iterate footprints and tracks in a fixed order
    KiCad saves items in UUID order and each build mints new UUIDs, so fanout's
    first-come plane vias moved between builds and gpif's VD routes with them.
    Two builds of bga-stage: 31 differing track/via lines before, 0 after;
    gpif twice on them: identical. gpif_route takes --board.
2026-10-28 gpif_route: VD_HS escapes north, bundle kept off In2 planes
    VD_HS leaves K8 north on F.Cu (38.1 mm, 0 vias; was west, 41.2 mm, 2 vias). In2 is
    closed to the bundle over +1V2/+3V3 outside the escape box; F.Cu U1->22R paths kept clear.
    vs a fresh 49b060d build: GPIF 29/29 both, DRC 0 copper, unconnected 111 -> 96,
    In2 breaks >=0.25 mm2 +1V2 5 -> 1, +3V3 4 -> 1, VD_ SHORT 5 -> 2. TVP_HSOUT now unrouted.
2026-10-28 p2p_route: route the four west TVP outs innermost-corner first
    TVP_FIDOUT/VSOUT/HSOUT/SOGOUT share one escape south of U1 pins 22-25; the
    earlier-routed net walls in the later ones, so TVP_HSOUT's pin was sealed
    (no path, 816 expansions) and left unrouted at 1be4c63. Routing SOG, HS, VS,
    FID (was FID, VS, HS, SOG) lets each reach its 22R first.
    TVP_HSOUT now connected; unconnected 96 -> 95. GPIF 29/29, DRC 0 copper,
    In2 breaks >=0.25 mm2 +1V2 1, +3V3 1 (unchanged), no new NECKED/SHORT. Two
    builds: identical sorted track lists.
2026-11-12 hat: one-channel CH32H417 hat schematic generator
2026-11-12 hat: outline, headers from the dev-board DXF, placement
2026-11-12 hat: deterministic schematic and board UUIDs
2026-11-13 hat: routed, planes, DRC clean
    In1 solid GND, In2 power pours (+5V, +3V3, +2V5, +3V3A, +1V9A/D, AVDD, PLLVDD, 3V3_AUD, VBUS_AUD,
    OSC_VDD) plus GND fill, B.Cu GND fill, plane vias at every SMD GND/supply pad, board-edge stitching.
    Freerouting via DSN/SES (not deterministic: build gates on DRC, plane check and dangling/zero-length
    findings), then prune/tidy/join/trim passes in hat/tools. Placement: C40, TP1-3 fixed, 22R row moved
    1.1 mm south (wider escape channel). Netclasses and DRC rules rewritten for the hat.
2026-11-13 hat: refill zones after the tidy pass, gate DRC on the committed fill
    The tidy pass moved copper after the last refill, so the committed pours were
    stale (21 track-to-GND clearance errors without --refill-zones). Refill after
    tidy and drop --refill-zones from the error gate so a stale fill fails the build.
